levichevdmitry/spirt_v2/foto/20170216_203848.jpg

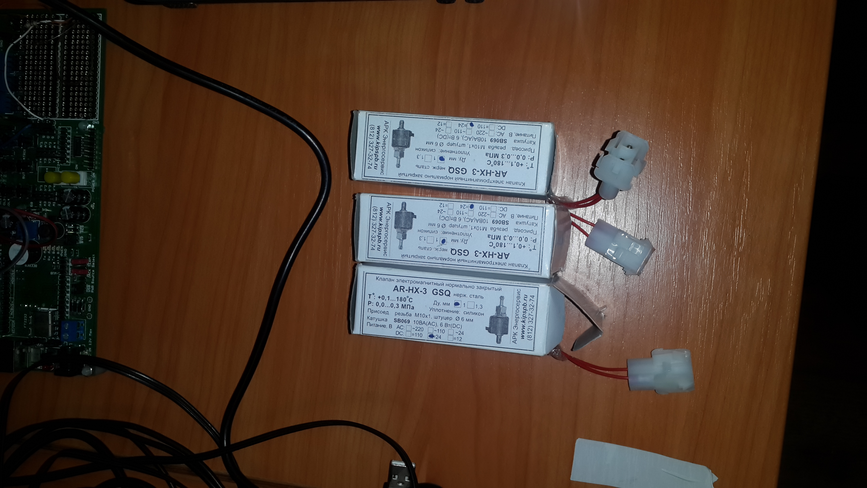
foto/20170216_203848.jpg
