levichevdmitry/spirt_v2/foto/20170225_220355.jpg

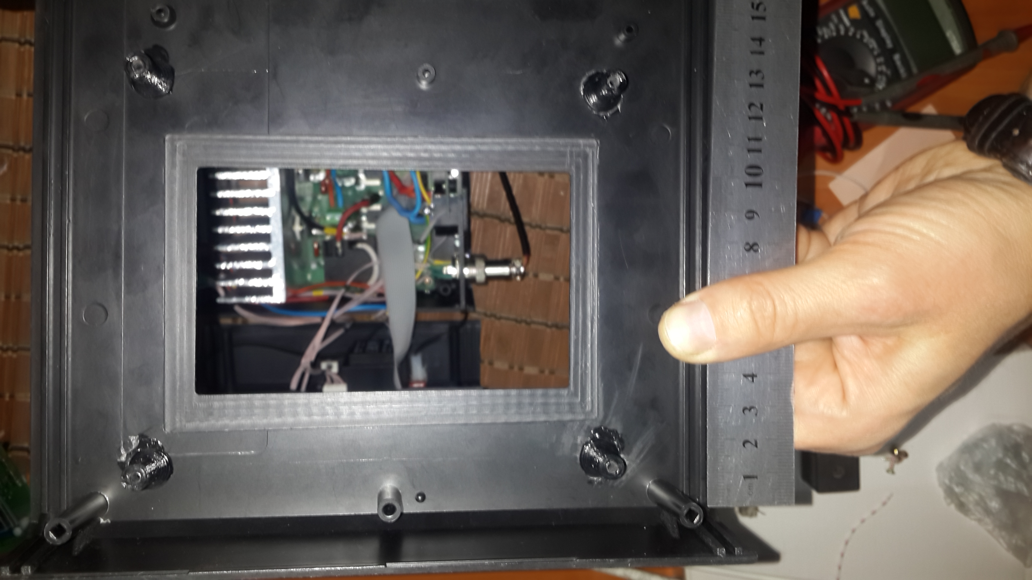
foto/20170225_220355.jpg
