levichevdmitry/spirt_v2/general_hw/Спецификации/доп элементы.docx

№ пп | Наименование | Референс | Количество | Корпус | Фото | Ссылка

Датчики

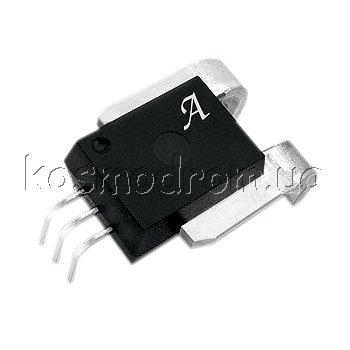
[picture p3: figure]

| ACS758LCB-050B-PFF-T Датчик тока Ток - чувствительный 50A. Точность -1.2% ~ 2%. Чувствительность 40mV/A. Ток выходной 10mA. Тип Чувствительного элемента Open Loop Current Transducers. Напряжение питания 3 V ~ 5.5 V. Частота 120kHz. | ACS758LCB-050B-PFF-T | 1 | 5-PINMODULEPFF | | http://kosmodrom.com.ua/prodlist.php?page=0&name=ACS758&okbutton=%CF%EE%E8%F1%EA+%EF%EE+%F1%EA%EB%E0%E4%F3

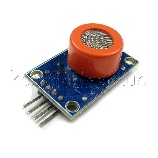
[picture p4: figure]

| Analog Alcohol Sensor-MQ3 Детекторы газа Аналоговый датчик газа: алкоголь, бензин | MQ3 | 1 | Датчик паров | | http://www.kosmodrom.com.ua/el.php?name=AASMQ3
| Штекер 3.5 (наушники) стерео металл, золото | | 3 | Подключение датчиков температуры | | http://aliot.com.ua/?item=32672&cat=4577

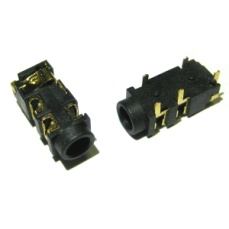
[picture p5: figure]
Гнездо 3.5 (наушники) на плату 5pin

| Гнездо 3.5 (наушники) на плату 5pin | | 6 | | | http://aliot.com.ua/?item=32220&cat=4577

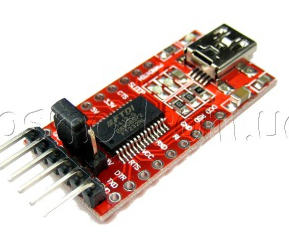
[picture p6: figure]

| USB/UART модуль на основе FT232RL с разъемом miniUSB | | 2 | | | http://kosmodrom.com.ua/el.php?name=FT232RL-MINI-ARDUINO

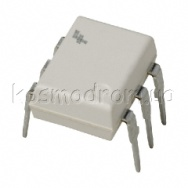
[picture p7: figure]

| MOC3043M Твердотельные реле Твёрдотельное реле: 400В, 0.1 А | MOC3043M | 4 | DIP6-300 | | http://kosmodrom.com.ua/el.php?name=MOC3043M
| Твердотельные реле для установки на панель MOC3023M | MOC3023M | 4 | DIP6-300 | | http://kosmodrom.com.ua/el.php?name=MOC3023M

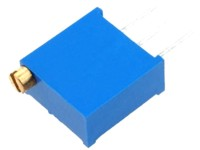
[picture p8: figure]

| 3296W-10K Резистор подстроечный 3296W Потенциометр многооборотный 3/8 10кОм серия 3296W | | 10 | 3296W | | http://kosmodrom.com.ua/el.php?name=3296W-10K

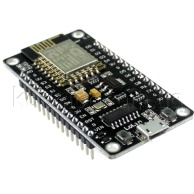
[picture p9: figure]

| Модуль WI-FI ESP8266-NodeMcu | | 2 | | | http://kosmodrom.com.ua/el.php?name=ESP8266-NodeMcu
| Беспроводной контроллер доступа MFRC-522-RFID-KIT | | 1 | | | http://kosmodrom.com.ua/el.php?name=MFRC-522-RFID-KIT
