levichevdmitry/spirt_v2/power_module/src/stm32/readme.txt

ПО для силового модуля контроллера "Спирт" вер. 2

Версия 0.1.1 от 16.03.17
Реализован базовый функционал:
- Обмен и управление по протоколу Wake
- ПИД регулятор для ТЭНов 2,3
- Измерение среднекваратичного значения токов для ТЭНов и функция скользящего среднего с окном в 2 секунду
- Расчет мощности ТЭНов.
- Работа с датчиком температуры DS18B20

Необходимые доработки:
- сделать алгоритм автоматической калибровки датчиков тока при отключенных нагрузках.
- сделать автоматическое измерение опорного напряжение и изменить расчет сигнала датчиков тока на основе полученного значения.
- исправить алгоритм расчета температуры процессора.
- разработать алгоритм автоматического подхвата датчика температуры.

Версия 0.2 от 27.03.17
Реализованы следующие функции:
- Возможность скомпилировать с 2-мя разными методами управления мощностью ТЭН 2 ШИМ или алгорим Бренхема
- Точность регулирования уменьшена до 1 %, а цикл регулирования уменьшен до 1 сек.
- Добавлена возможность компиляции с экспоненциальным фильром  для расчета мощности для ТЭНа 2
- При выключенном ТЭНе 2 значение с датчика тока приравнивается 0.
- Управляющий импульс отпирания симисторов в 5 мс формирмируется таймером 6.
- Протестирован алгоритм подхвата датчика. Алгоритм работоспособный в рамках тестов.

Аппаратные изменения Rev A.0
- Емкости в ФНЧ датчиков тока уменьшены до 47нФ.
- Добавлен дросель в цепи 5 В для птания датчиков тока.
- ИИП от блока управления зашумляет питание, что влечет не корректные измерения тока. "Иглы" помех достигают амплитуды 0,7В 
в цепях питания датчиков тока
- В цепях управления ТЭНами индикаторные светодиоды заменены на красные с меньшим падением напряжения, в следствии чего
сопротивления в 5,6 Ом были оставлены, а надежность коммутации выросла
- Оптосимистор для канала ТЭНа 2 был заменен с MOС3042 на MOC3022 (без втроенного детектора ноля), на случай перехода на СИФУ
- Произведена тестовая настройка ПИД регулятора для стабидизации мощности Кп - 0.61  Ки - 0.2

Необходимые доработки:
- сделать алгоритм автоматической калибровки датчиков тока при отключенных нагрузках.
- сделать автоматическое измерение опорного напряжения и изменить расчет сигнала датчиков тока на основе полученного значения.

Версия 0.21 от 18.04.17
Реализованы следующие функции:
- исправлен алгоритм расчета температуры процессора.

Версия 0.3 от 13.01.18
Реализованы следующие функции:
- исправлена ошибка с некоректным состоянием бита подключенного датчика температуры (теперь в нем 1 при подключенном датчике)
- добавлена обработка отсутсвия датчика температуры, если он отвалился или не подключен вообще, то включаем вентилятор совместно
с насосом.
- увеличен до 2 с. интервал между опросом датчика температуры охлаждающей жидкости.
- добавлен обработчик ошибки ORE для USART 1-wire

TO DO:
- корректный алгоритм расчета мощности (тока)
- нормальная реализация ПИД регулятора, хотя вожможно это не понадобиться, если ОС по току станет без всплексков.
