levichevdmitry/spirt_v2/info/Обмен с Wi-Fi модулем.docx

Отправка данных из контроллера в модуль Wi-Fi осуществляется через UART в формате данных JSON. Структура данных выглядит следующим образом:

{

mode:1,

smode:5,

time:”00:10:00”,

t_elapsed:20,

q_fact:180,

v_get:1230,

t_kub:73.5,

p_kub:8.5,

t_koln:45.6,

t_kolv:40.7,

t_oj:20,

f_oj:1.8,

pwr:4.31,

alcopdk:false,

stop_cnt:0,

eta:#AF23

}

Описание полей:

mode – код режима работы аппарата.

smode – код итерации в текущем режиме.

time – время работы в данном режиме.

t_elapsed – время в текущей итерации в мин.

q_fact – фактически отобранный объем в мл.

v_get – скорость отбора в мл/ч.

t_kub – температура в кубе.

p_kub – давление в кубе.

t_koln – температура низа колонны.

t_kolv – температура верха колонны.

t_oj – температура охлаждающей воды.

f_oj – расход воды через дефлегматор.

pwr – подводимая мощность.

alcopdk – статус датчика спирта.

stop_cnt – количество остановок при отборе во время ректификации.

eta – слово состояния силового блока (расшифровку битов смотреть в документе по протоколу Wake)
