levichevdmitry/spirt_v2/general_hw/Спецификации/Спецификация_компоненты_ремонт.docx

Спецификация элементов для ремонта силового блока

№ | Наименование | Референс | Кол-во | Примечание | Фото | Ссылка


| BTA204S-600E.118 Симистор Тип симистра: Logic - Sensitive Gate: Конфигурация: Single: Ток - удержания (макс.): 12mA: Напряжение - закрытого состояния: 600В | BTA204S-600E.118 | 6 | DPAK | | http://kosmodrom.com.ua/el.php?name=BTA204S-600E.118


| (CL-21) 0,01 mkf - 630v (±10%) Металлоплёнка Конденсаторы металлопленочные CL21 (MEF) Конденсатор металлопленочный полиэстеровый: 0,01 мкф. 630 В. 10 %. | | 5 | | | http://kosmodrom.com.ua/el.php?name=CL-21-0.01-630-10


| BH-16 Разъемы IDC/BH Вилка в плату 16 конт. шаг 2.54мм | BH-16 | 5 | | | http://kosmodrom.com.ua/el.php?name=BH-16


| 0216001.MXP Предохранитель плавкий Предохранитель: плавкая вставка: замедленного действия: 1А, 250 В. | 0216001.MXP | 4 | 5 х 20 мм | | http://kosmodrom.com.ua/el.php?name=0216001.MXP
| 0216002.MXP Предохранитель плавкий Предохранитель: плавкая вставка: замедленного действия: 2А, 250 В. | 0216002.MXP | 4 | 5 х 20 мм | | http://kosmodrom.com.ua/el.php?name=0216002.MXP

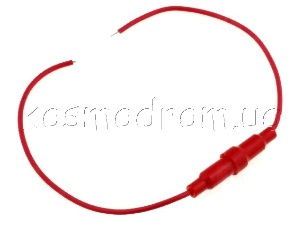
[picture p91: figure]

| ZH9-20ZP Держатель предохранителей | ZH9-20ZP | 4 | | | http://kosmodrom.com.ua/el.php?name=ZH9-20ZP

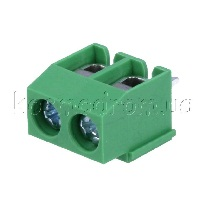
[picture p92: figure]

| Клеммник DEGSON DG126-5.0-02P-14-00AH | DG126-5.0-02P-14-00AH | 6 | | | http://kosmodrom.com.ua/el.php?name=DG126-5.0-02P-14-00AH

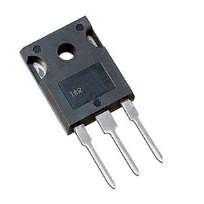
[picture p93: figure]

| Транзистор IGBT производства IR IRG4PC50UDPBF | IRG4PC50UDPBF | 2 | | | http://kosmodrom.com.ua/el.php?name=IRG4PC50UDPBF

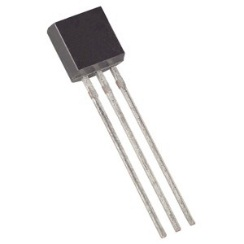
[picture p94: figure]

| 2SA1015 Транзистор биполярный | 2SA1015 | 4 | | | http://kosmodrom.com.ua/prodlist.php?page=0&name=a1015&okbutton=%CF%EE%E8%F1%EA+%EF%EE+%F1%EA%EB%E0%E4%F3
