levichevdmitry/spirt_v2/3d_models/korpus/G771/g769_g770_g771.pdf

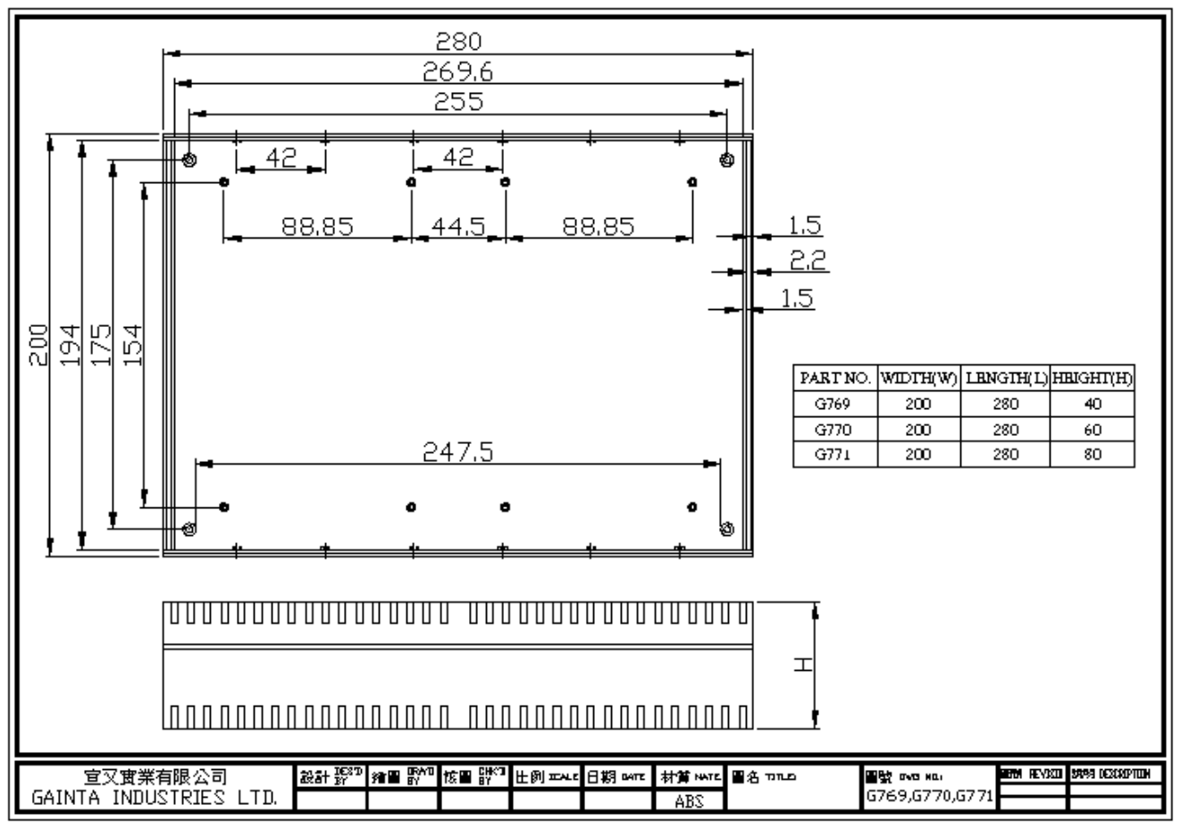
[picture p95: page 1]
