levichevdmitry/spirt_v2/foto/20170102_151930.jpg

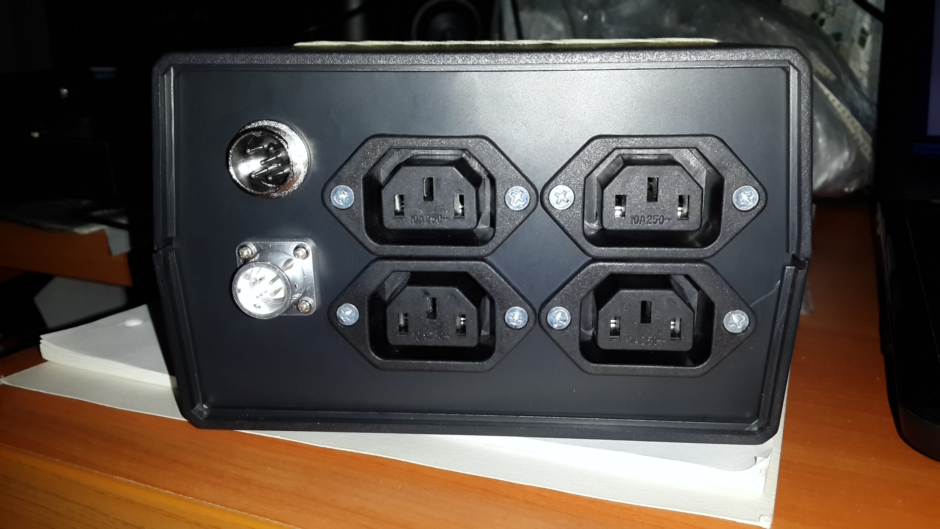
foto/20170102_151930.jpg
