levichevdmitry/spirt_v2/foto/20170102_151950.jpg

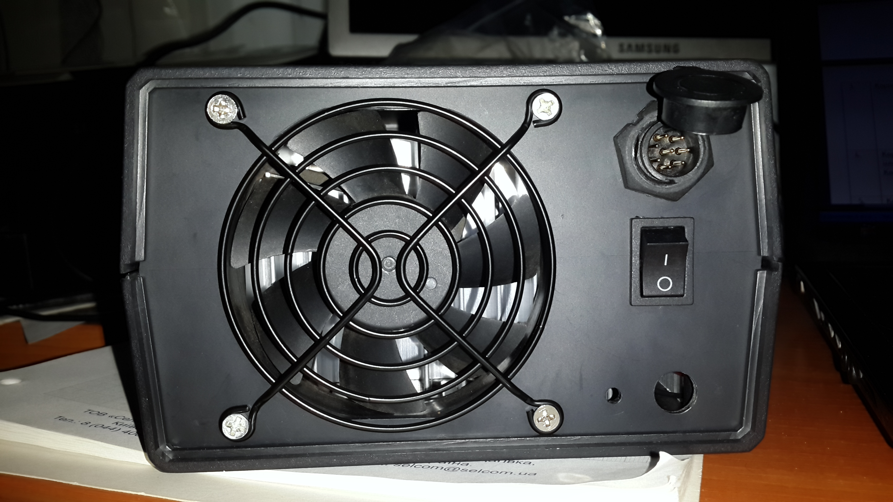
foto/20170102_151950.jpg
