levichevdmitry/spirt_v2/foto/20170104_195338.jpg

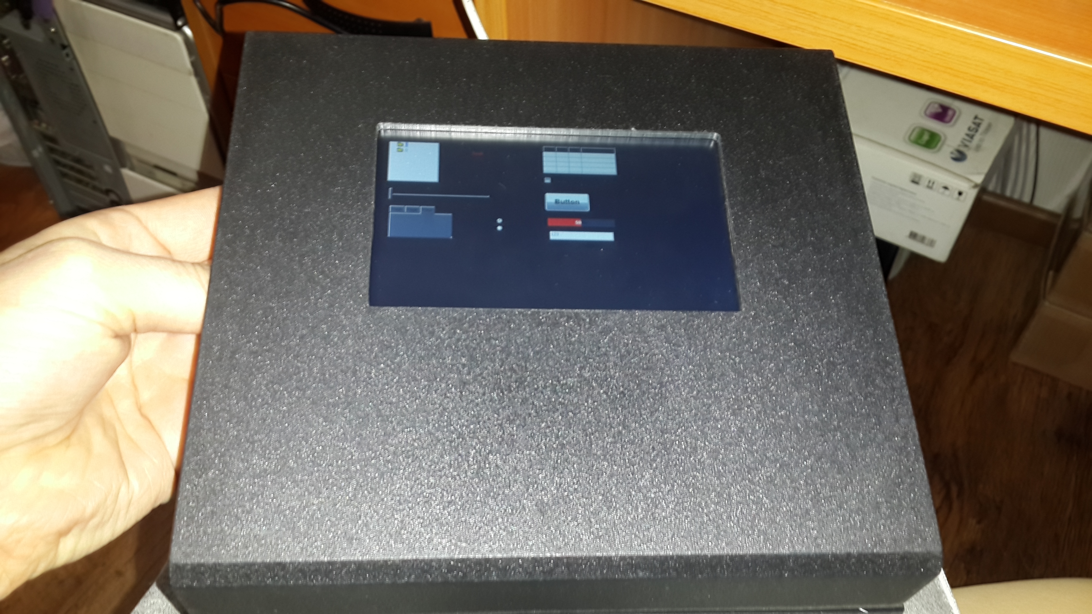
foto/20170104_195338.jpg
