levichevdmitry/spirt_v2/foto/20170129_213145.jpg

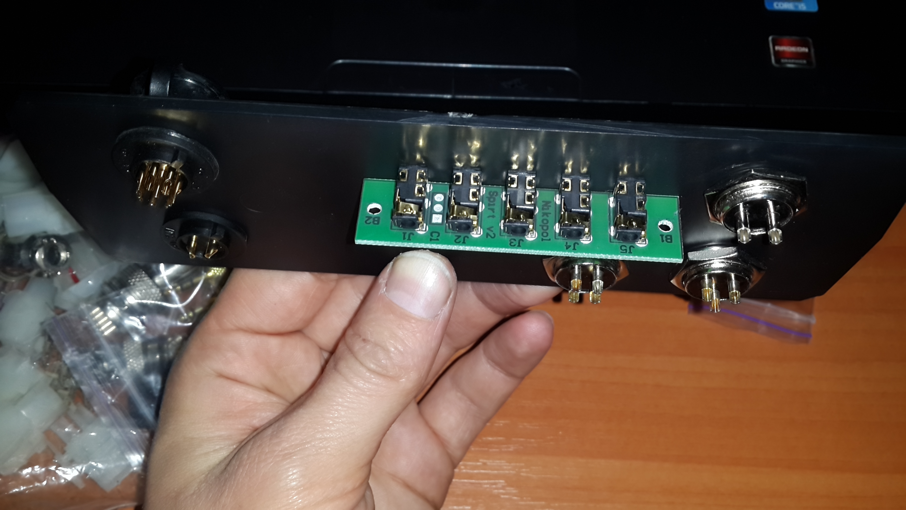
foto/20170129_213145.jpg
