levichevdmitry/spirt_v2/foto/20170201_000536.jpg

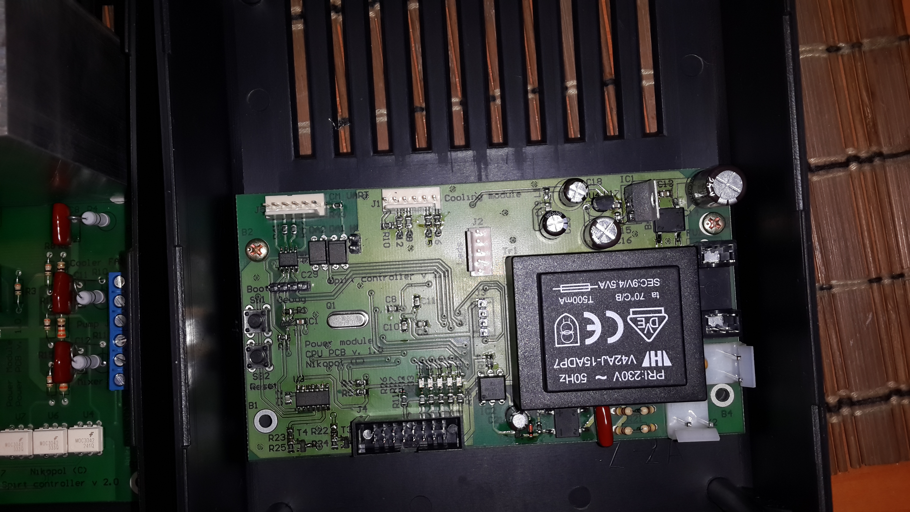
foto/20170201_000536.jpg
