levichevdmitry/spirt_v2/foto/20170201_000550.jpg

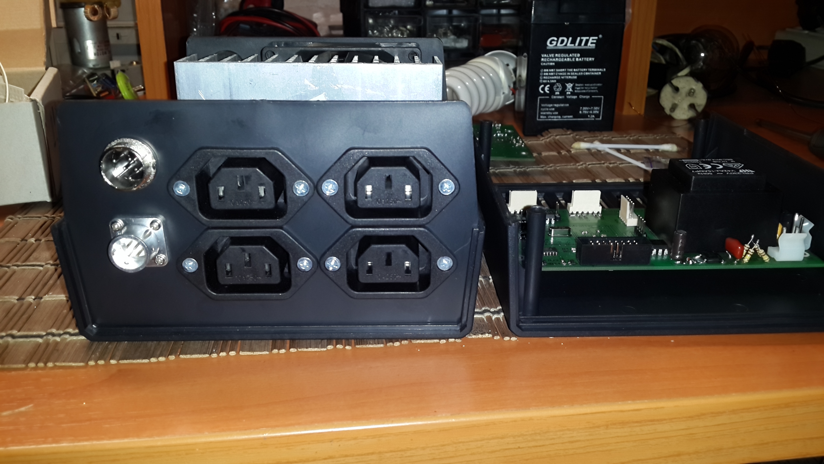
foto/20170201_000550.jpg
