levichevdmitry/spirt_v2/foto/20170204_110750.jpg

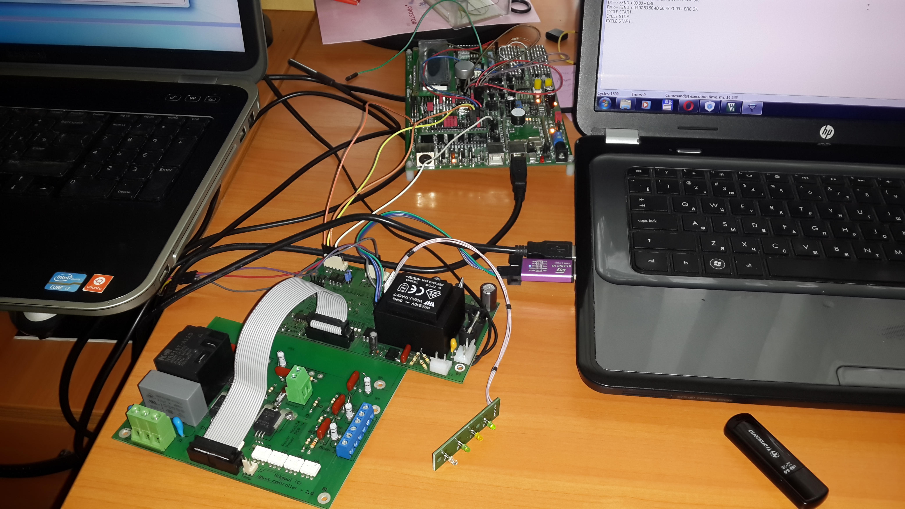
foto/20170204_110750.jpg
