levichevdmitry/spirt_v2/foto/20170205_154931 - копия.jpg

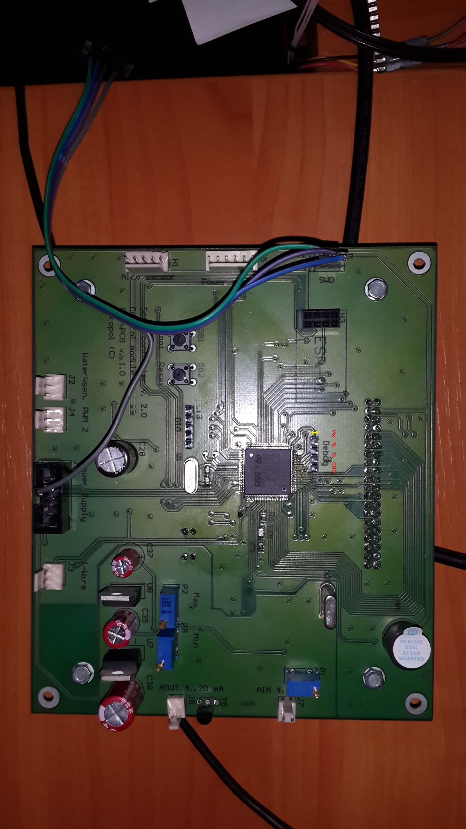
foto/20170205_154931 - копия.jpg
