levichevdmitry/spirt_v2/foto/20170205_154945.jpg

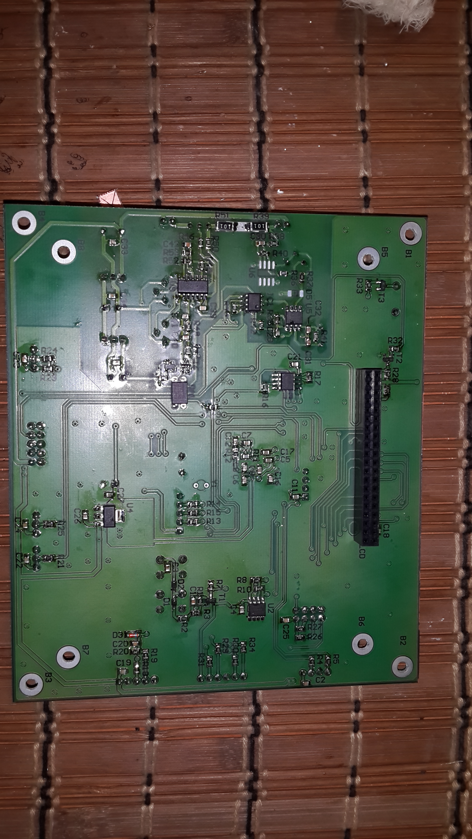
foto/20170205_154945.jpg
