levichevdmitry/spirt_v2/foto/20170205_160607.jpg

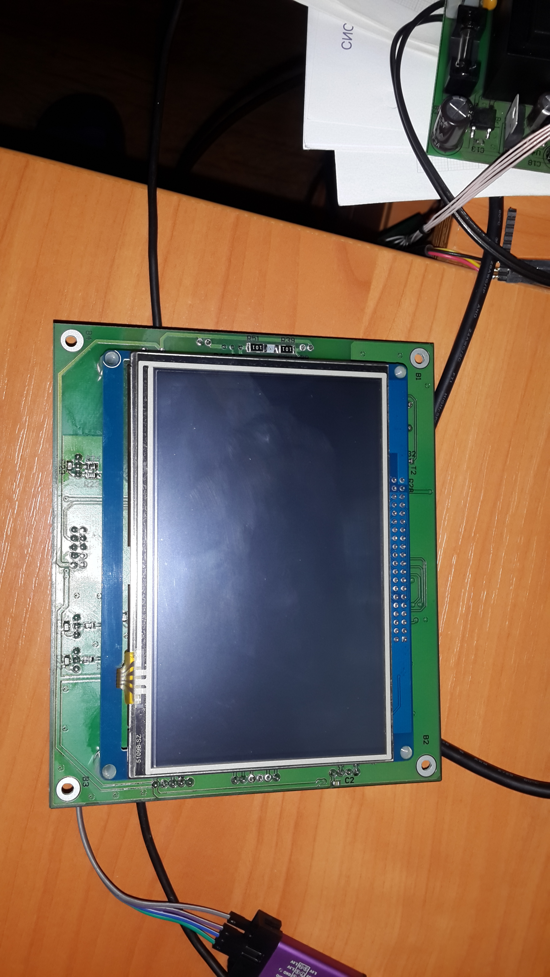
foto/20170205_160607.jpg
