levichevdmitry/spirt_v2/foto/20170208_192222.jpg

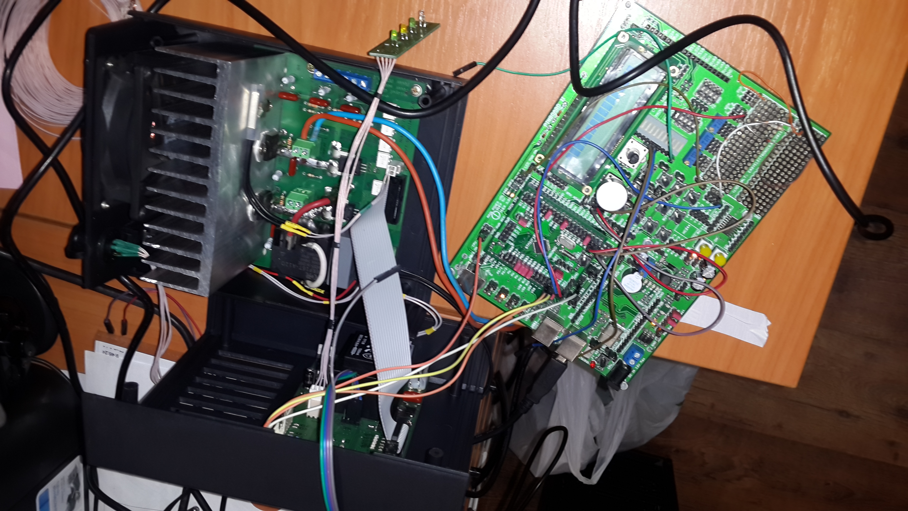
foto/20170208_192222.jpg
