levichevdmitry/spirt_v2/foto/20170212_151312.jpg

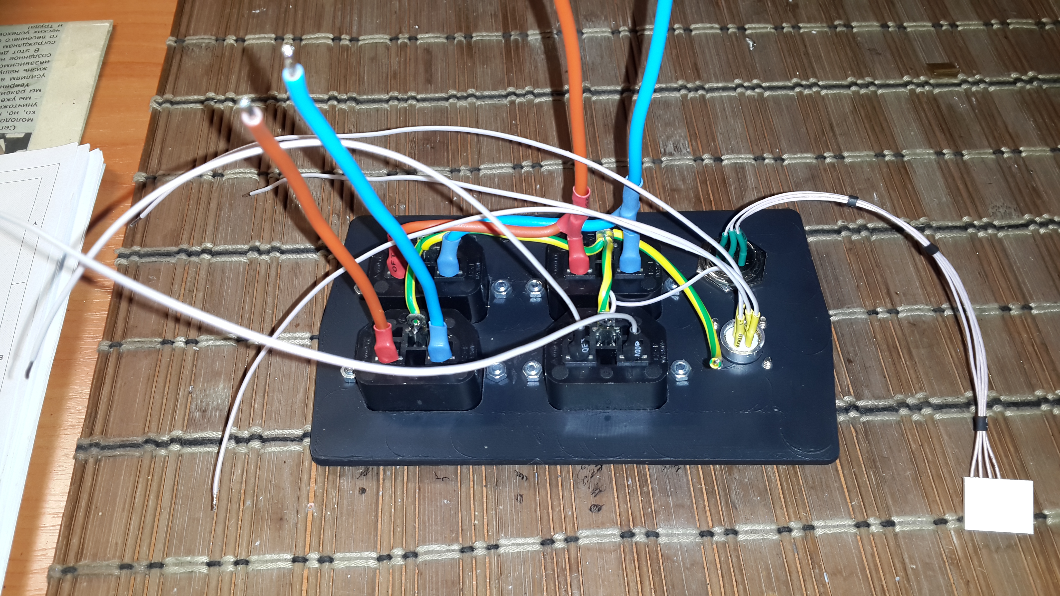
foto/20170212_151312.jpg
