levichevdmitry/spirt_v2/foto/20170213_213228.jpg

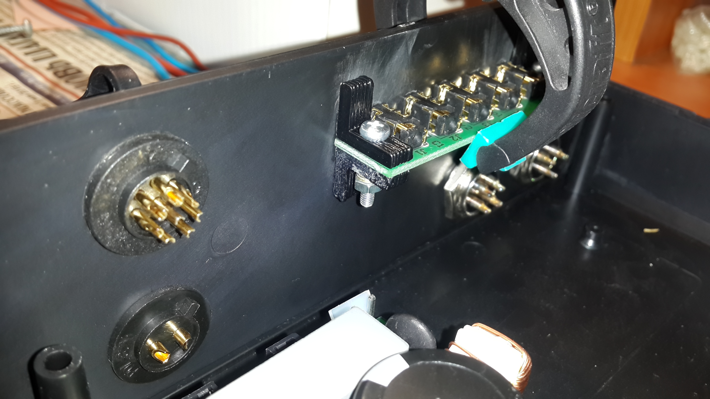
foto/20170213_213228.jpg
