levichevdmitry/spirt_v2/foto/20170214_220130.jpg

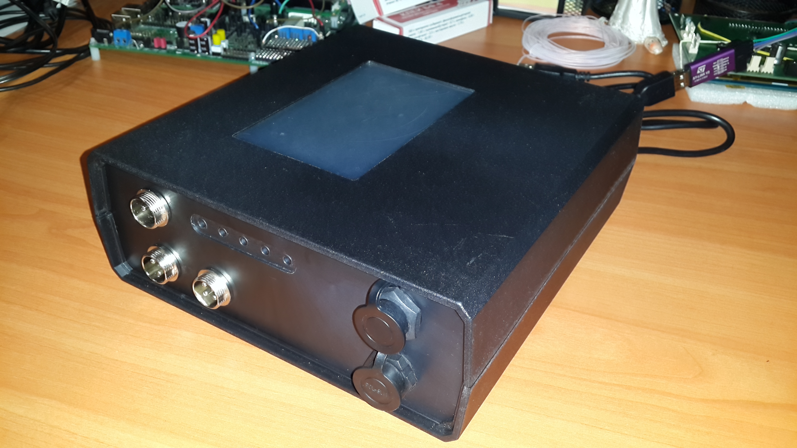
foto/20170214_220130.jpg
