levichevdmitry/spirt_v2/foto/20170214_220557.jpg

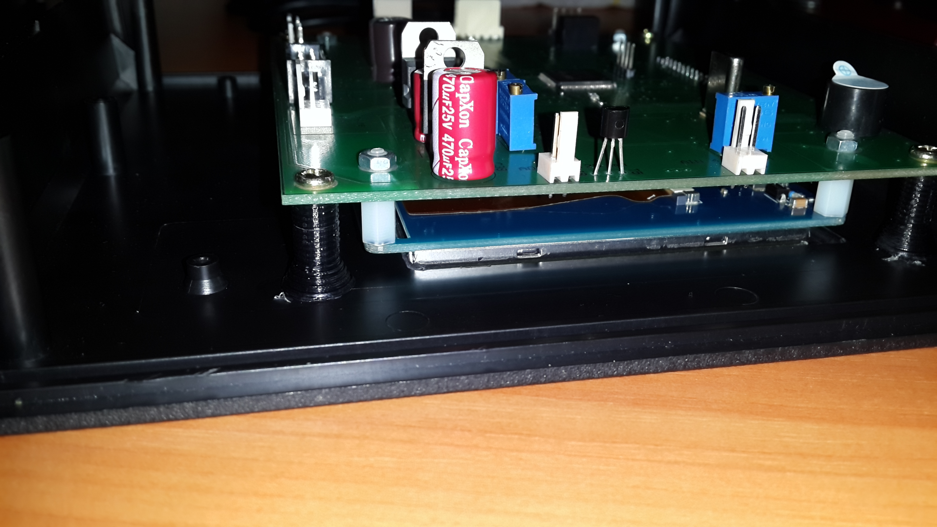
foto/20170214_220557.jpg
