levichevdmitry/spirt_v2/foto/20170214_220602.jpg

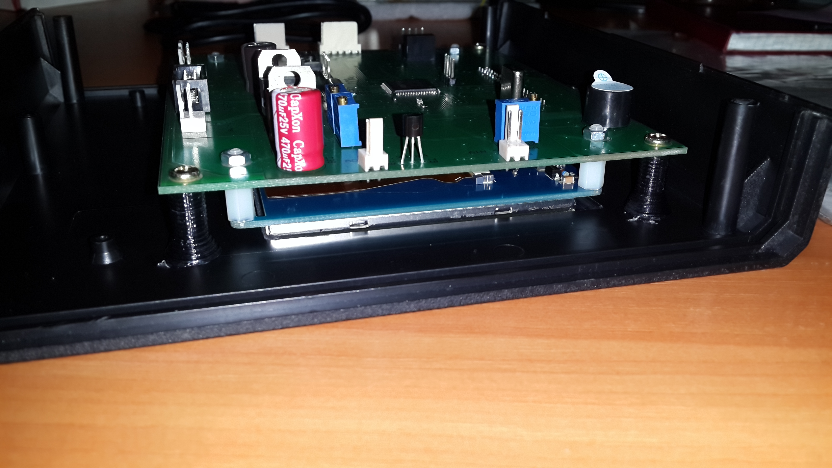
foto/20170214_220602.jpg
