levichevdmitry/spirt_v2/foto/20170216_203724.jpg

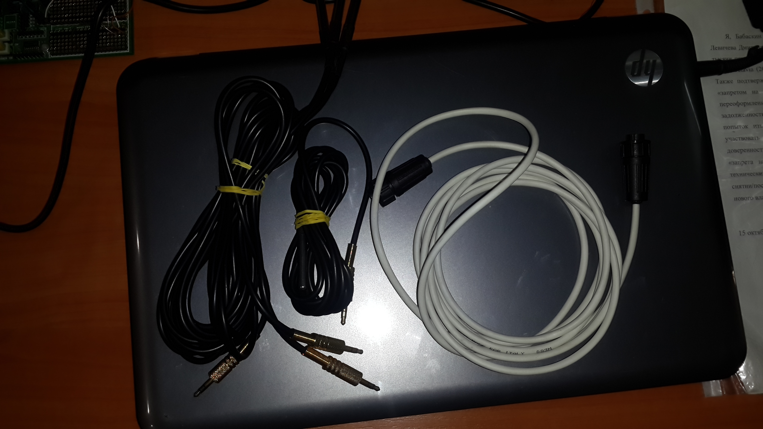
foto/20170216_203724.jpg
