levichevdmitry/spirt_v2/foto/20170216_203816.jpg

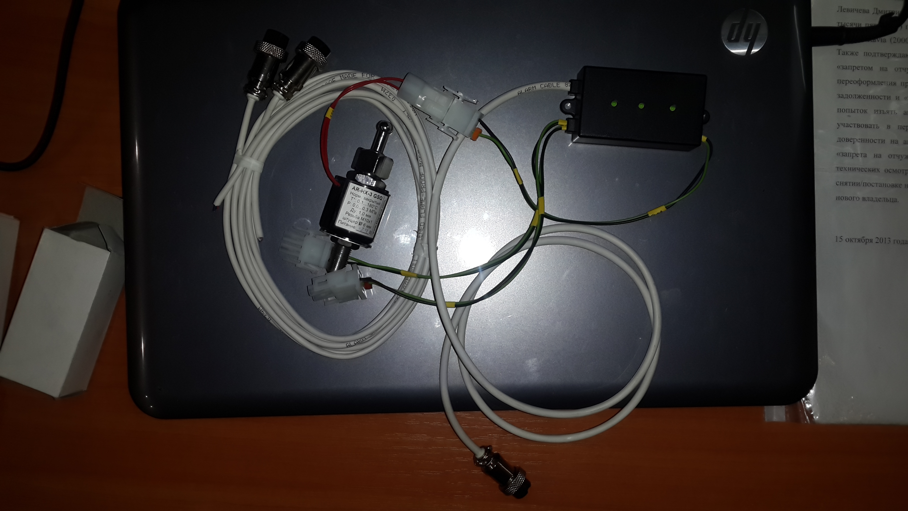
foto/20170216_203816.jpg
