levichevdmitry/spirt_v2/foto/20170216_203923.jpg

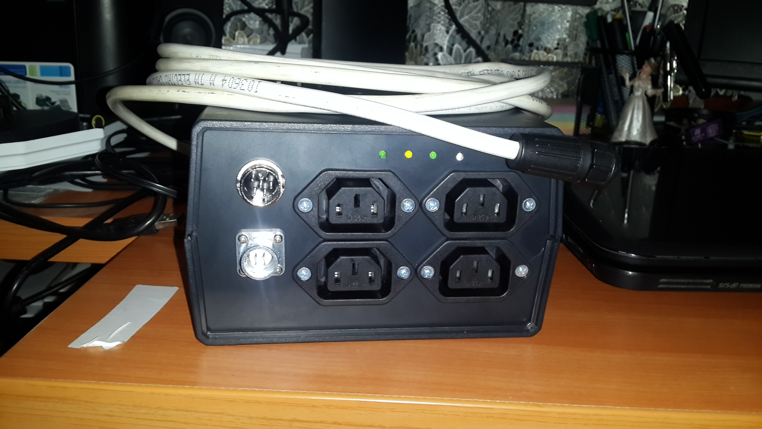
foto/20170216_203923.jpg
