levichevdmitry/spirt_v2/foto/20170217_140453.jpg

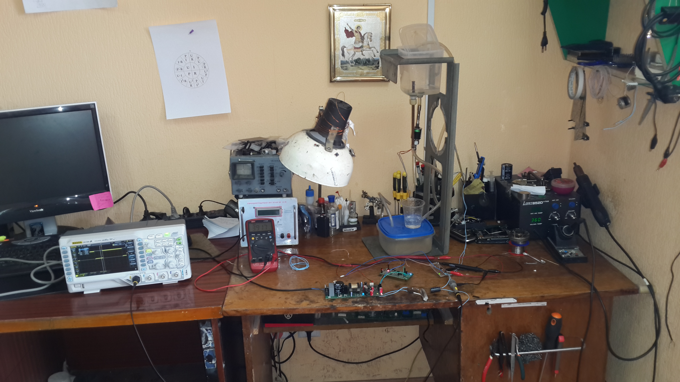
foto/20170217_140453.jpg
