levichevdmitry/spirt_v2/foto/20170217_222517.jpg

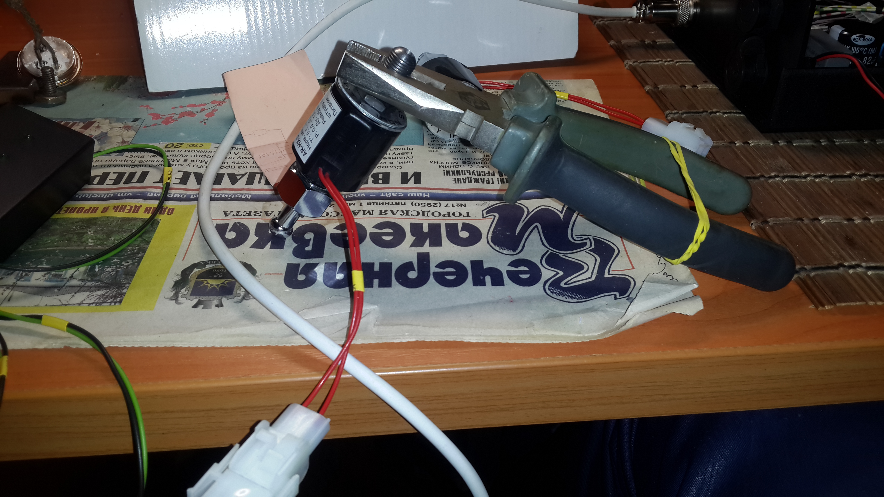
foto/20170217_222517.jpg
