levichevdmitry/spirt_v2/foto/20170218_145839.jpg

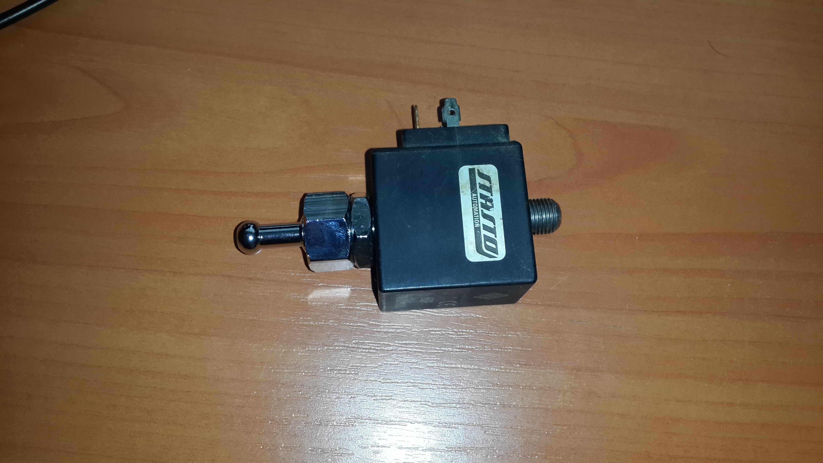
foto/20170218_145839.jpg
