levichevdmitry/spirt_v2/foto/20170218_145846.jpg

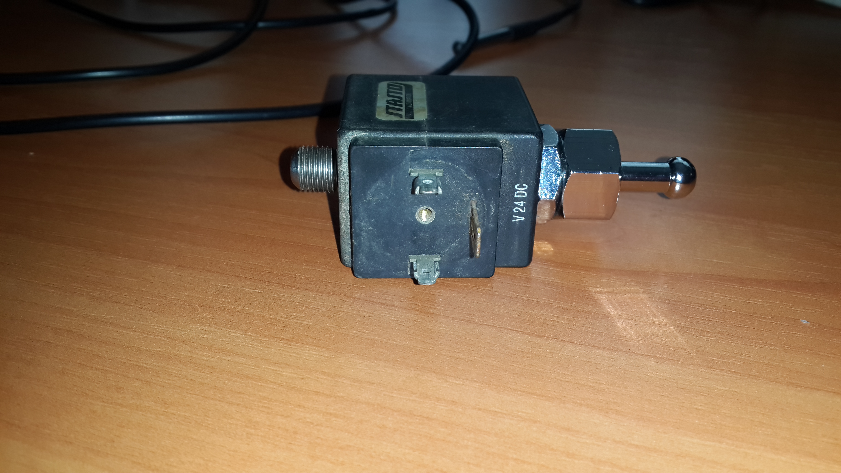
foto/20170218_145846.jpg
