levichevdmitry/spirt_v2/foto/20170219_222843.jpg

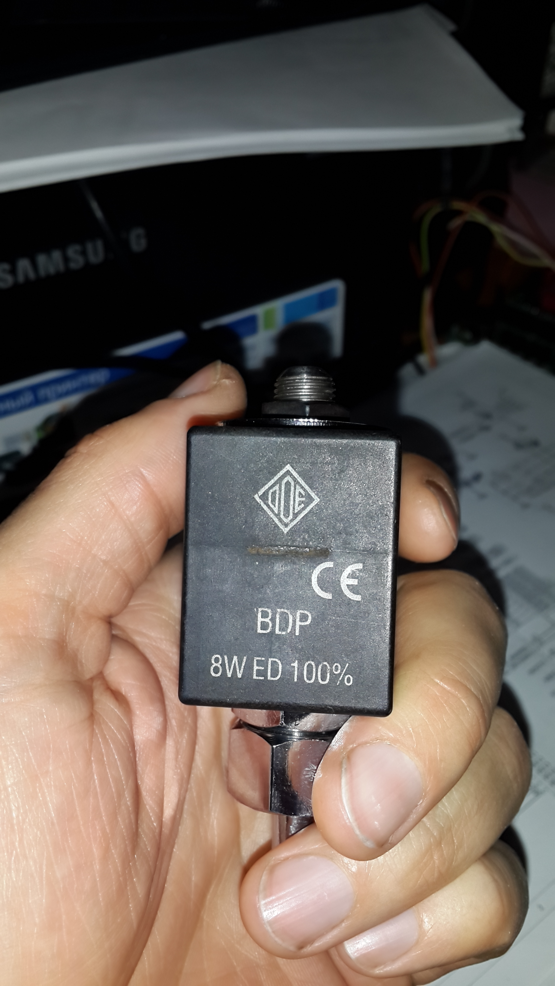
foto/20170219_222843.jpg
