levichevdmitry/spirt_v2/foto/20170225_220423.jpg

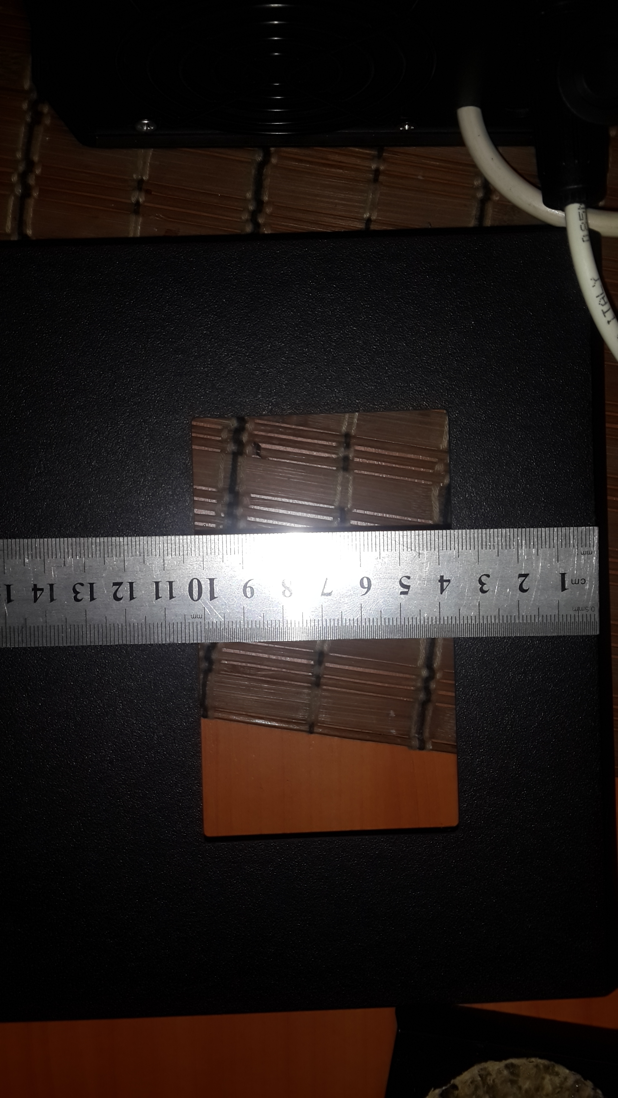
foto/20170225_220423.jpg
