levichevdmitry/spirt_v2/foto/20170225_220429.jpg

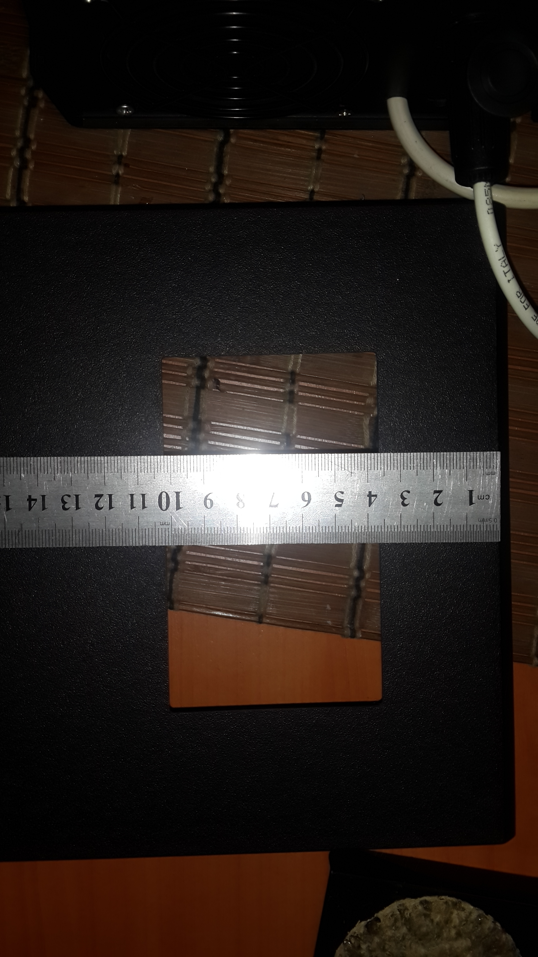
foto/20170225_220429.jpg
