levichevdmitry/spirt_v2/foto/20170225_220451.jpg

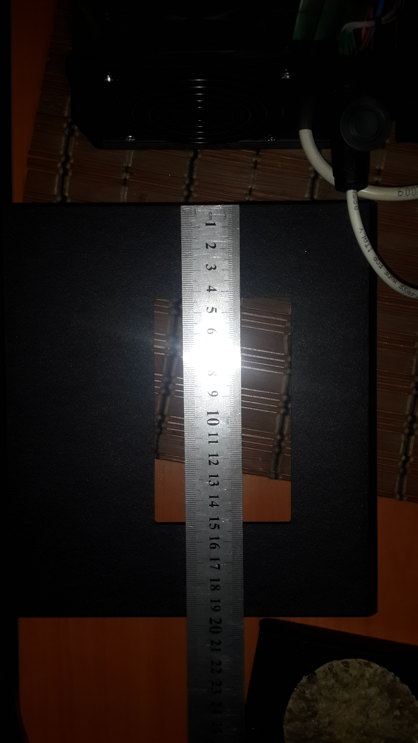
foto/20170225_220451.jpg
