levichevdmitry/spirt_v2/foto/20170225_220456.jpg

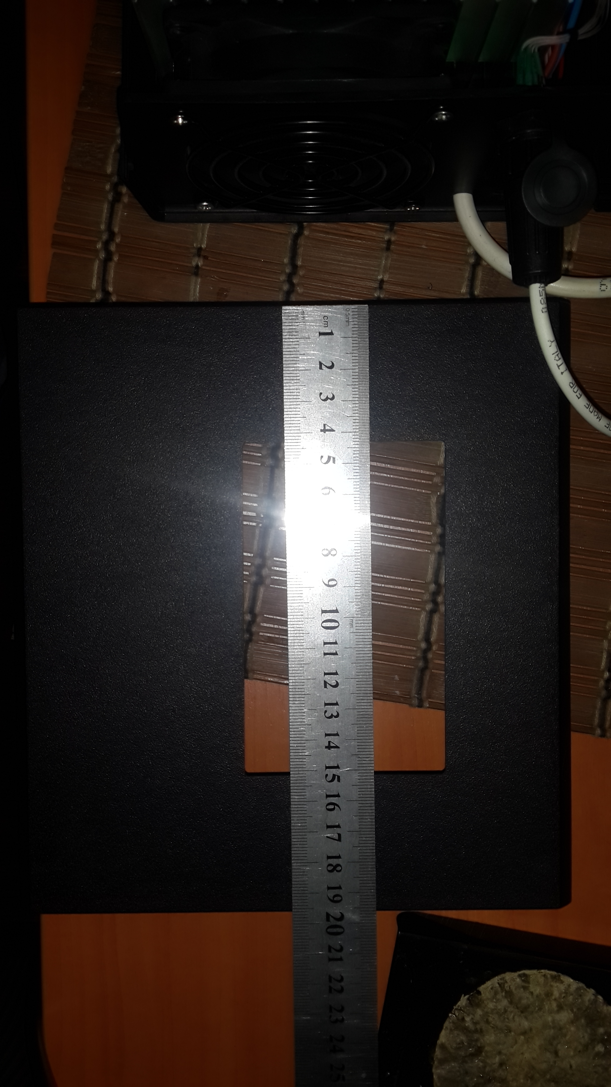
foto/20170225_220456.jpg
