levichevdmitry/spirt_v2/foto/20170303_210058.jpg

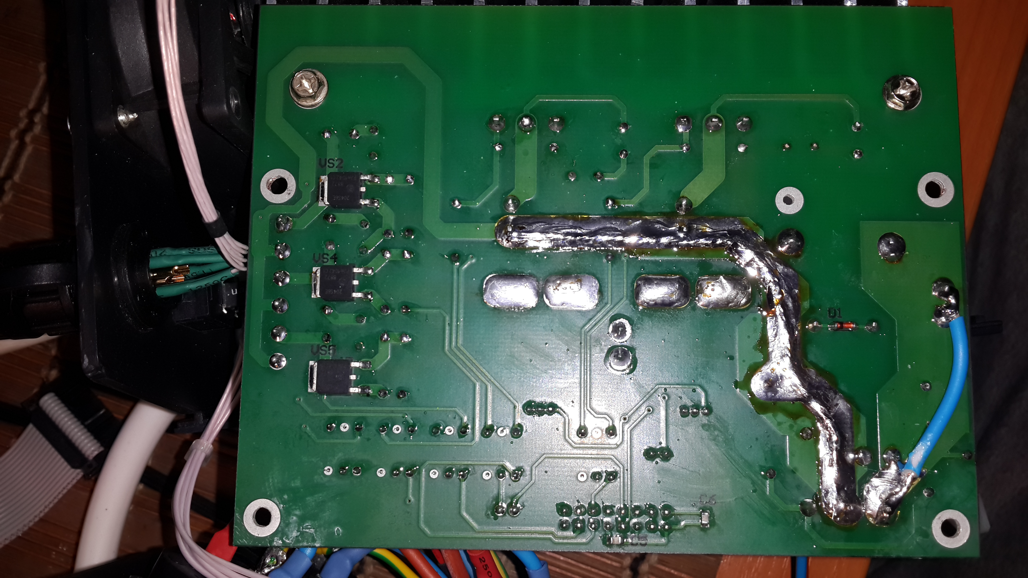
foto/20170303_210058.jpg
