levichevdmitry/spirt_v2/foto/20170304_161741.jpg

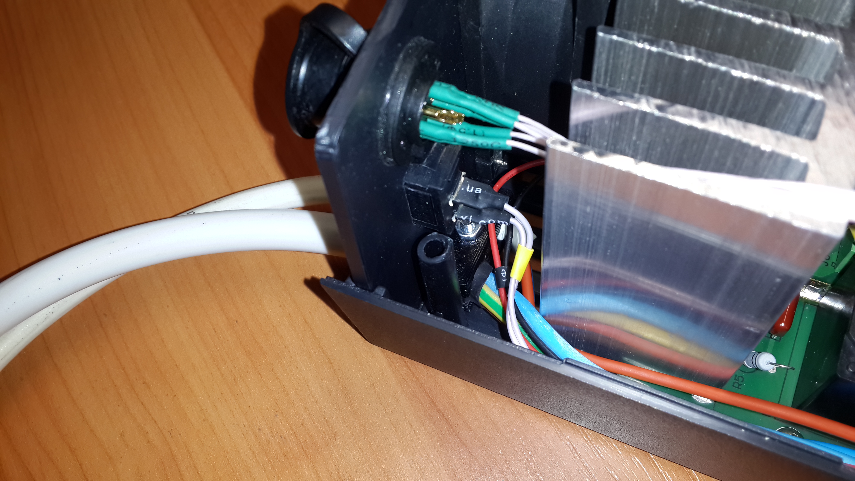
foto/20170304_161741.jpg
