levichevdmitry/spirt_v2/foto/20170304_202234.jpg

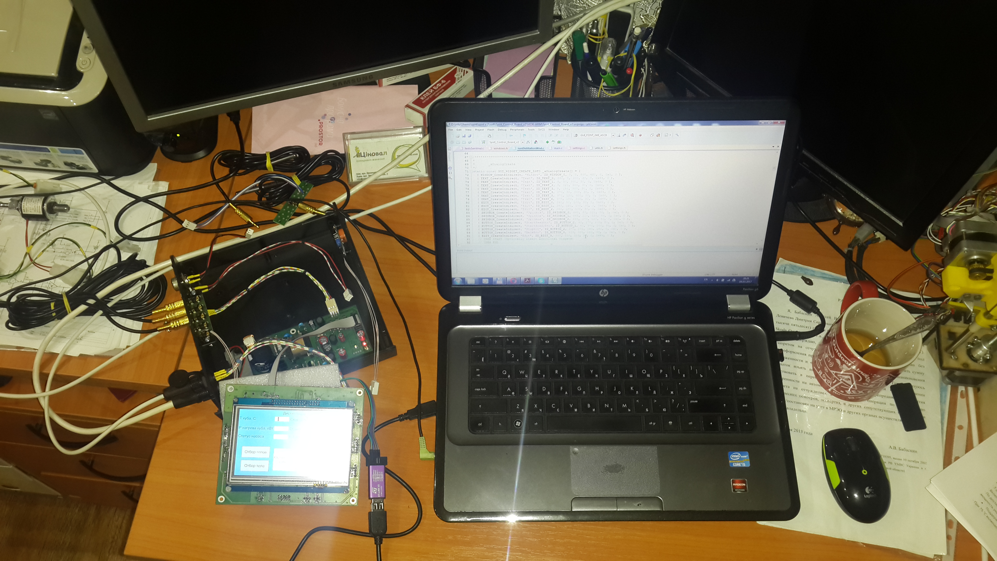
foto/20170304_202234.jpg
