levichevdmitry/spirt_v2/foto/20170309_182747.jpg

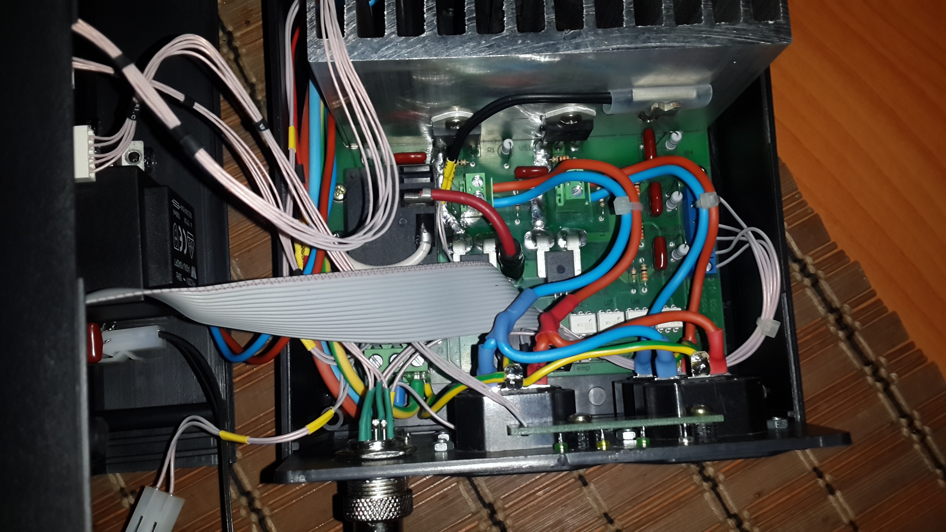
foto/20170309_182747.jpg
