levichevdmitry/spirt_v2/foto/20170309_182814.jpg

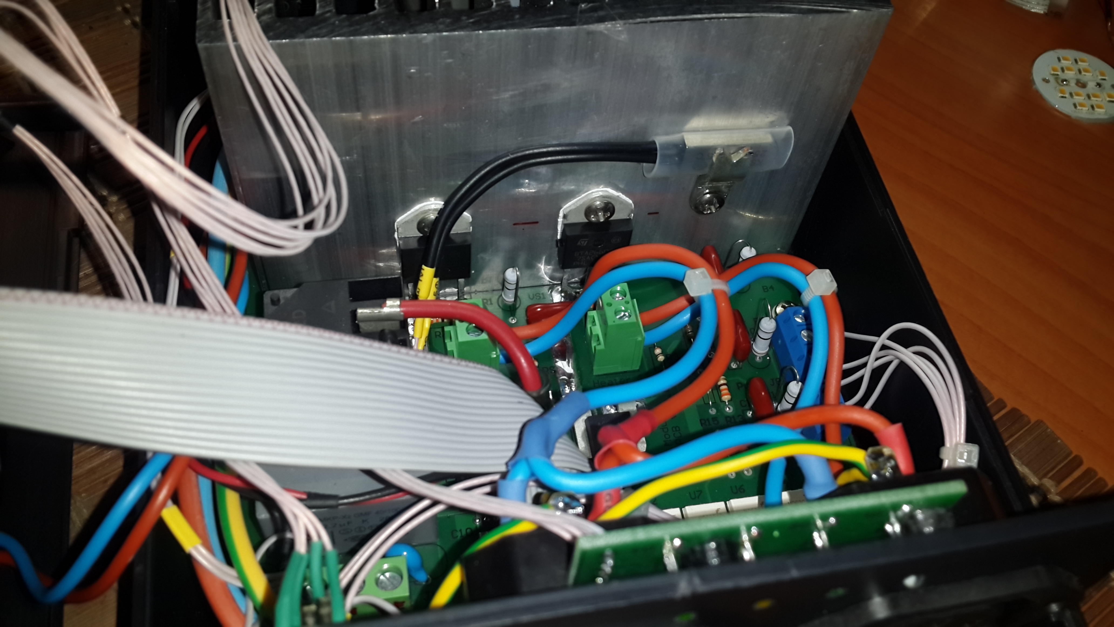
foto/20170309_182814.jpg
