levichevdmitry/spirt_v2/3d_models/lcd tft 50.SLDPRT

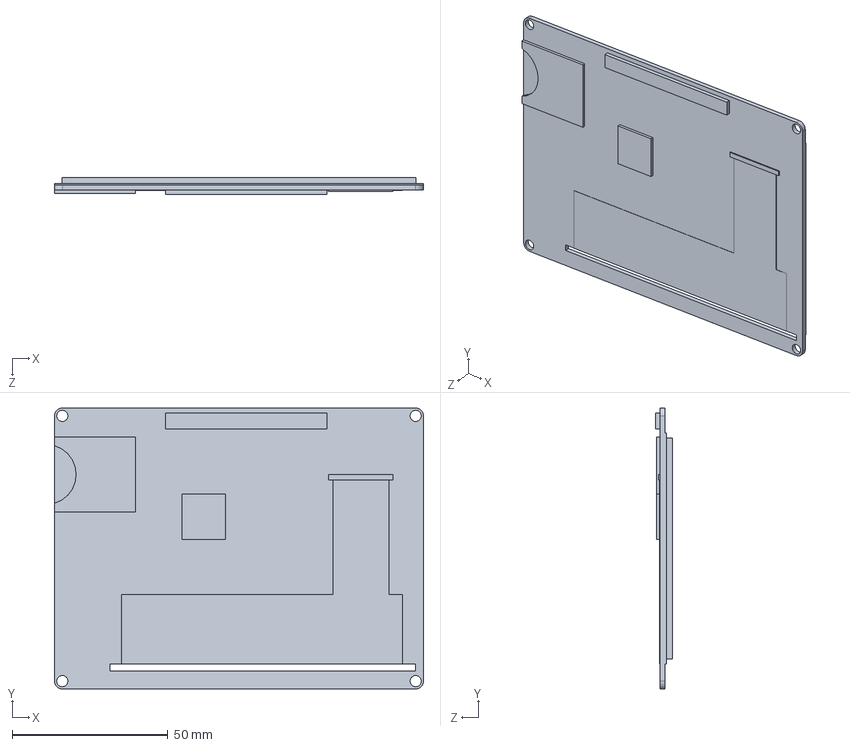
[picture p147: CAD file, 2018-11-18]
3d_models/lcd tft 50.SLDPRT
118.5 x 90.2 x 5.50 mm
