levichevdmitry/spirt_v2/3d_models/Крепление кабеля.stl

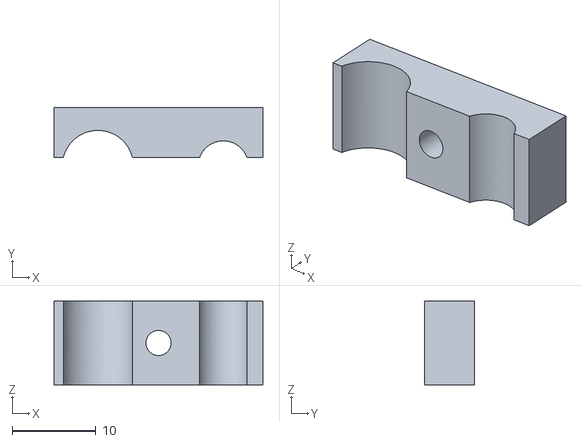
[picture p148: CAD file, 2018-11-18]
3d_models/Крепление кабеля.stl
25.0 x 6.00 x 10.0
