levichevdmitry/spirt_v2/3d_models/Стойка_16мм.stl

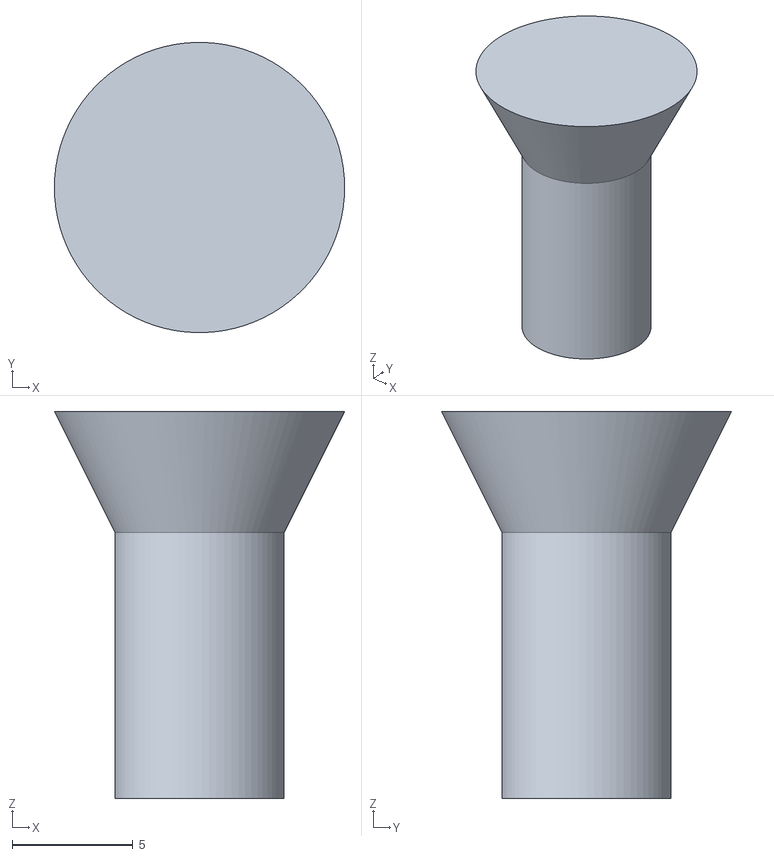
[picture p149: CAD file, 2018-11-18]
3d_models/Стойка_16мм.stl
12.0 x 12.0 x 16.0
