levichevdmitry/spirt_v2/3d_models/Стойка_6мм.stp

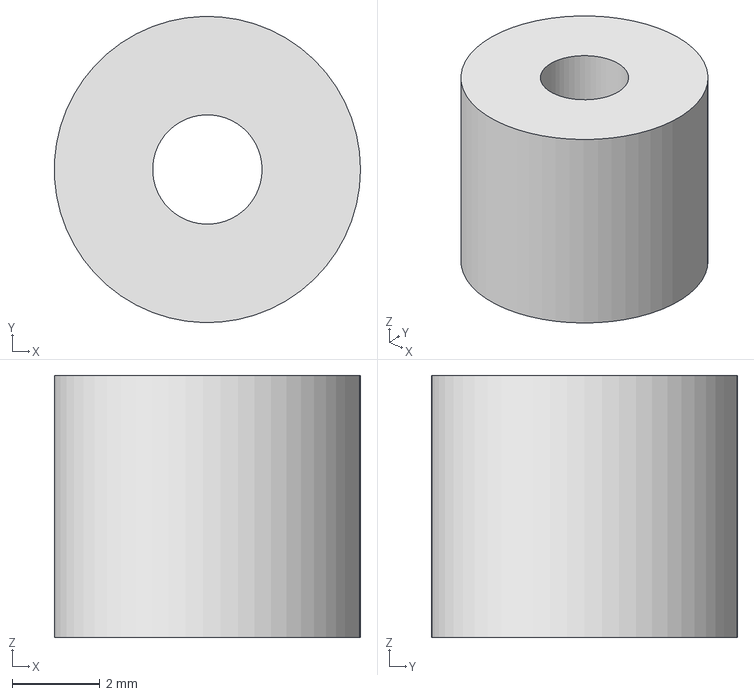
[picture p150: CAD file, 2018-11-18]
3d_models/Стойка_6мм.stp
6.99 x 7.00 x 6.00 mm
