levichevdmitry/spirt_v2/3d_models/Угловой_крепеж.stl

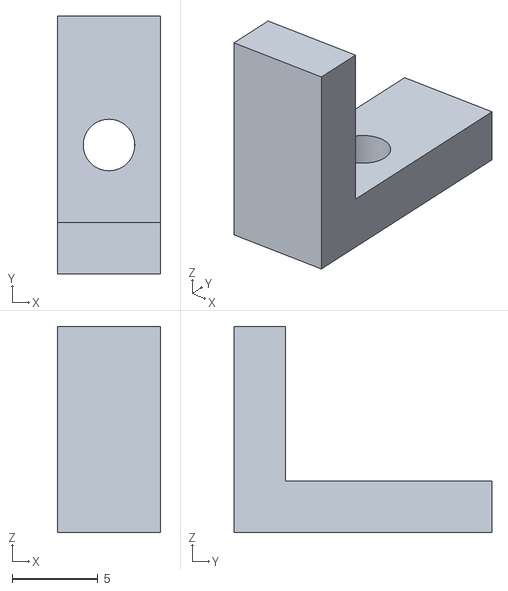
[picture p151: CAD file, 2018-11-18]
3d_models/Угловой_крепеж.stl
6.00 x 15.0 x 12.0
