levichevdmitry/spirt_v2/(list of files, cad)

Other CAD files:
3d_models/OldVersions/Стойка_16мм.0001.ipt
3d_models/Крепление кабеля.ipt
3d_models/Стойка_1.ipt
3d_models/Стойка_16мм.ipt
3d_models/Стойка_6мм.ipt
3d_models/Стойка_6мм.stl
3d_models/Угловой_крепеж.ipt
