levichevdmitry/spirt_v2/control_module/hw/ControlModule/Project Outputs for PowerSupply_Board/Controller_PS_board.PDF

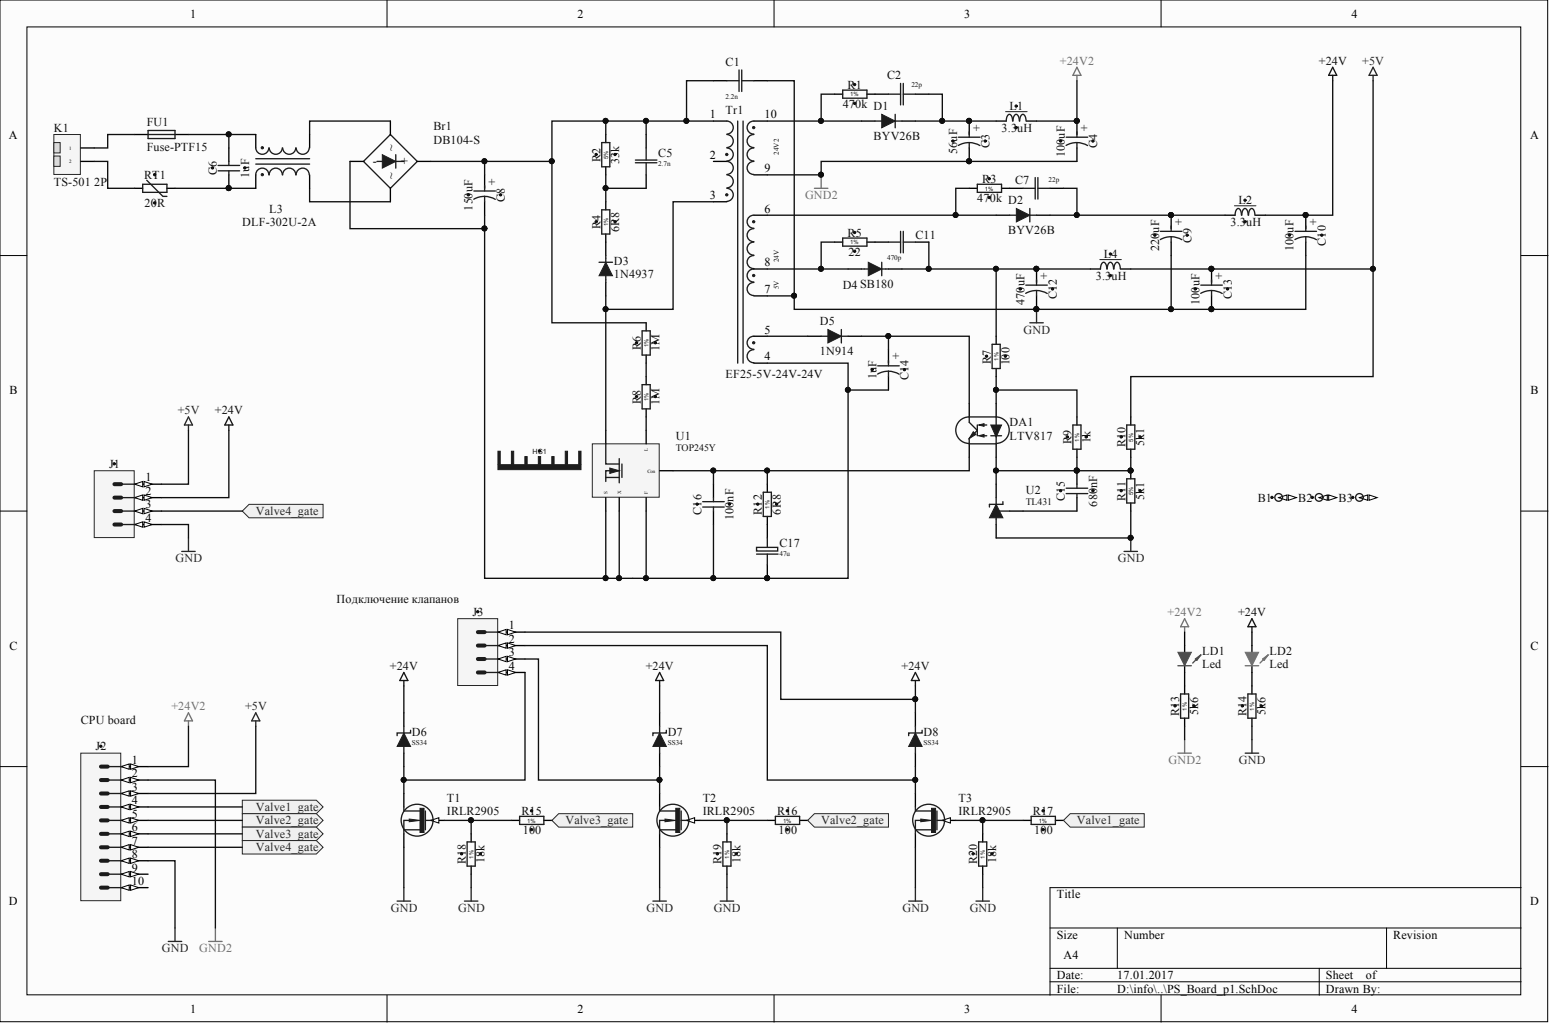
[picture p152: page 1]

1% | BYV26B

4 | +24V

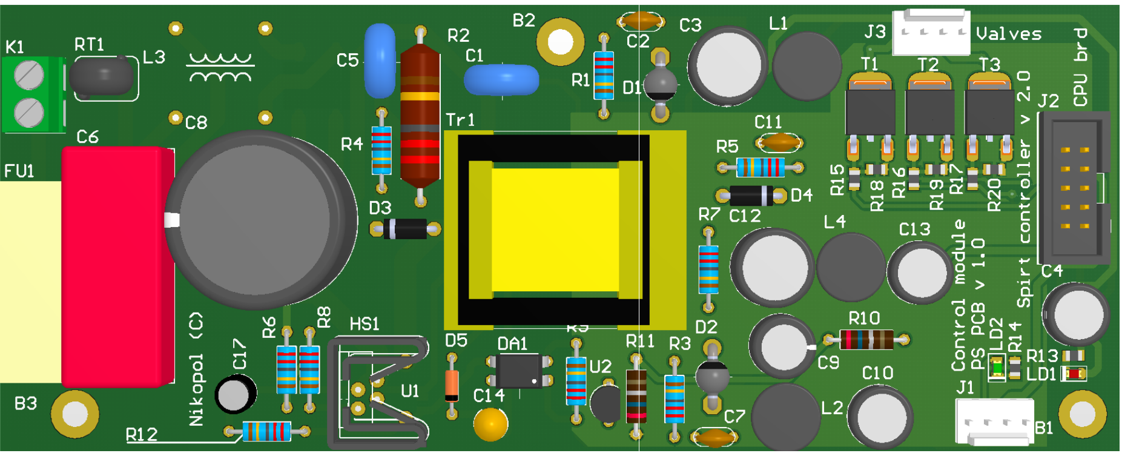
[picture p153: page 2]

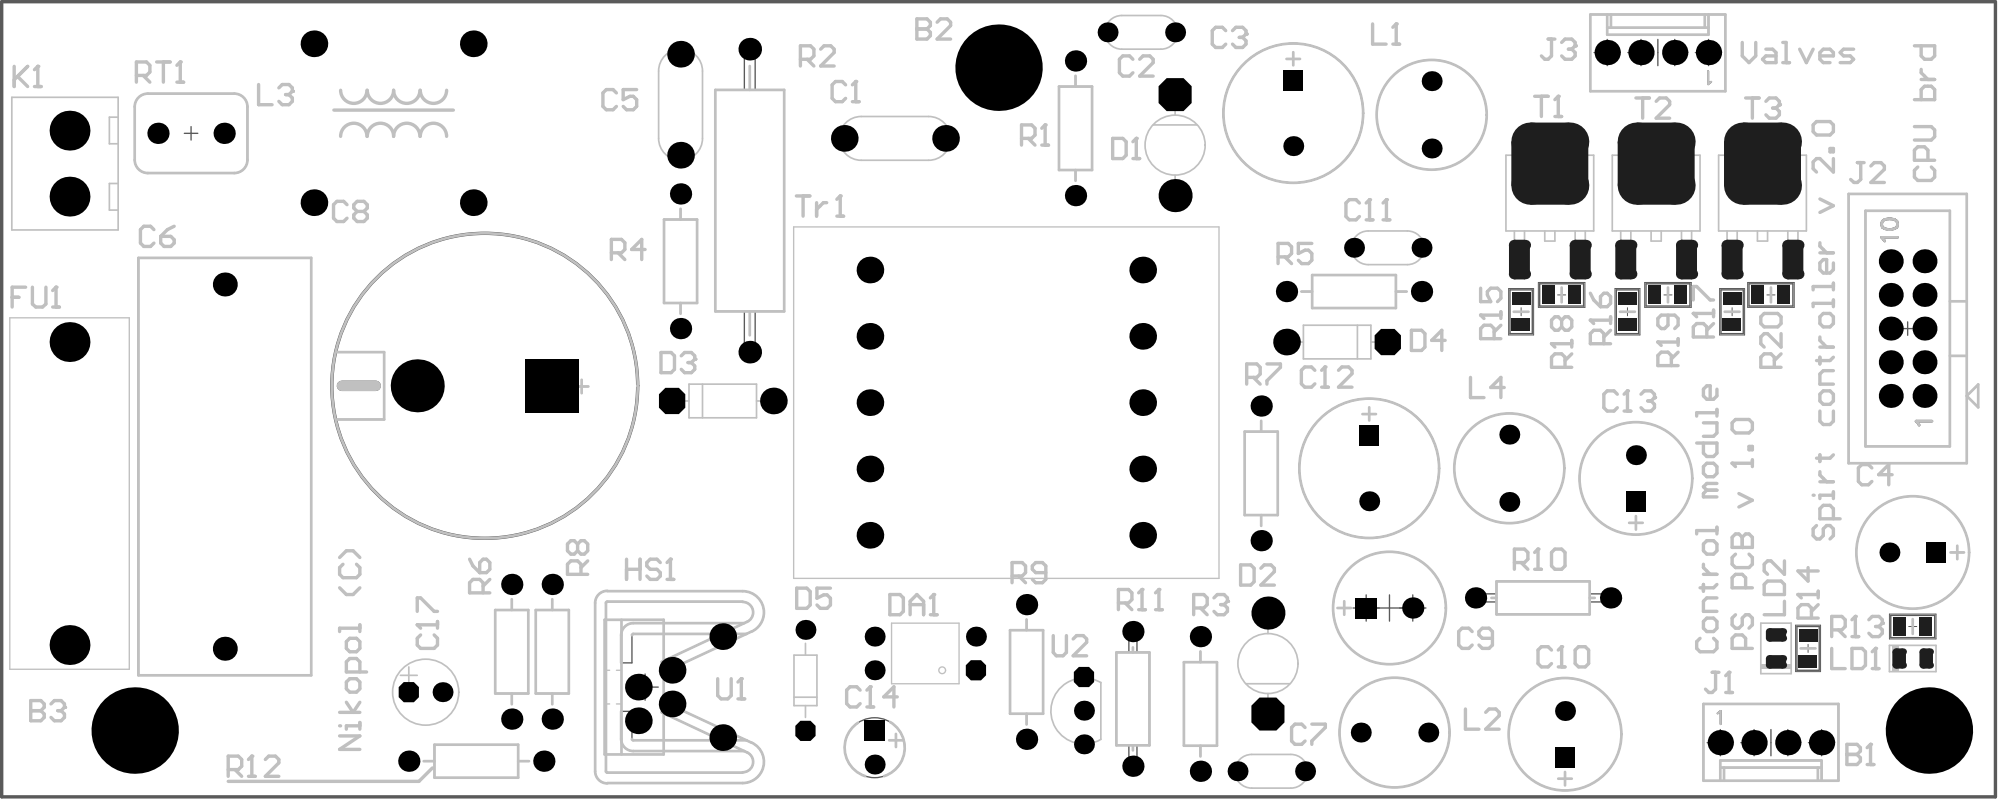
[picture p154: page 3]

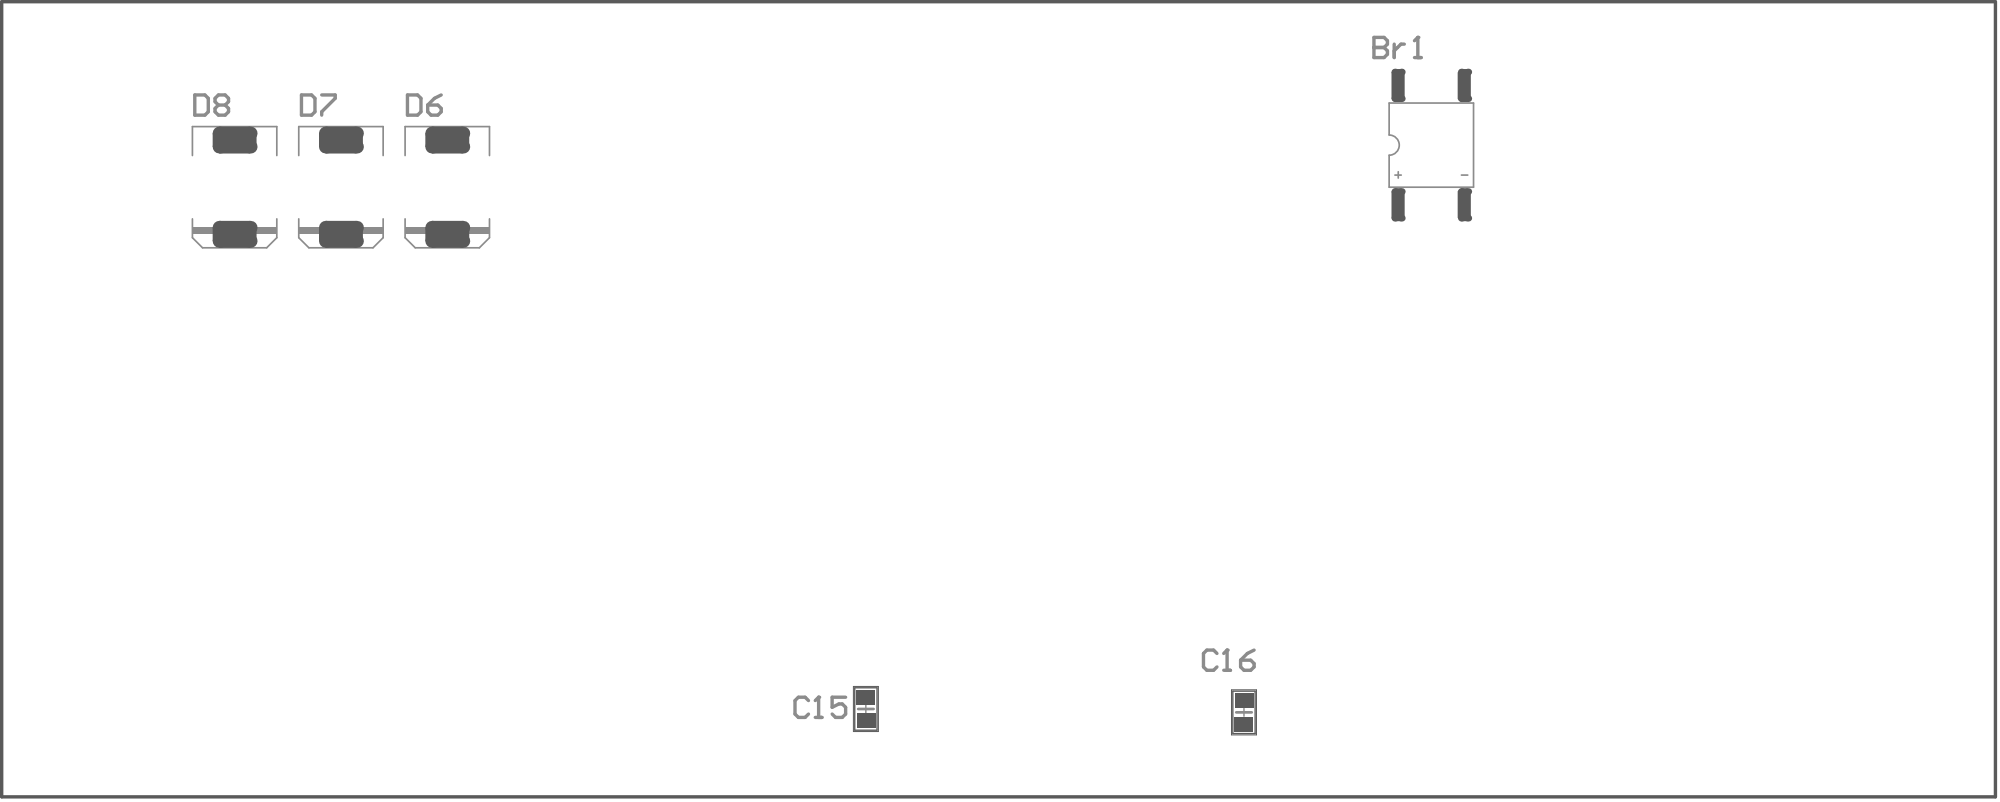
[picture p155: page 4]
