levichevdmitry/spirt_v2/power_module/hw/PowerModule/Project Outputs for ControlBoard/Power_CPU_board.PDF

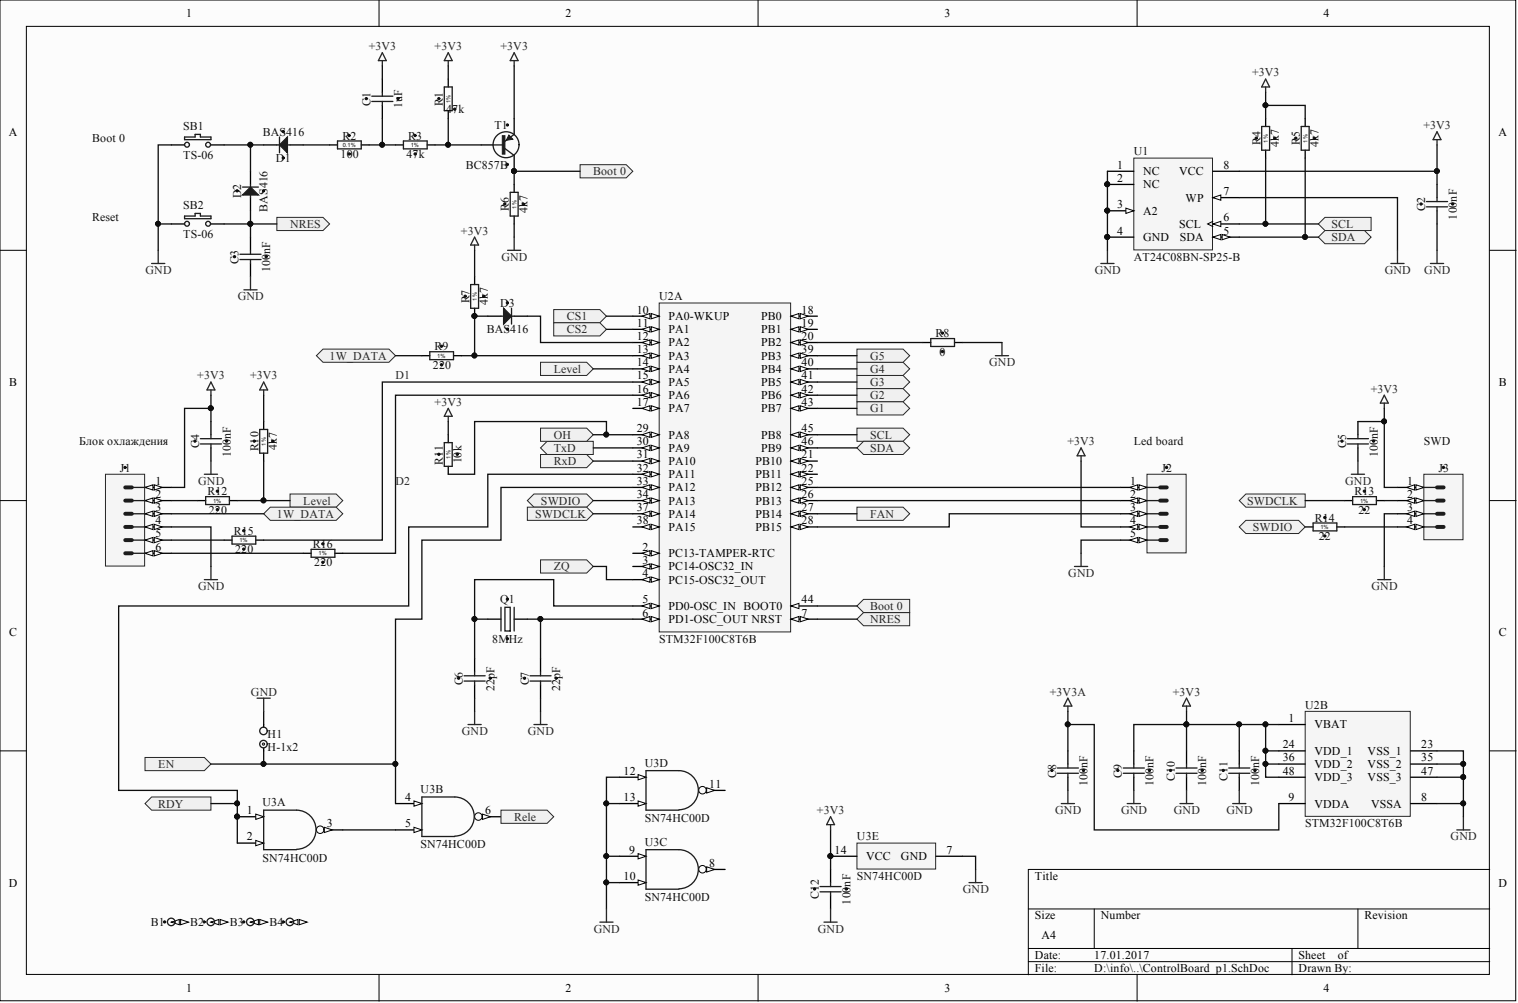
[picture p156: page 1]

PA9 30
PA10 31
PA11 32
PA12 33

SWDCLK | PA13 34

PC14-OSC32_IN 3

Q1 | PD0-OSC_IN 5

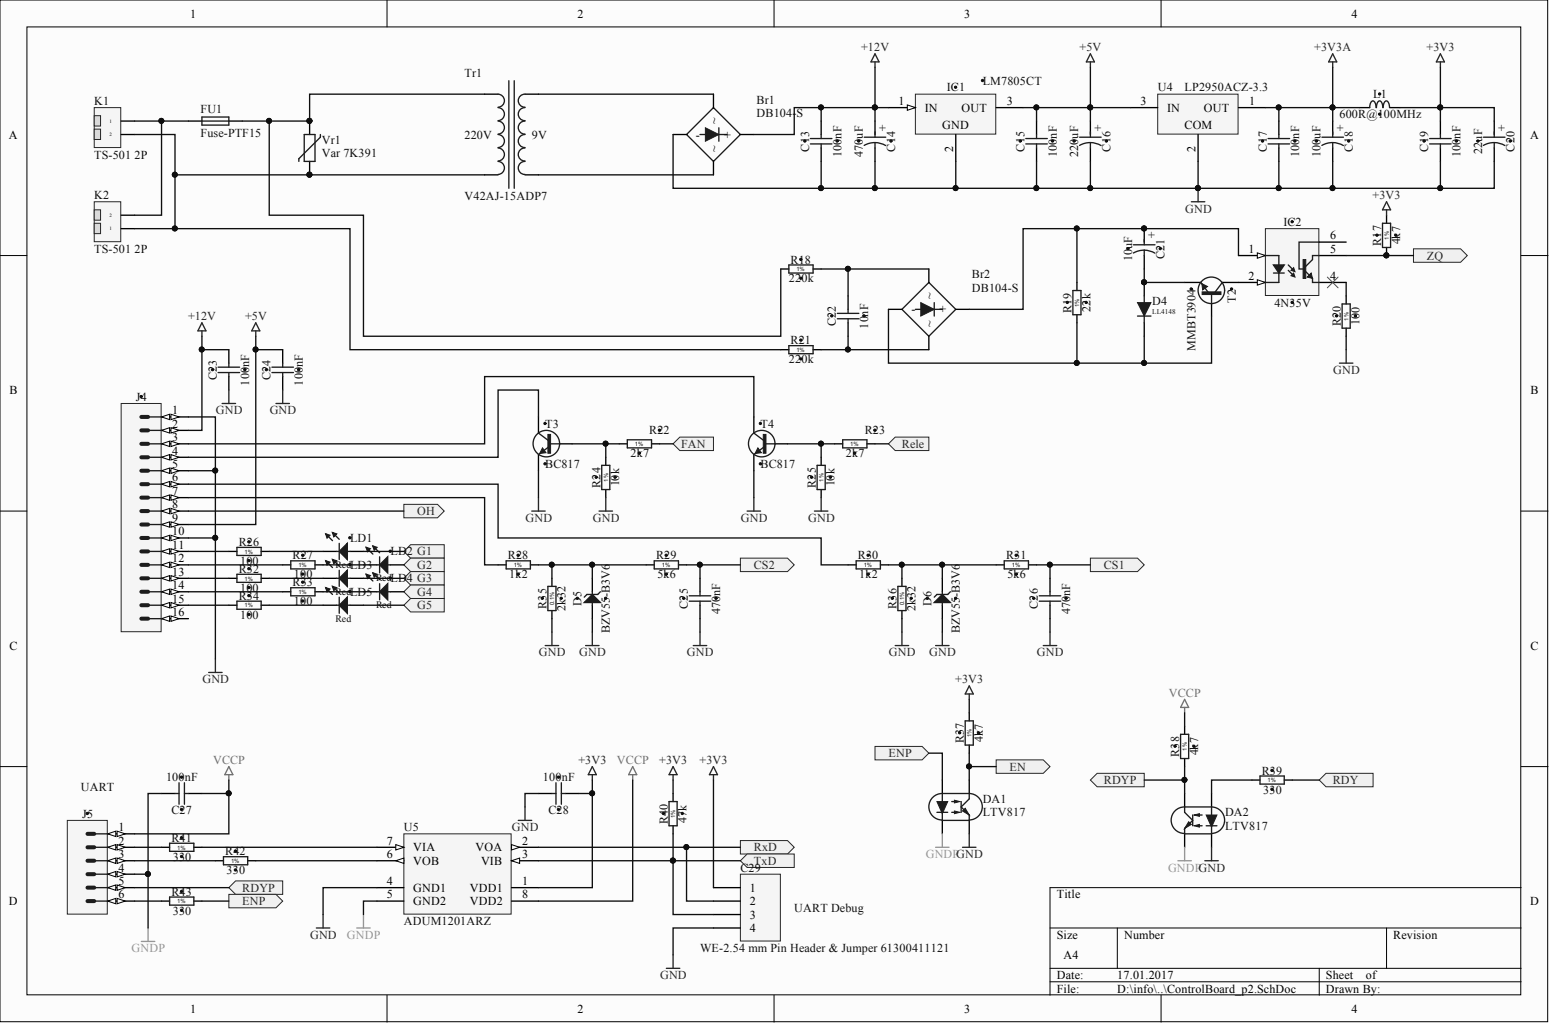
[picture p157: page 2]

4 | 1% | 1%
9 | LD1
10

14 | R33
15
16

WE-2.54 mm Pin Header & Jumper 61300411121

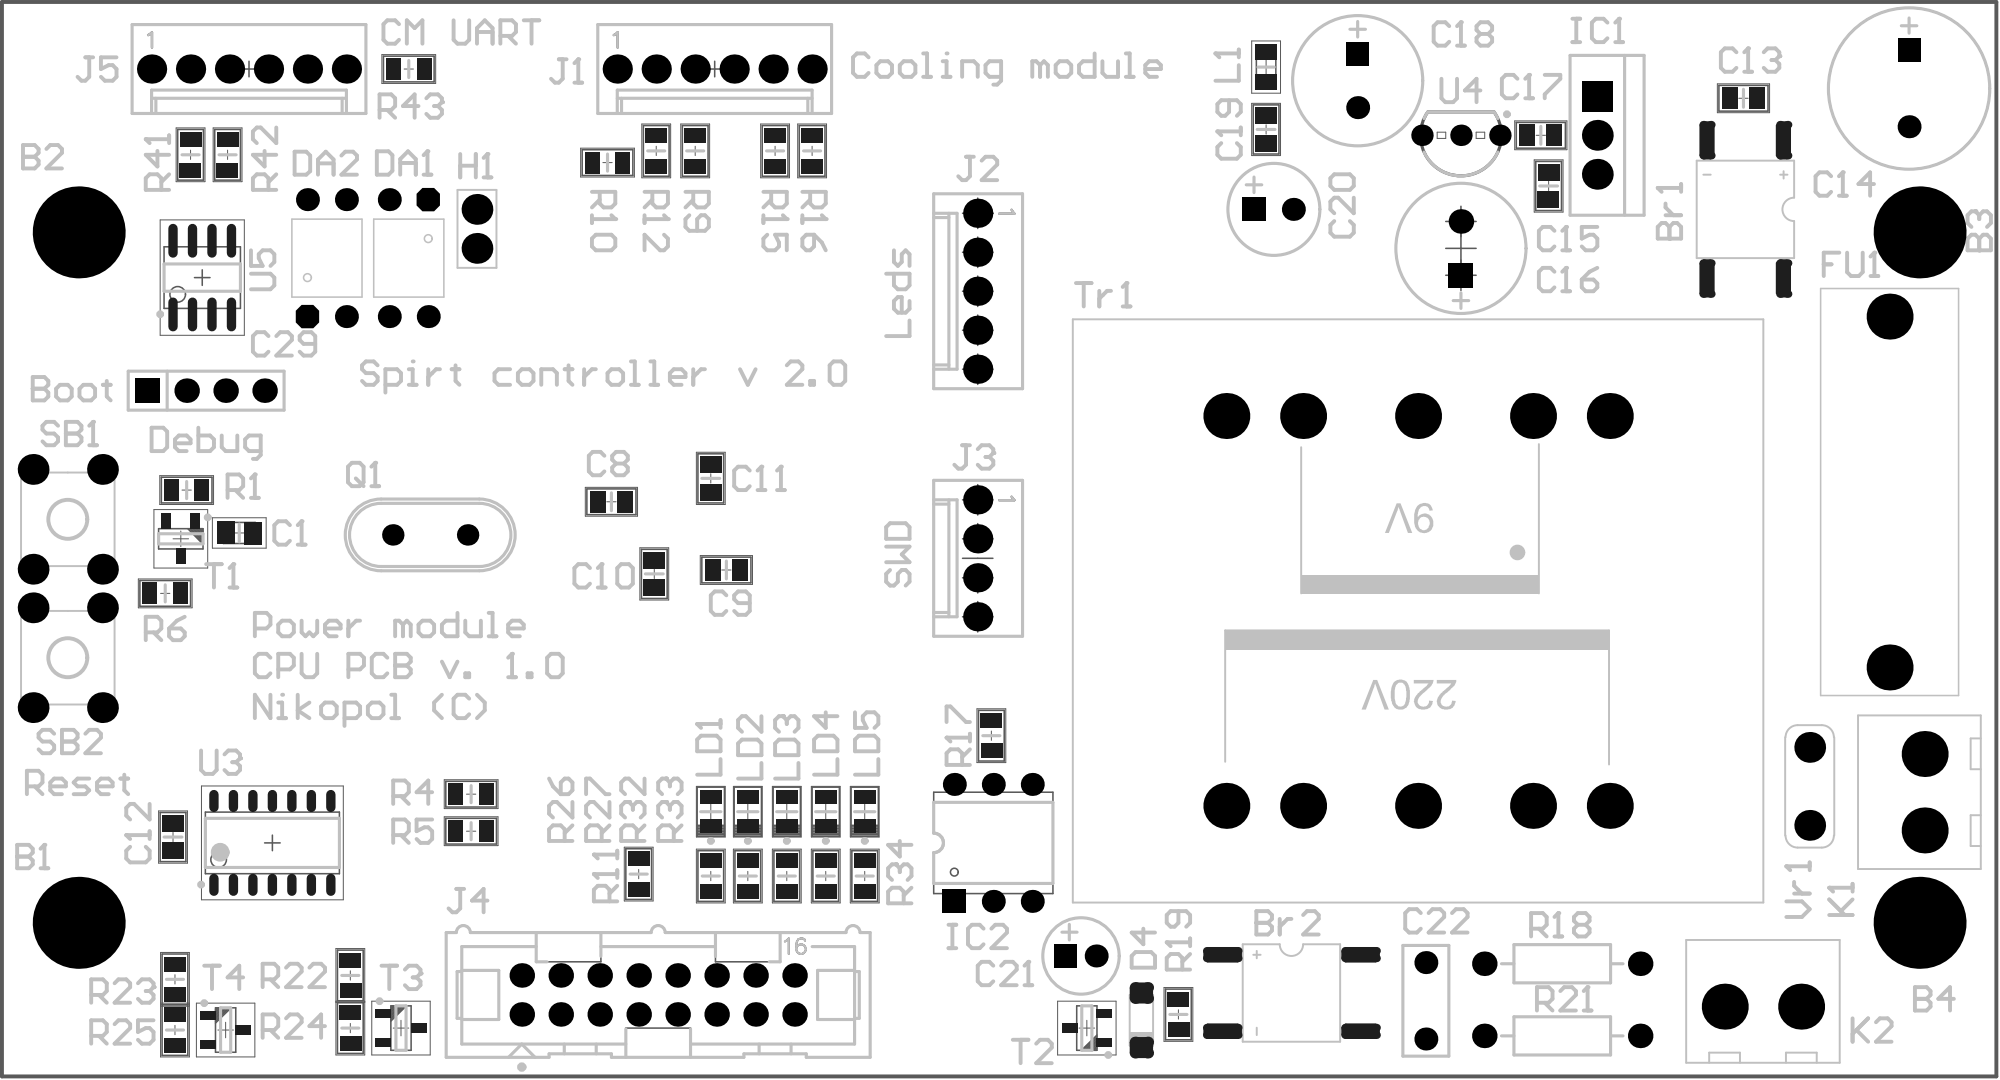
[picture p158: page 3]

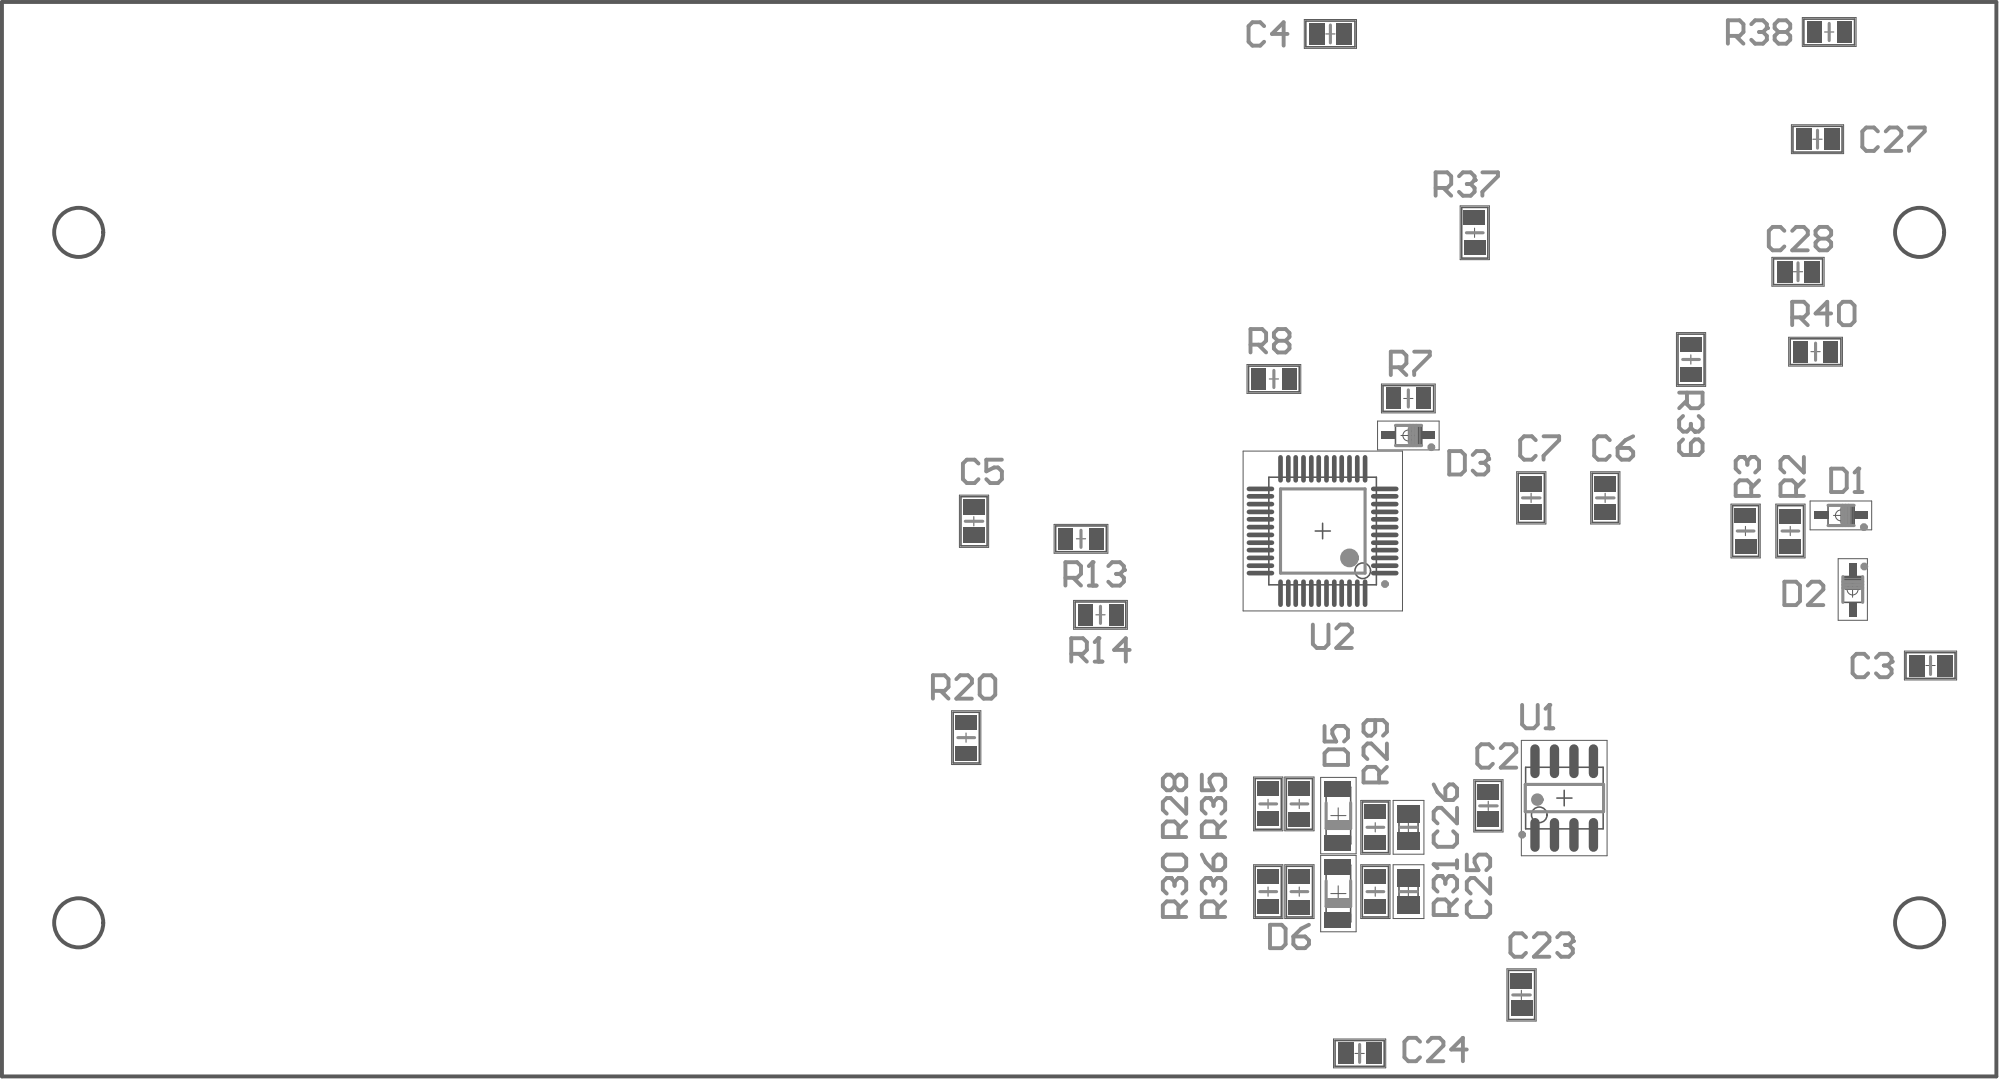
[picture p159: page 4]

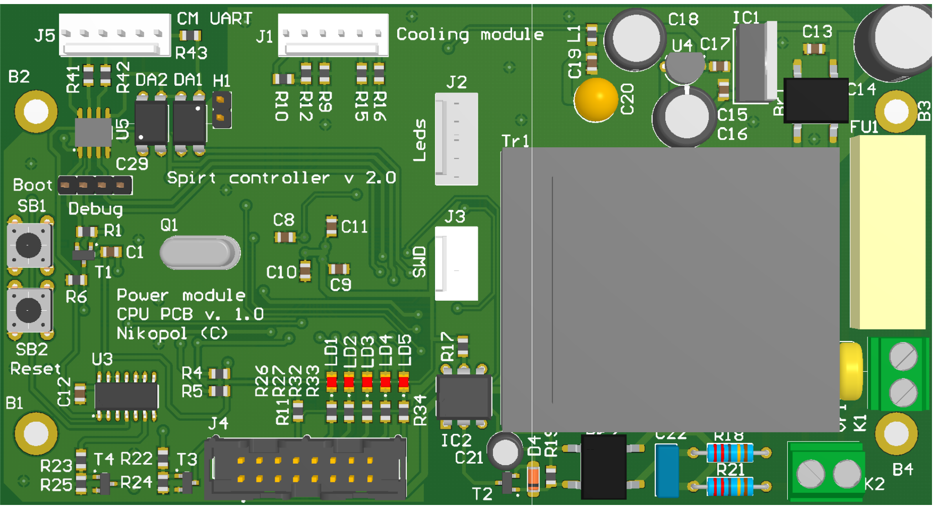
[picture p160: page 5]
