levichevdmitry/spirt_v2/power_module/hw/PowerModule/Project Outputs for LedBoard/PM_led_board.PDF

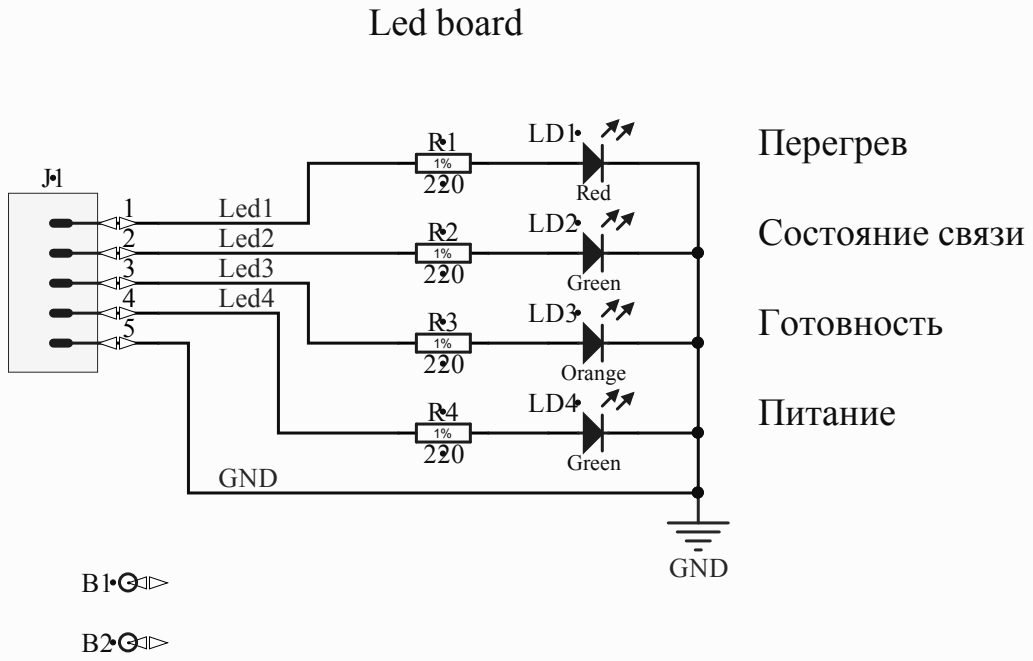
[picture p161: page 1]

GND | 1% | Green

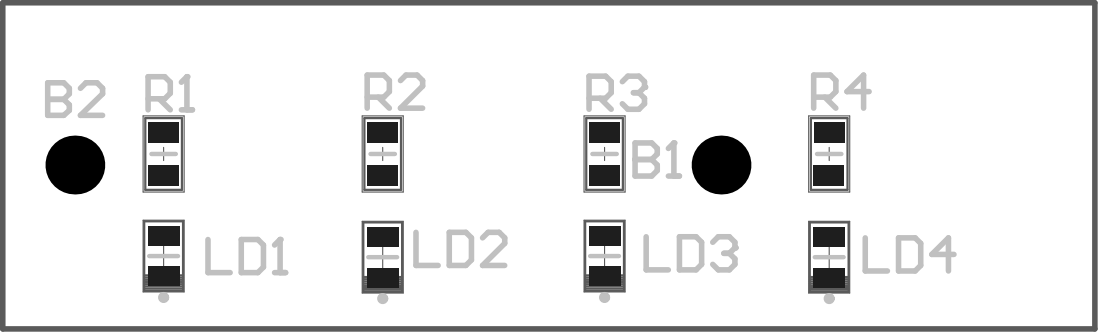
[picture p162: page 2]

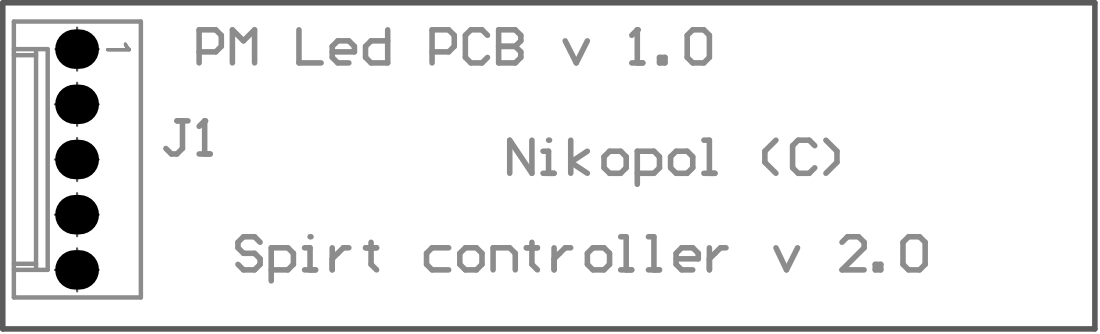
[picture p163: page 3]

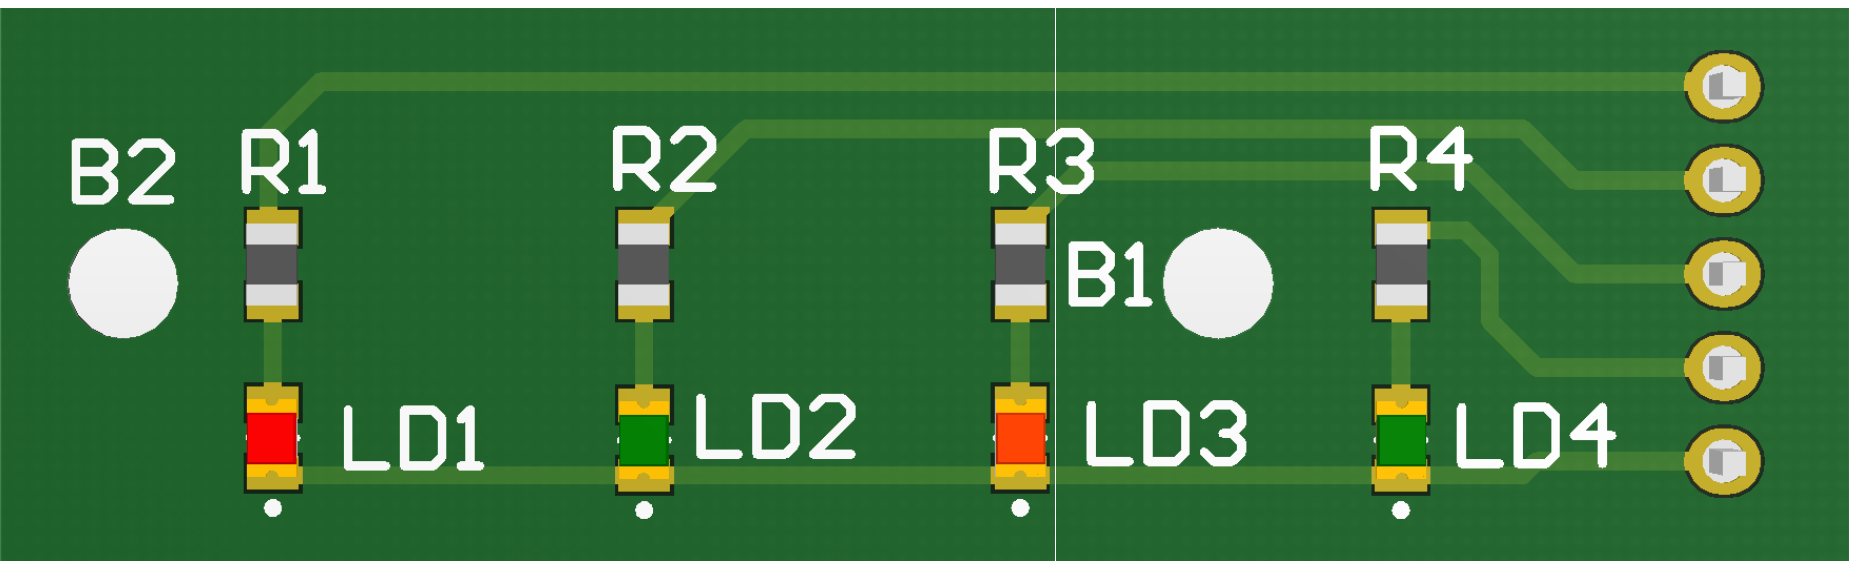
[picture p164: page 4]
