levichevdmitry/spirt_v2/general_hw/Connection_diagram.pdf

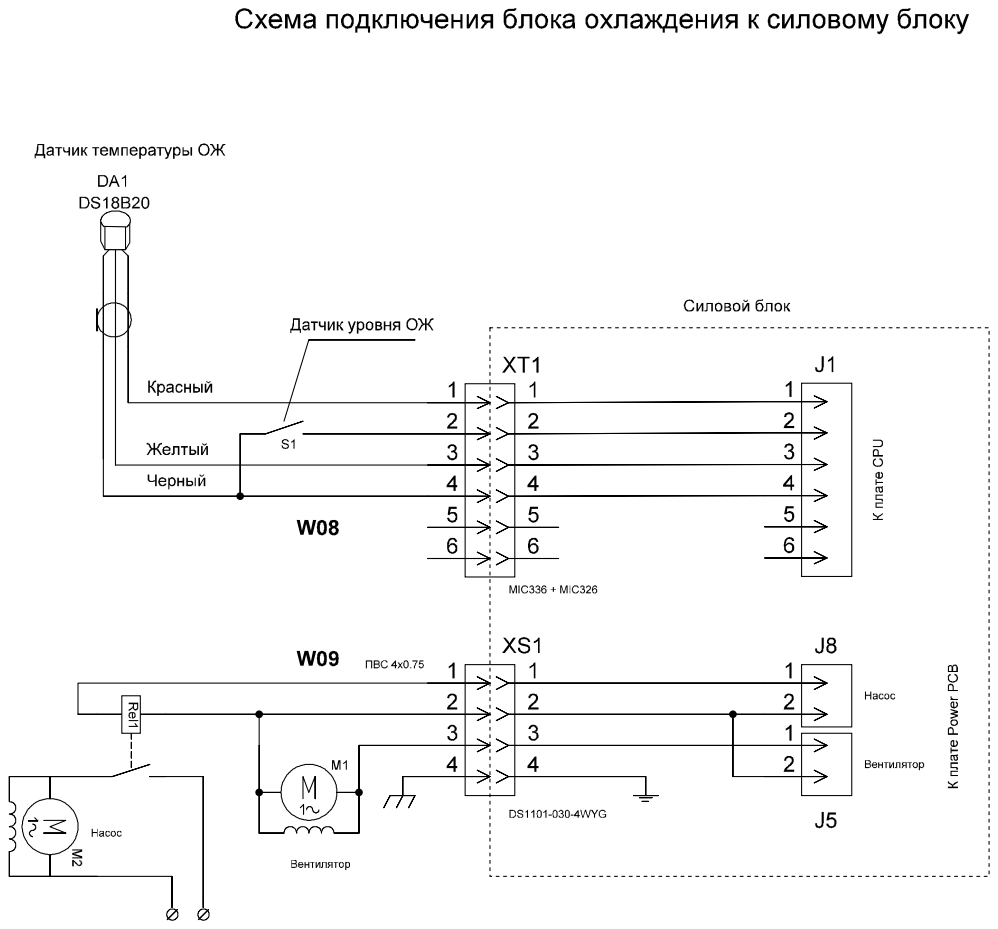
[picture p165: page 1]

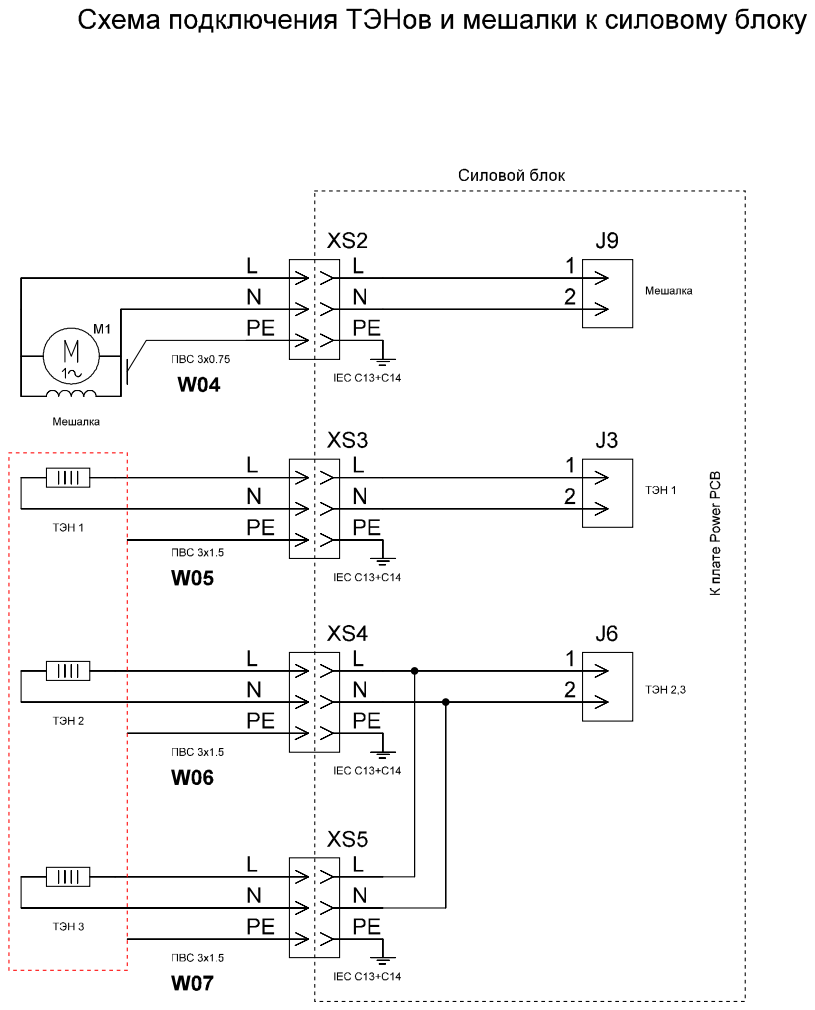
[picture p166: page 2]

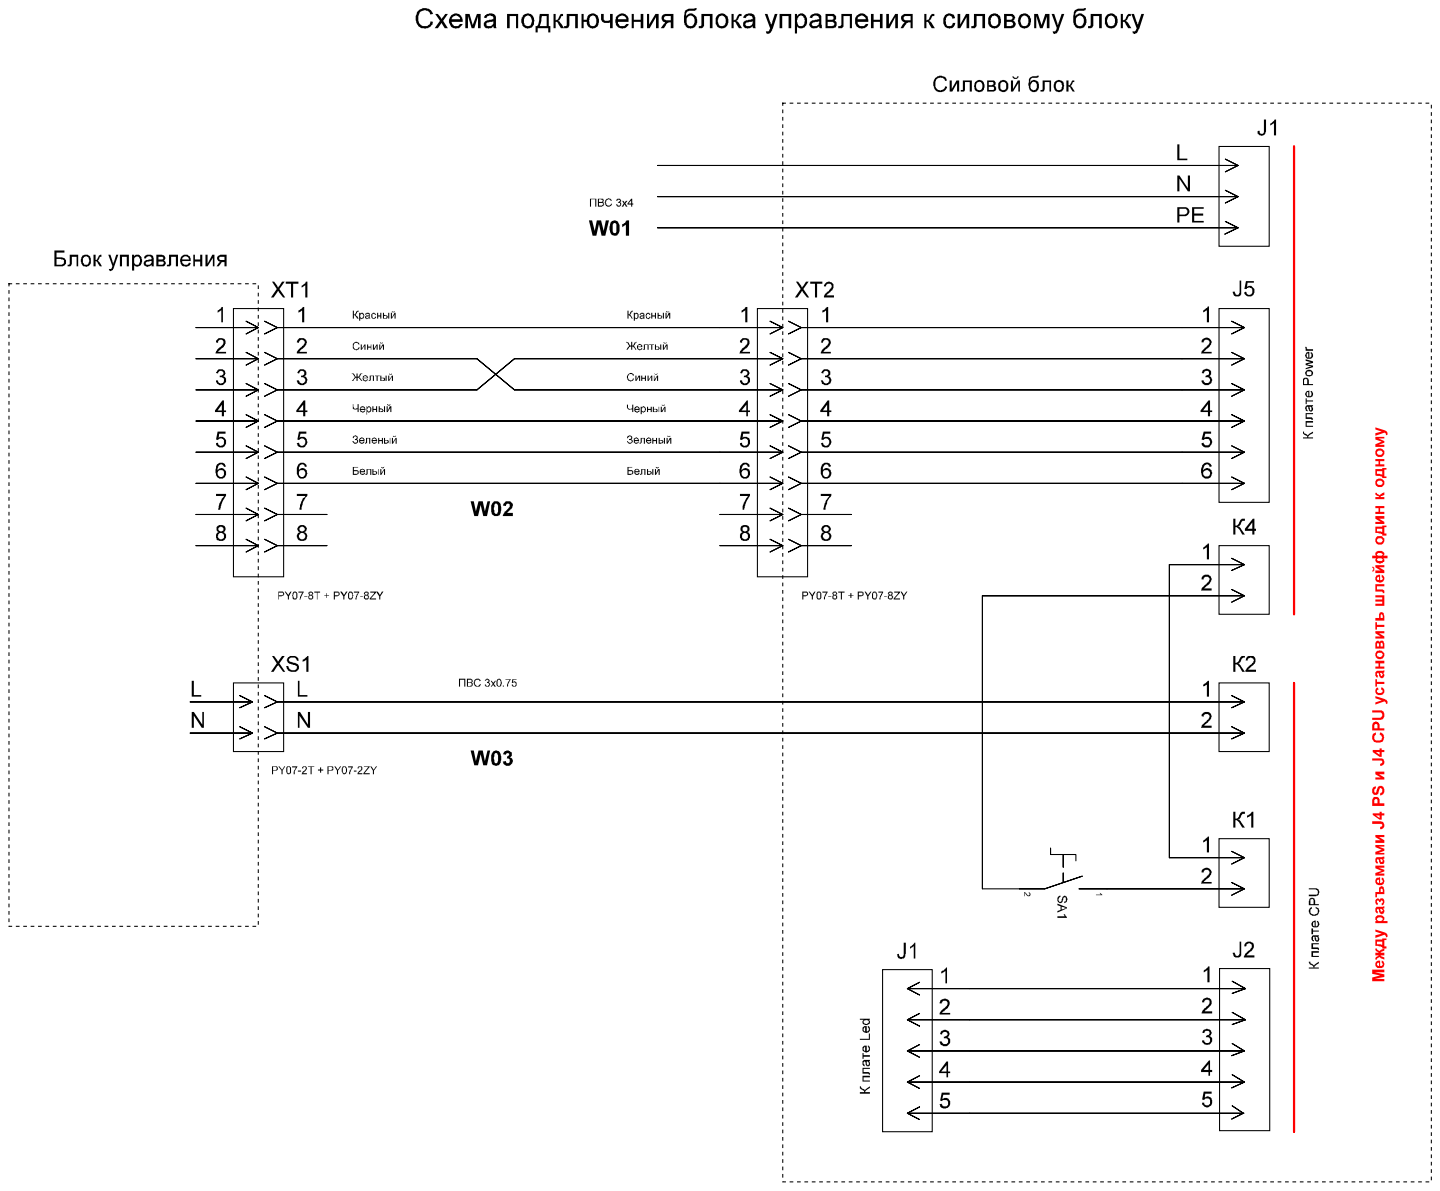
[picture p167: page 3]

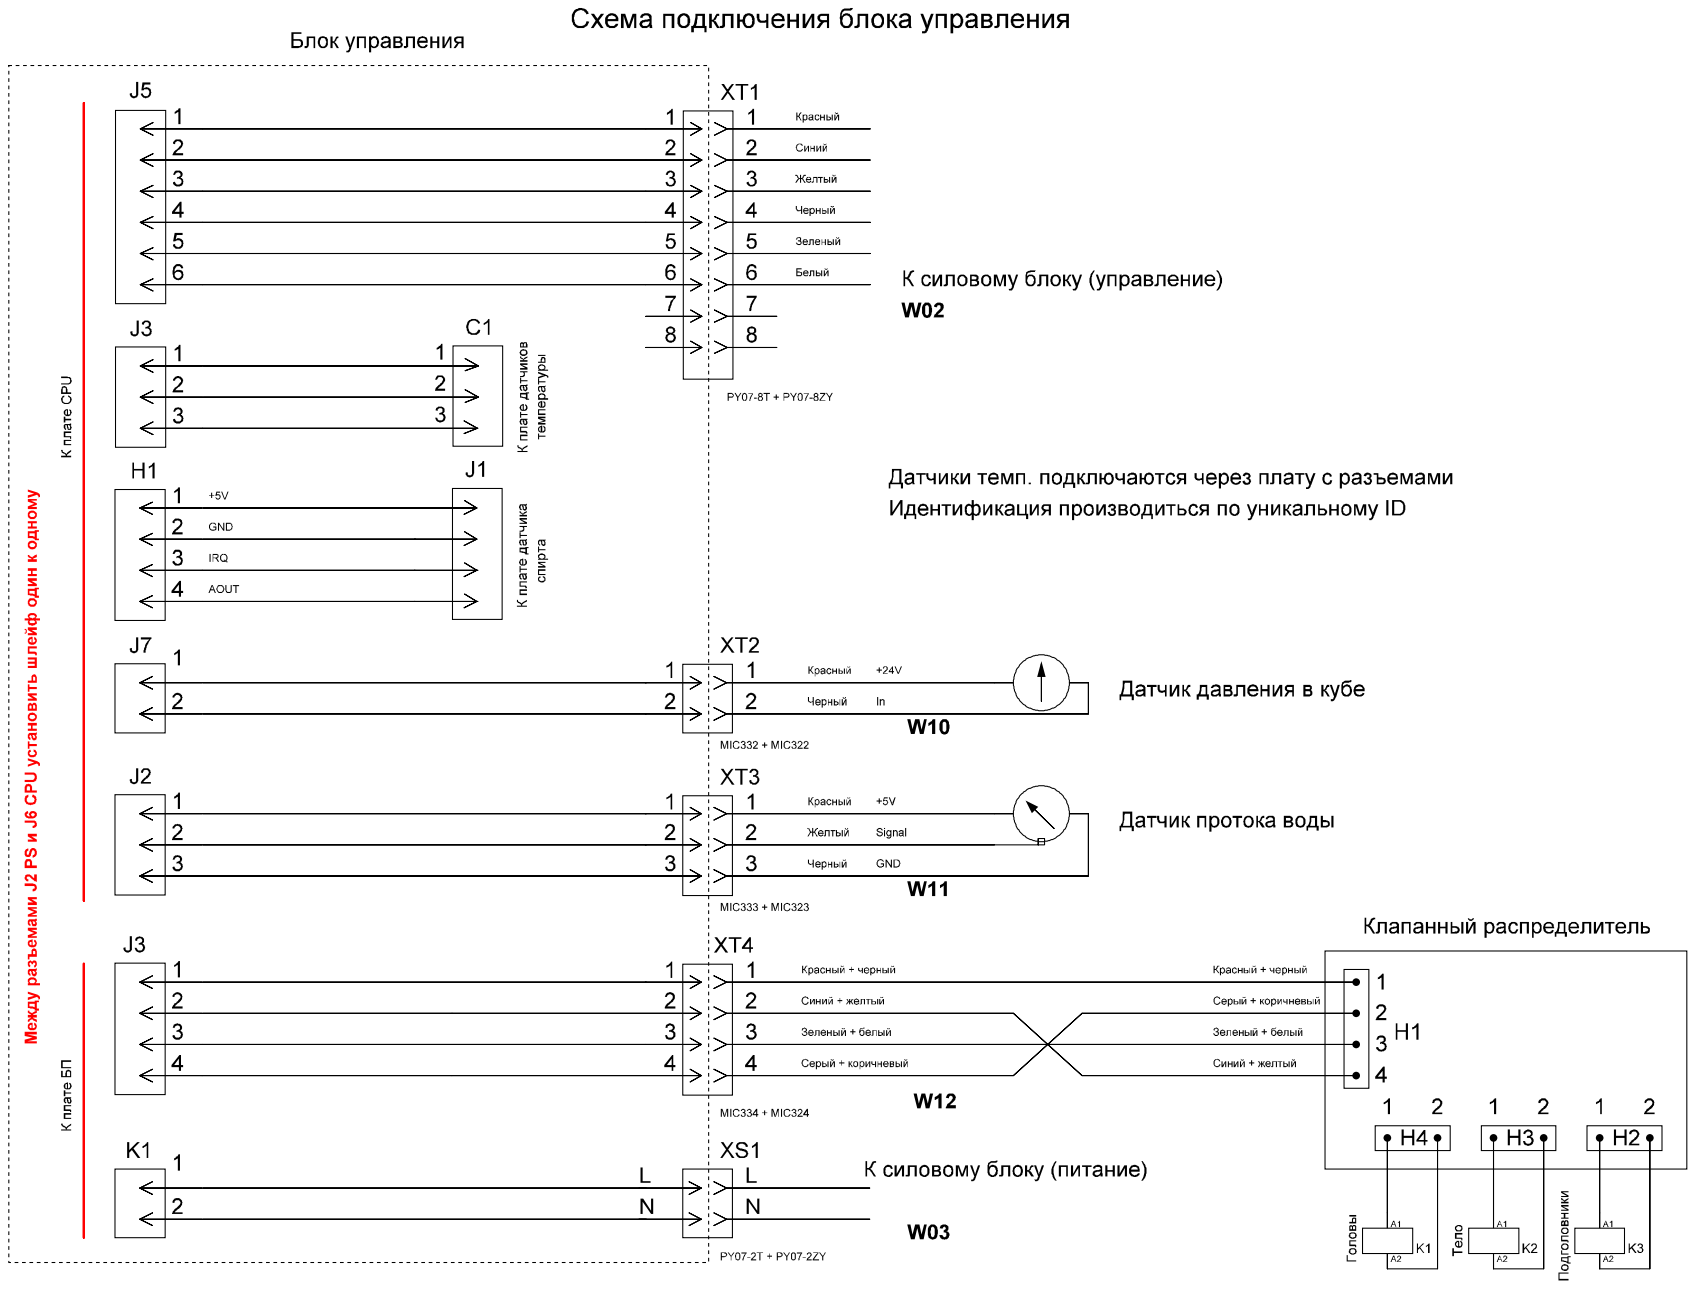
[picture p168: page 4]

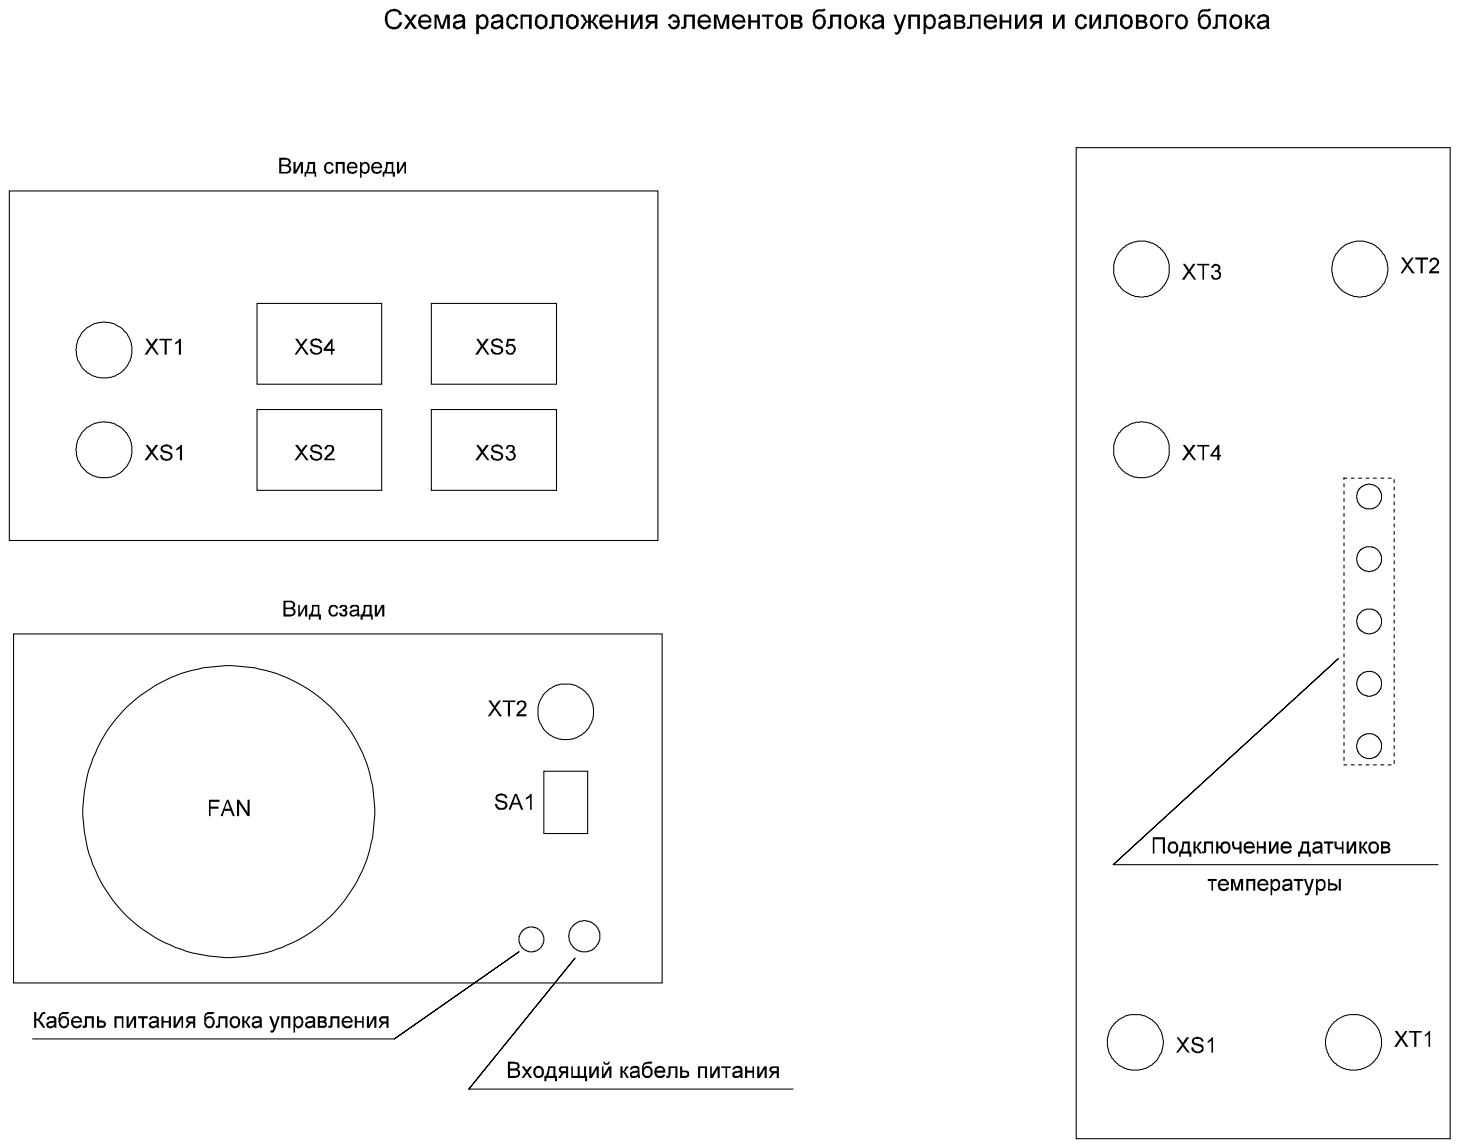
[picture p169: page 5]
