levichevdmitry/spirt_v2/general_hw/Connection_diagram_rev_B.pdf

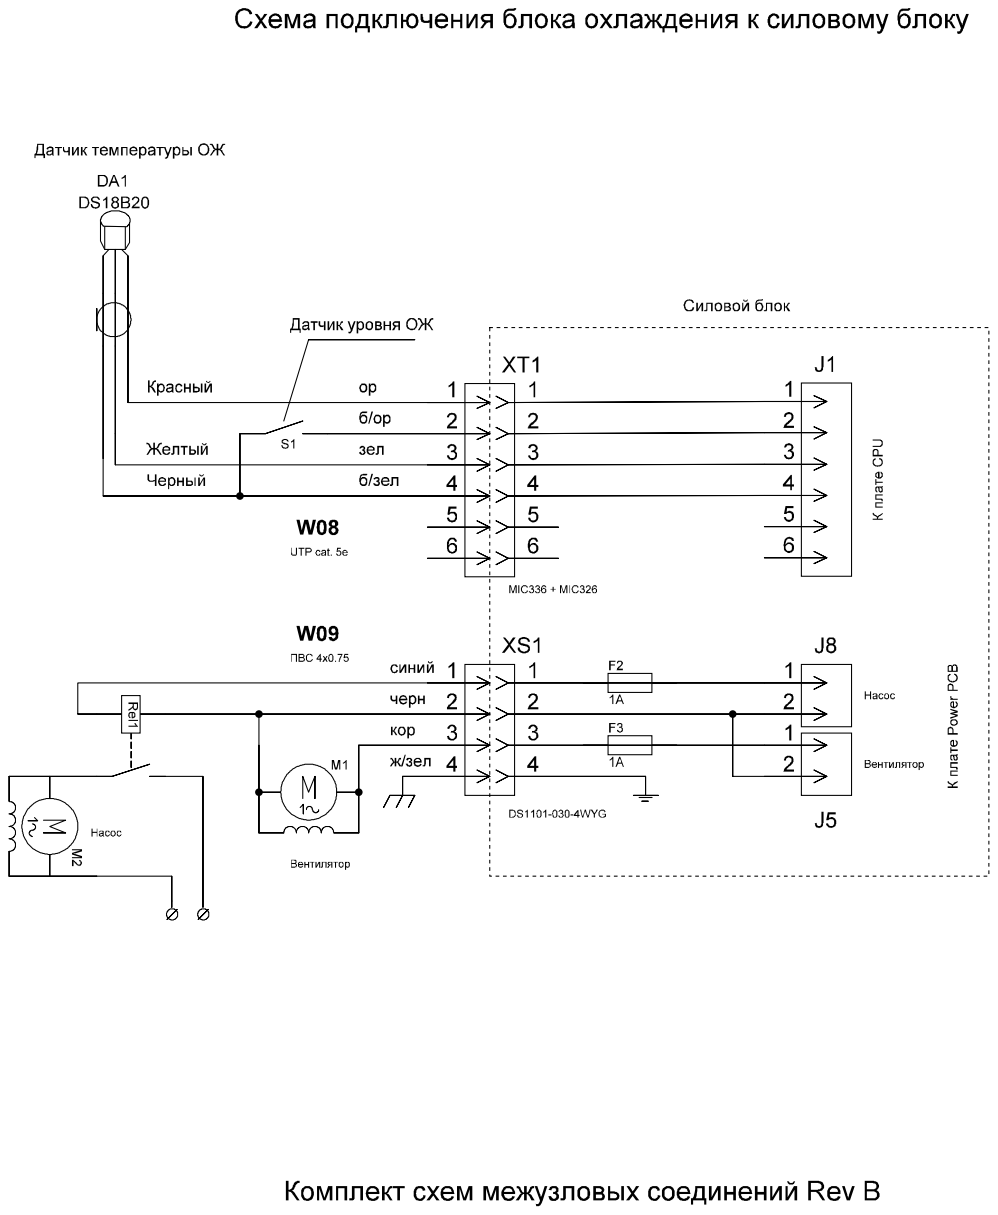
[picture p170: page 1]

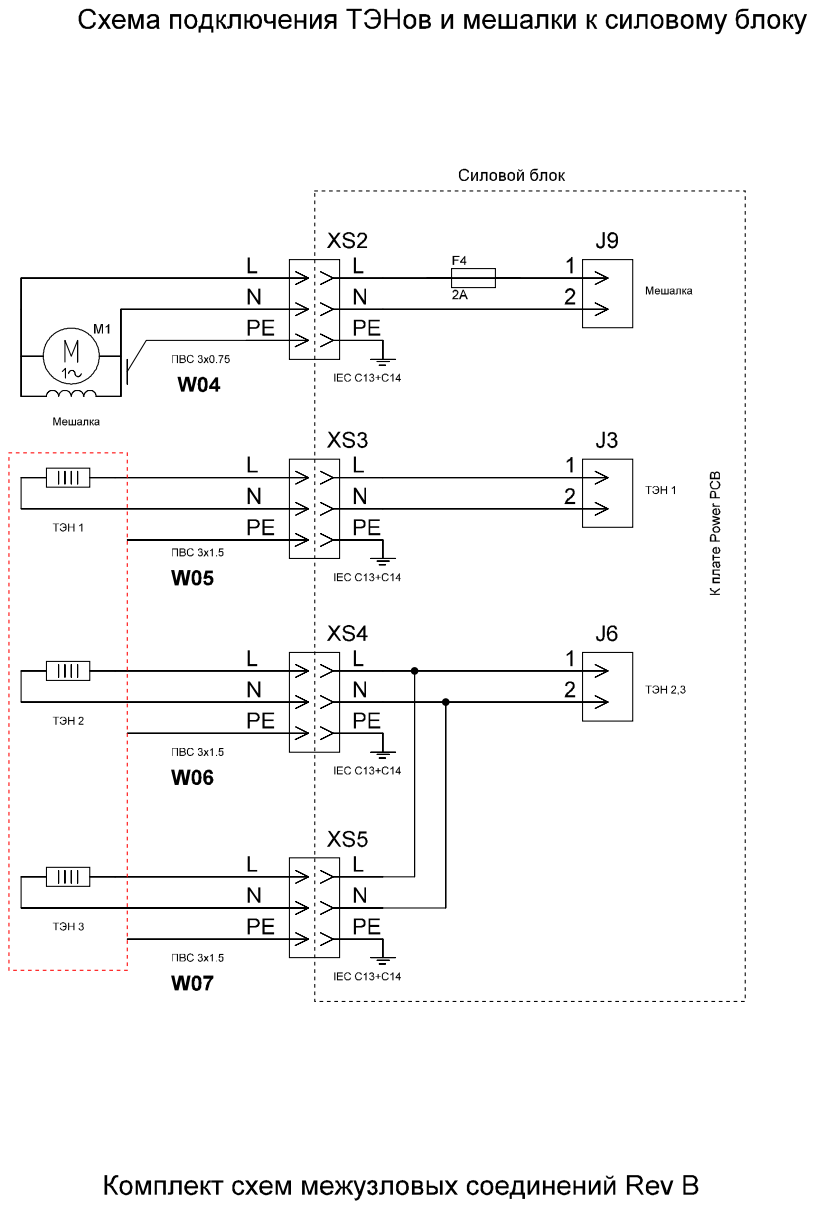
[picture p171: page 2]

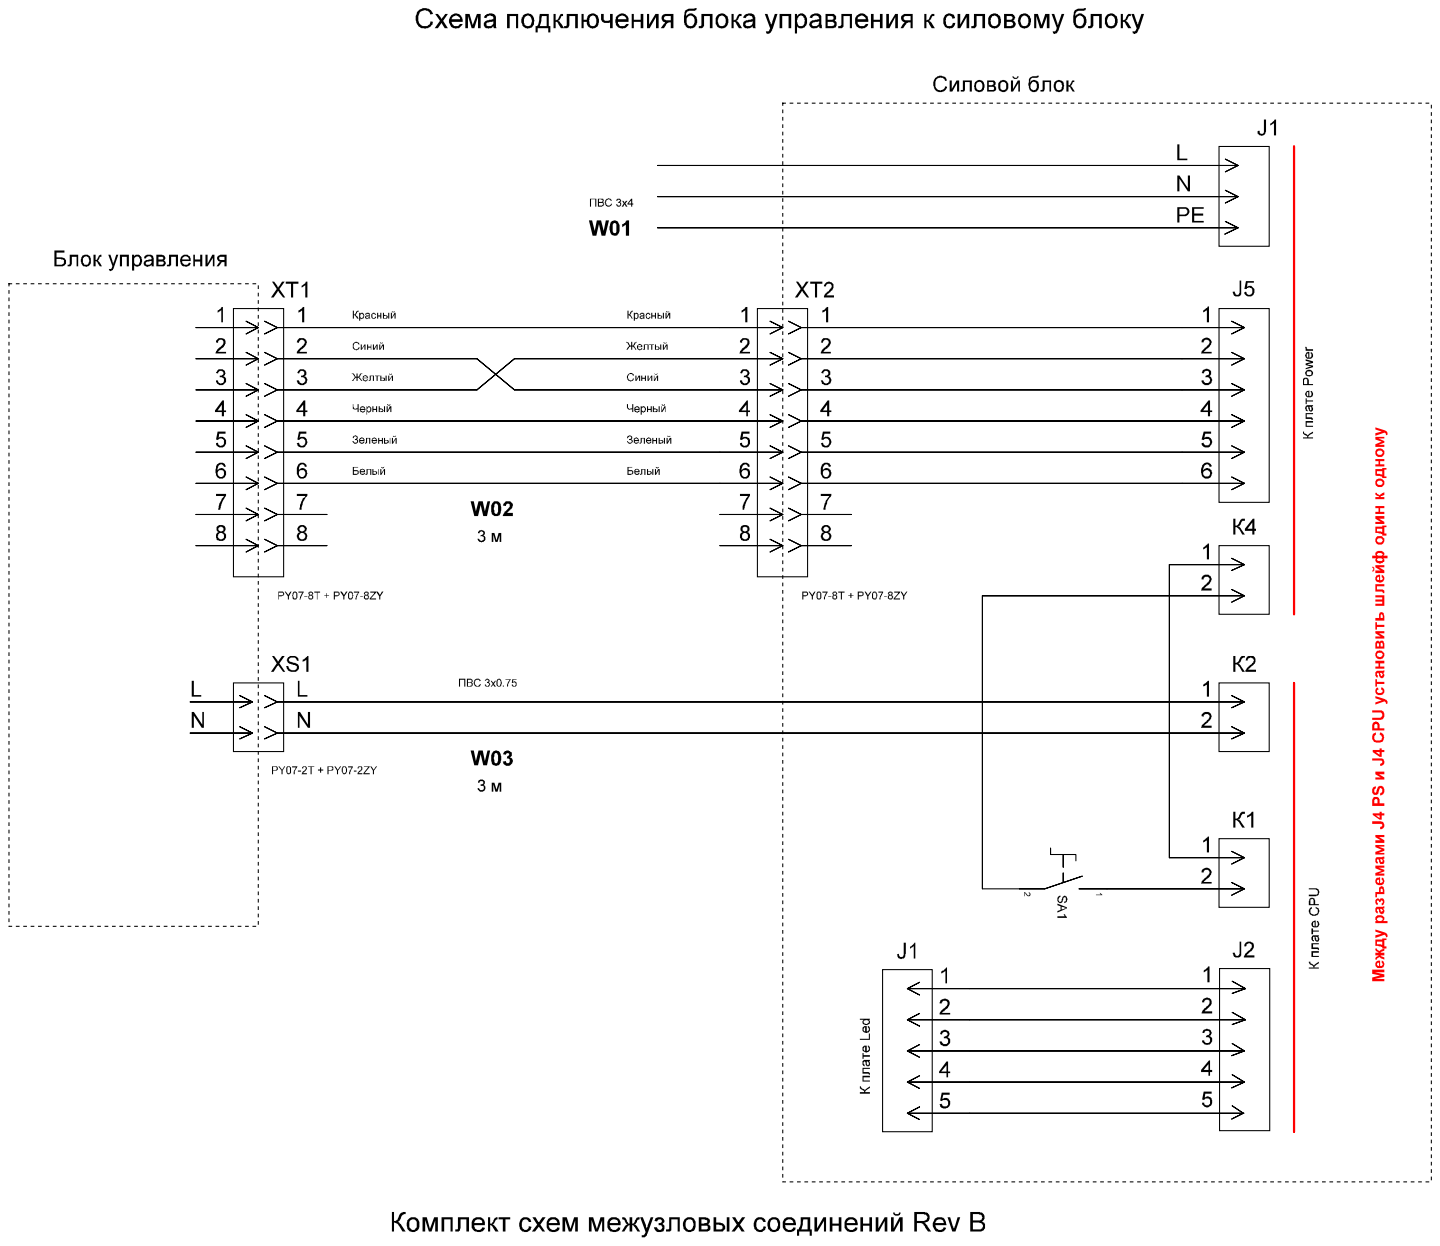
[picture p172: page 3]

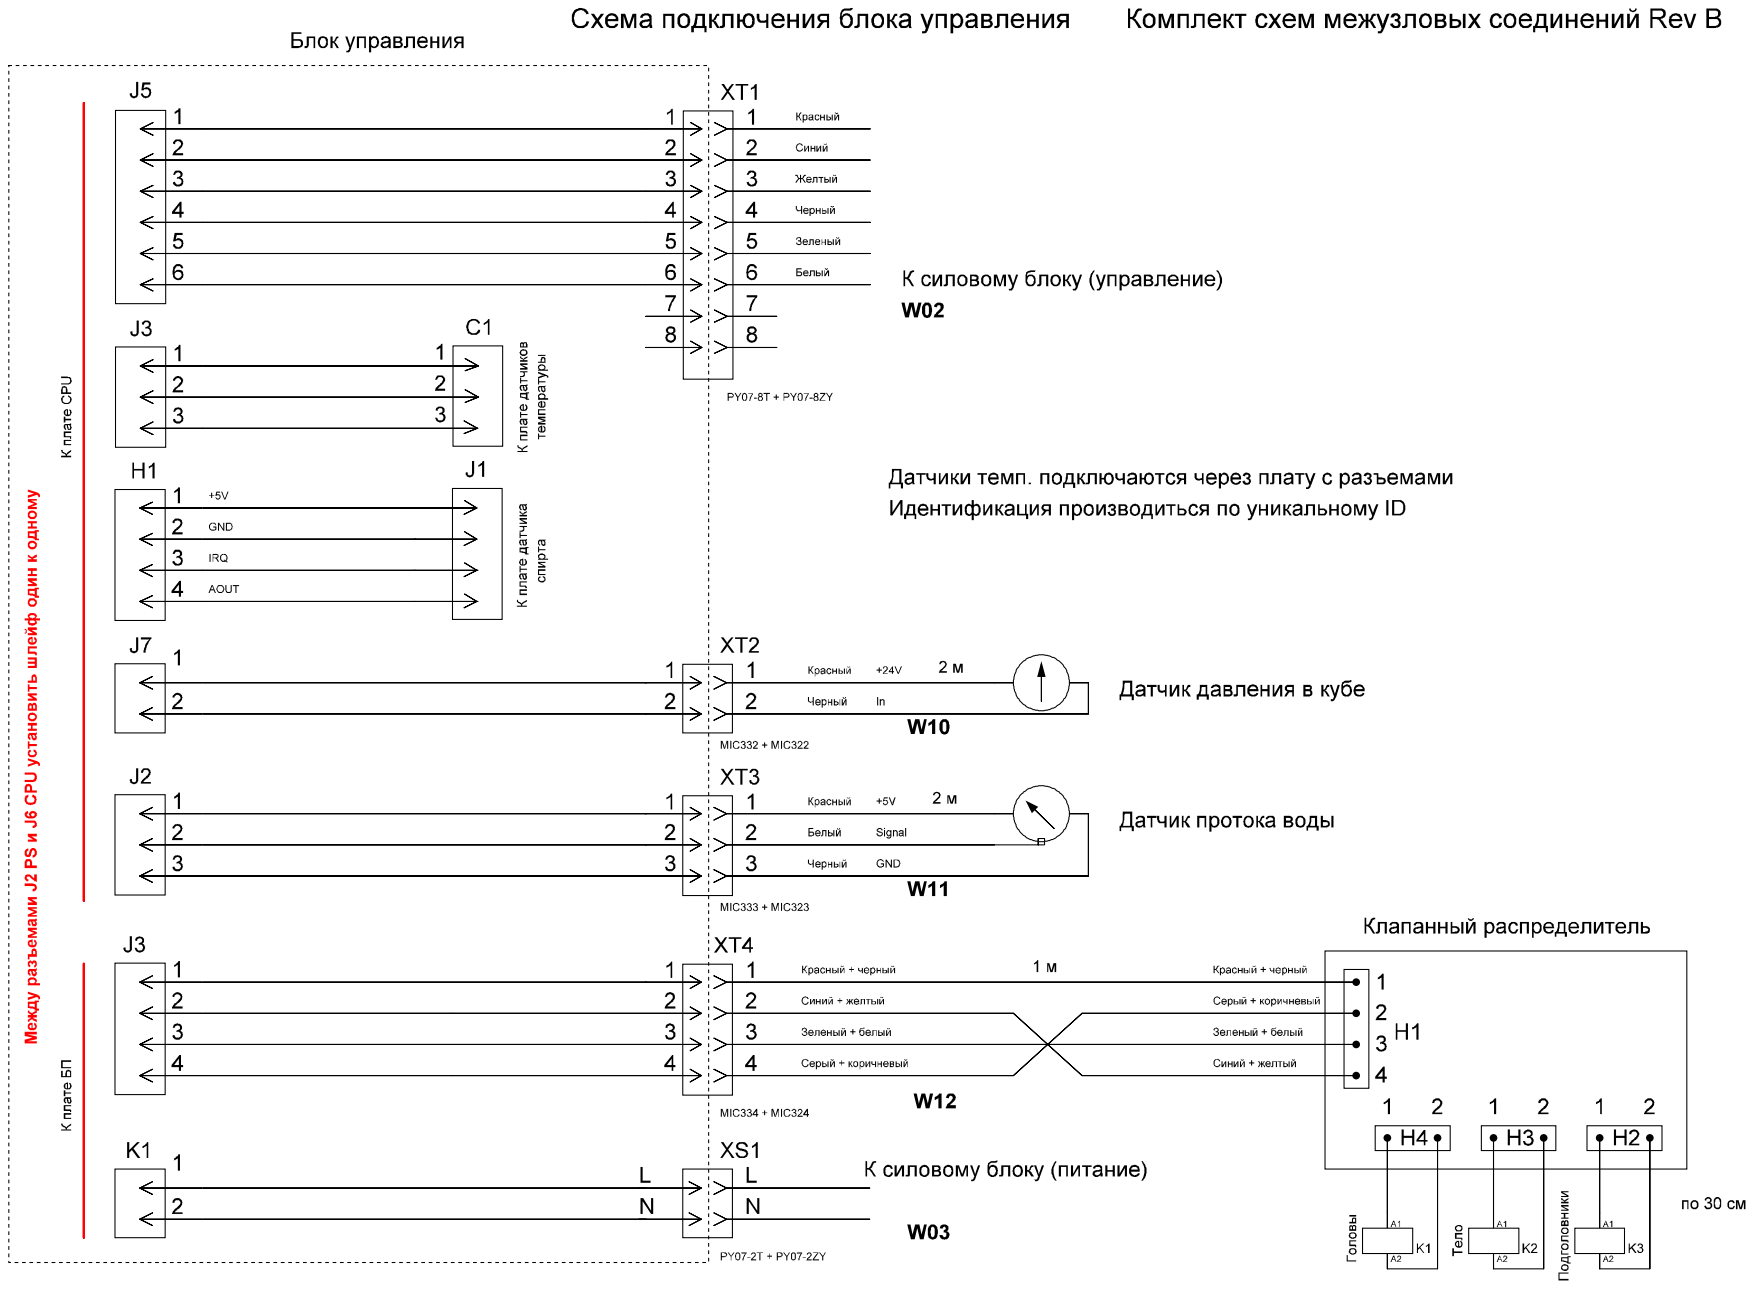
[picture p173: page 4]

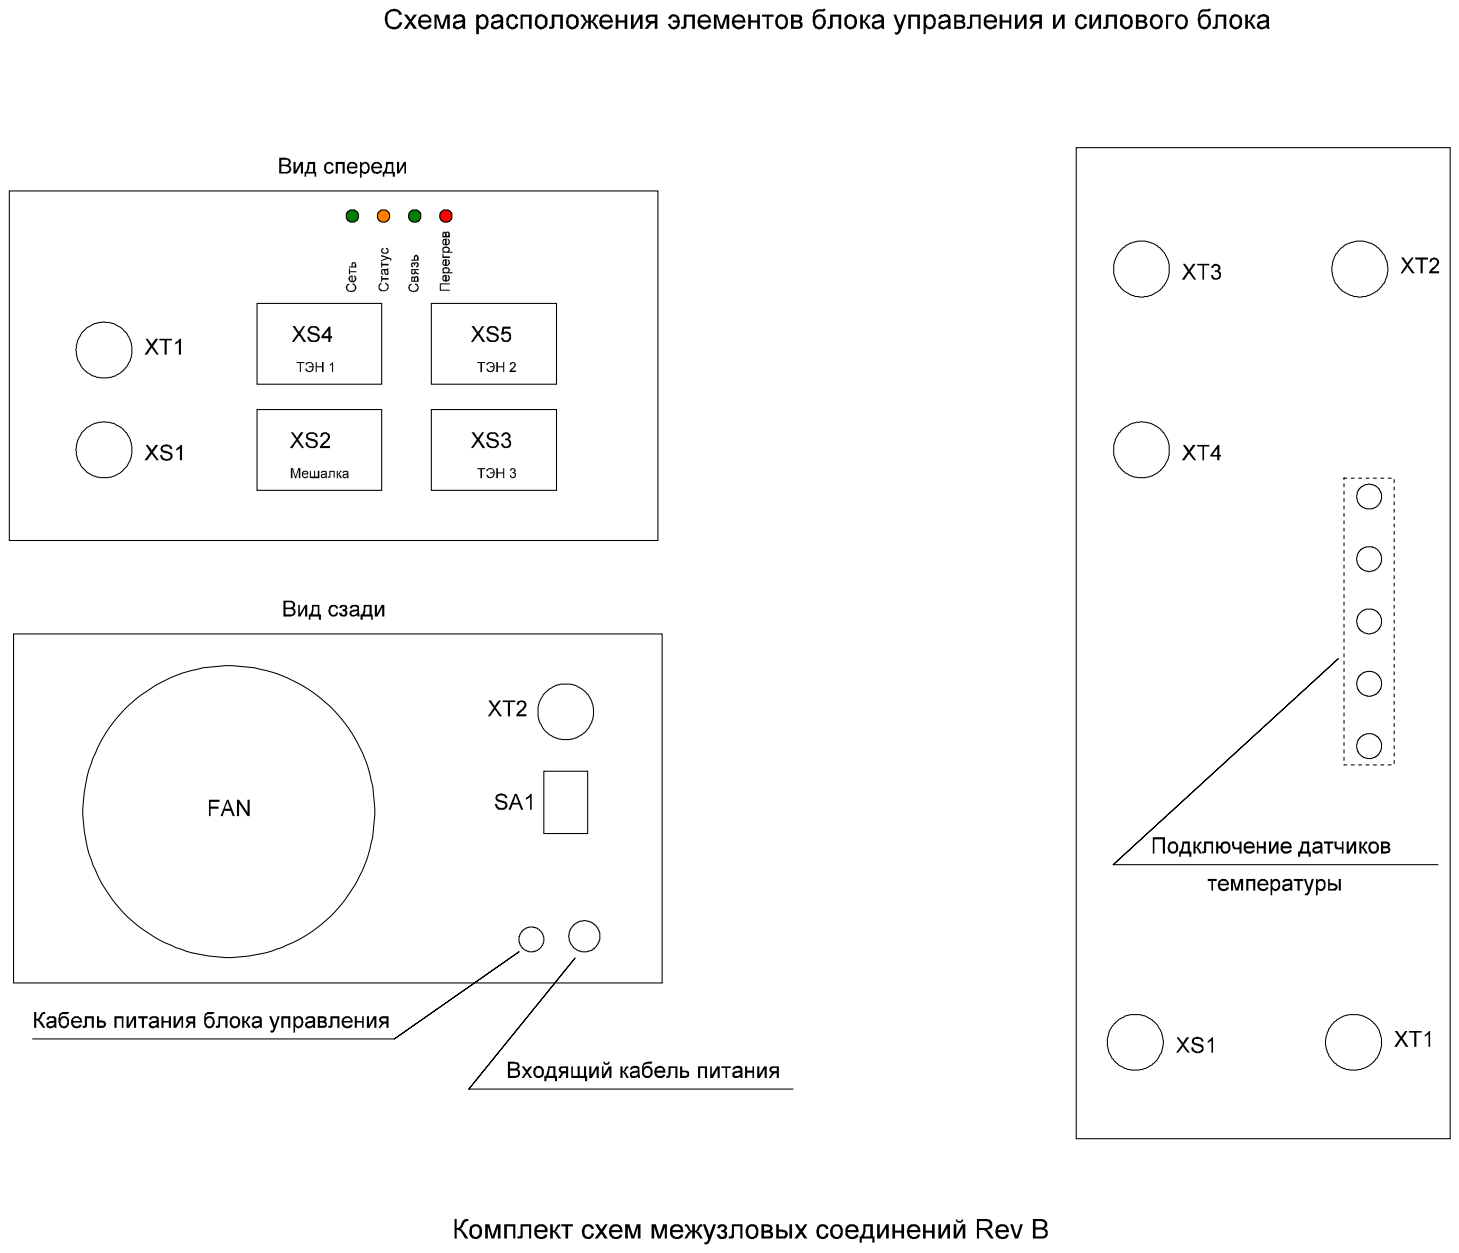
[picture p174: page 5]
