levichevdmitry/spirt_v2/control_module/hw/ControlModule/Project Outputs for CPU_Board/Controler_CPU_board.PDF

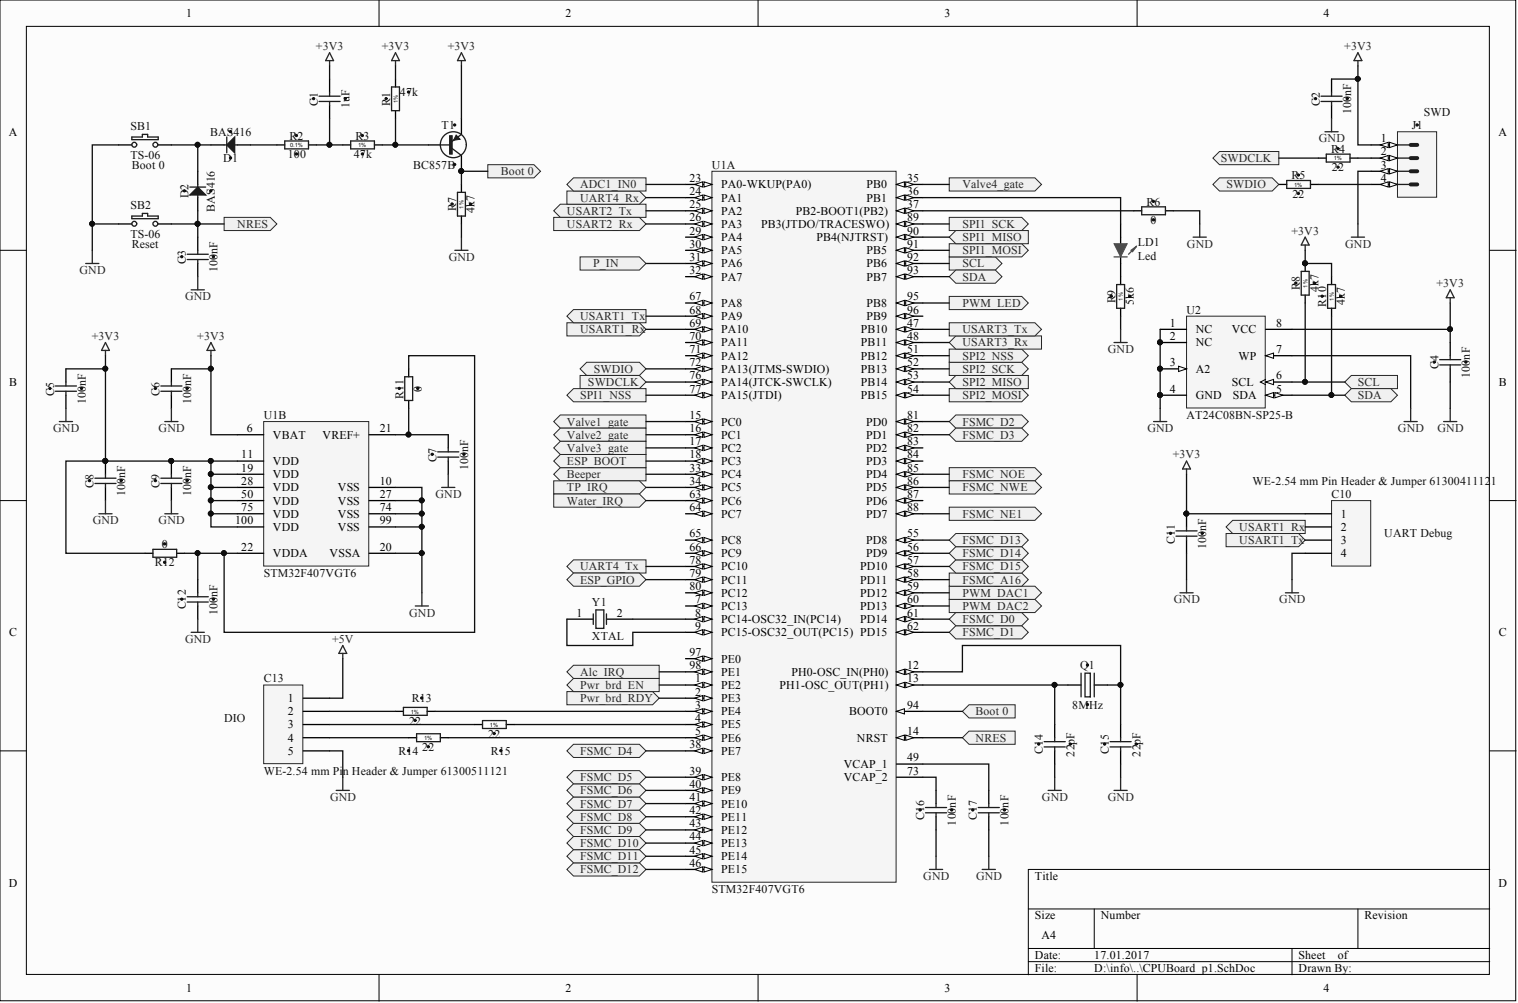
[picture p175: page 1]

3 7
8 9

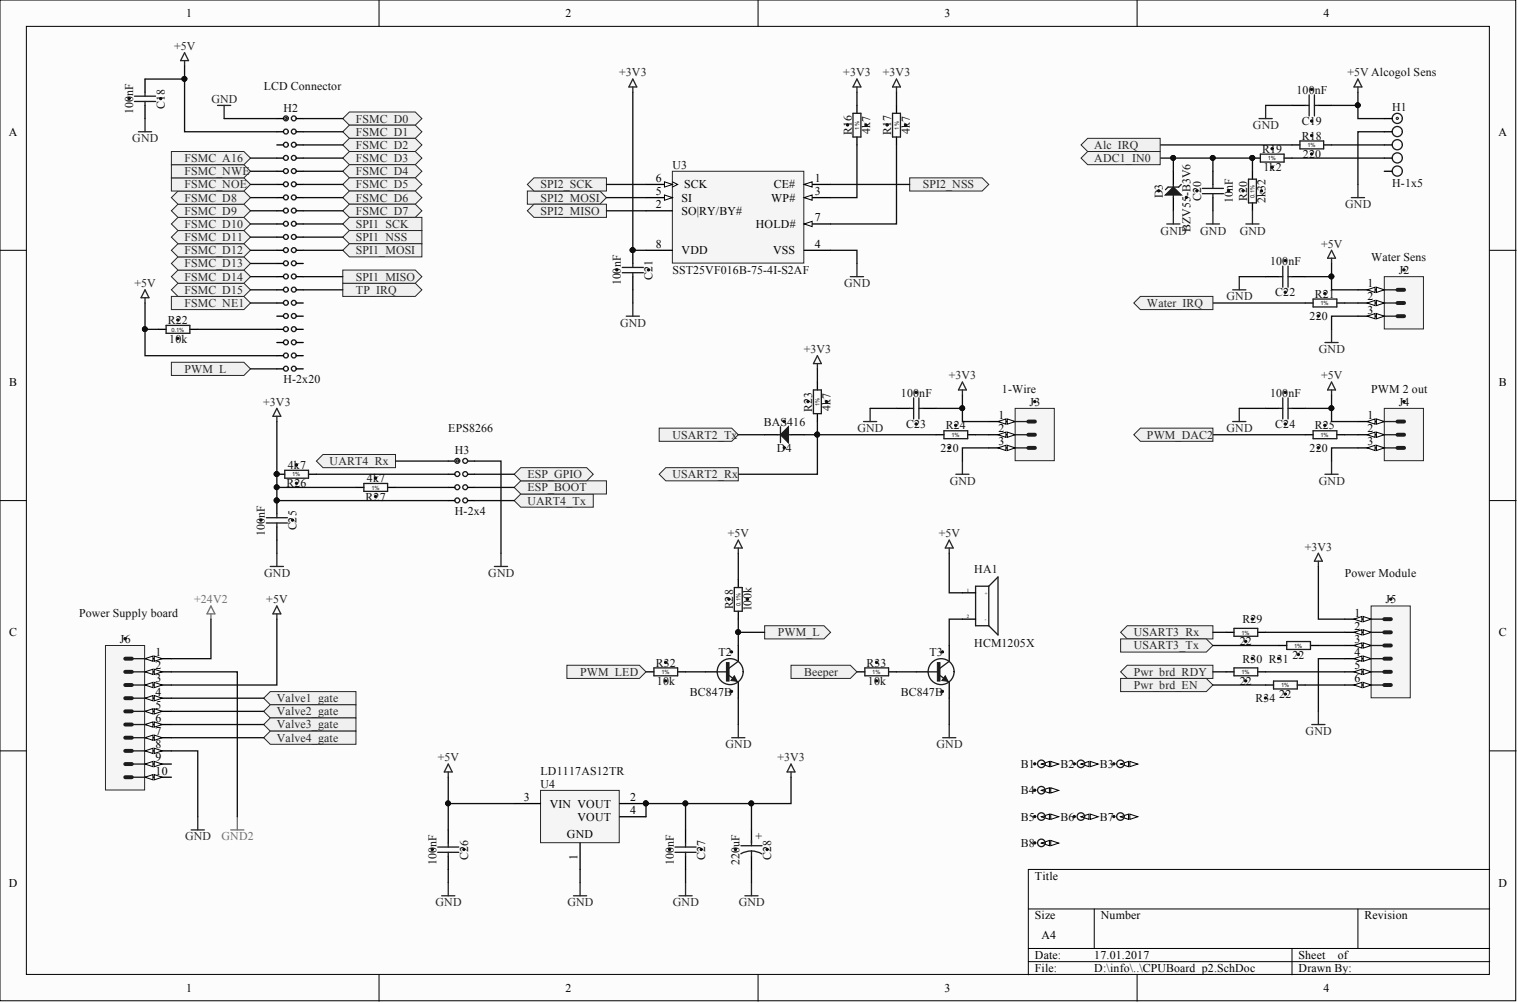
[picture p176: page 2]

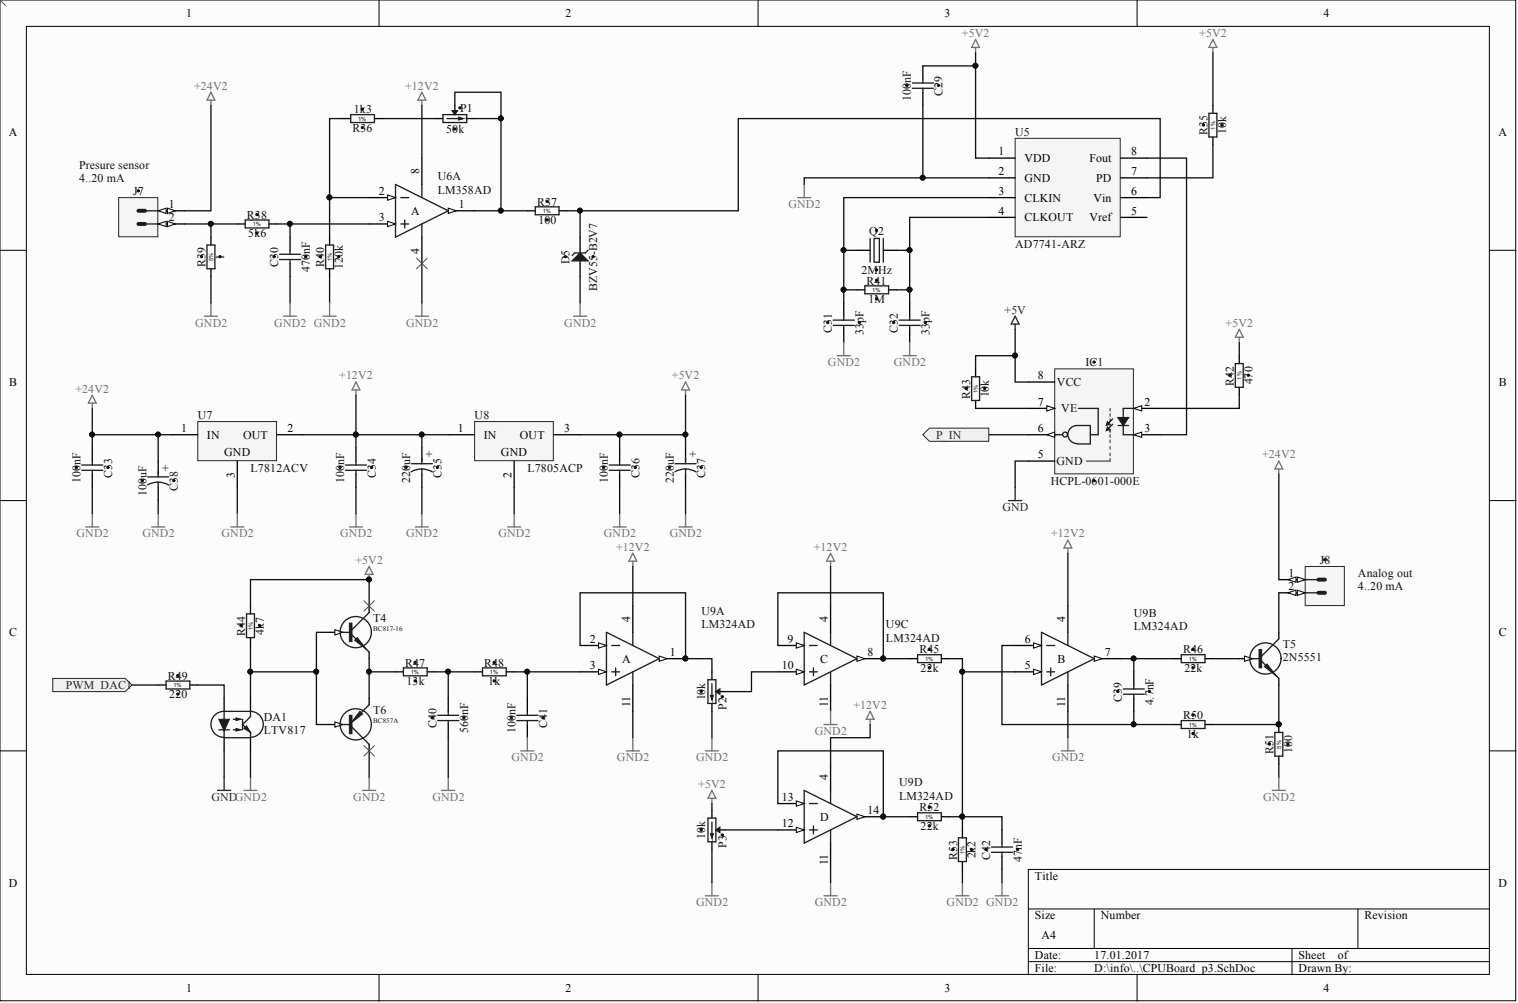
[picture p177: page 3]

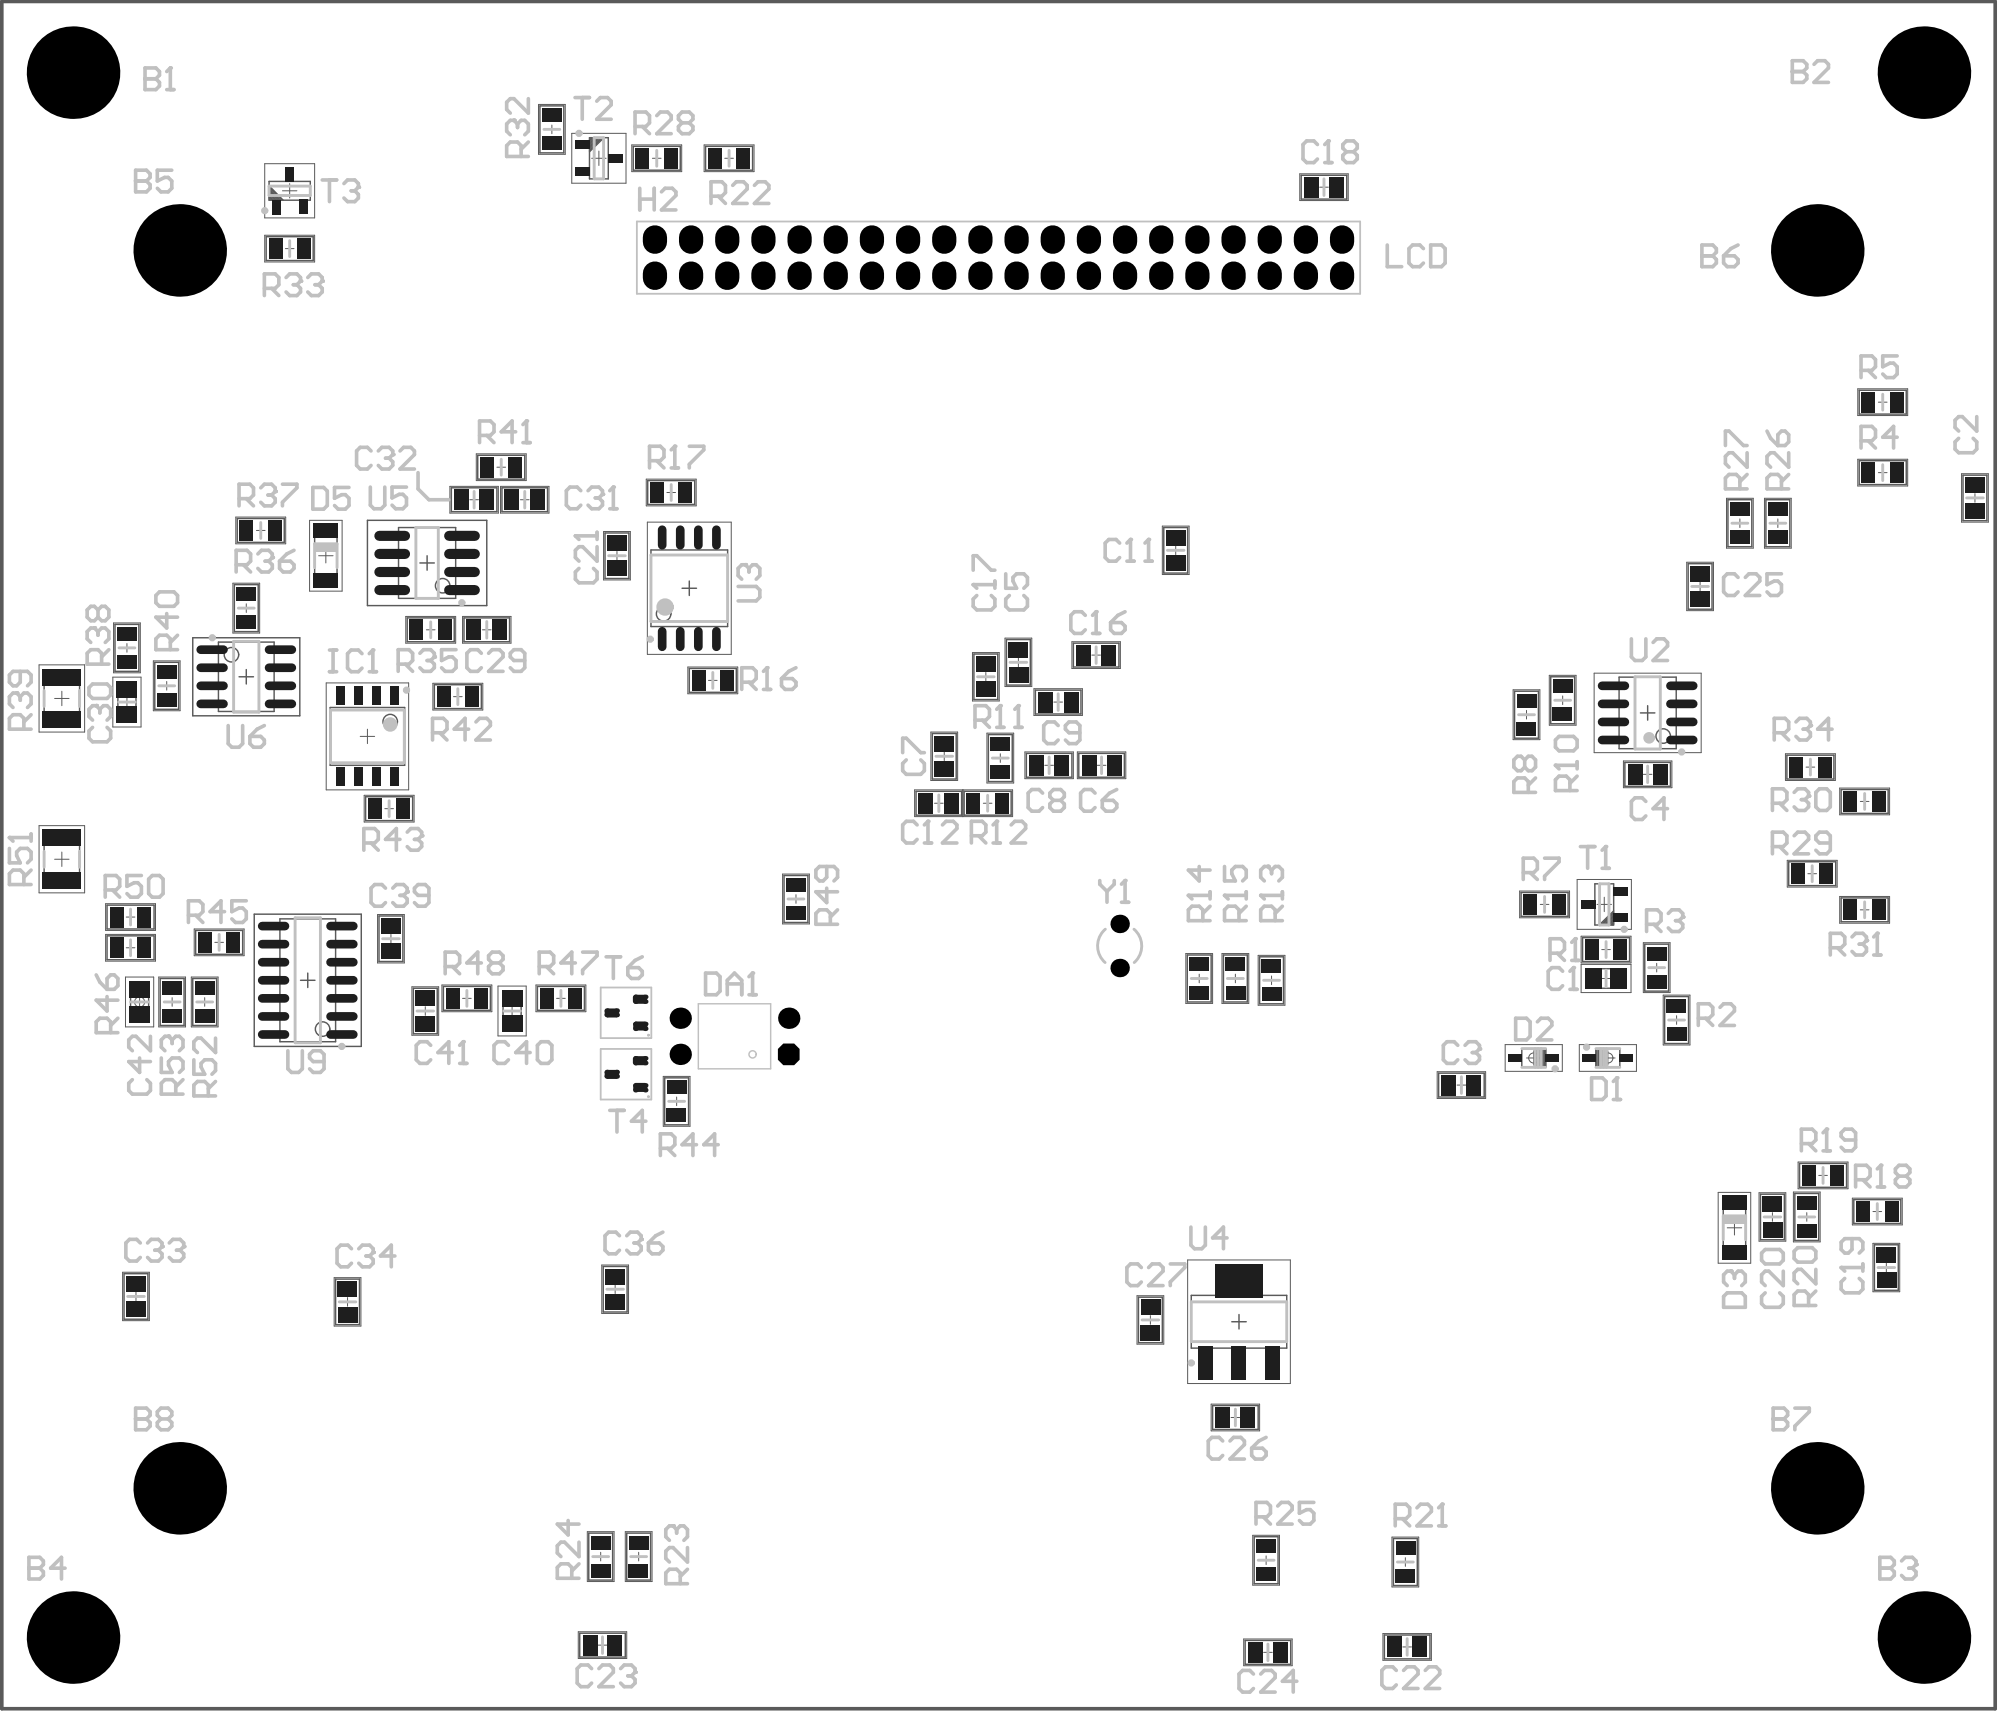
[picture p178: page 4]

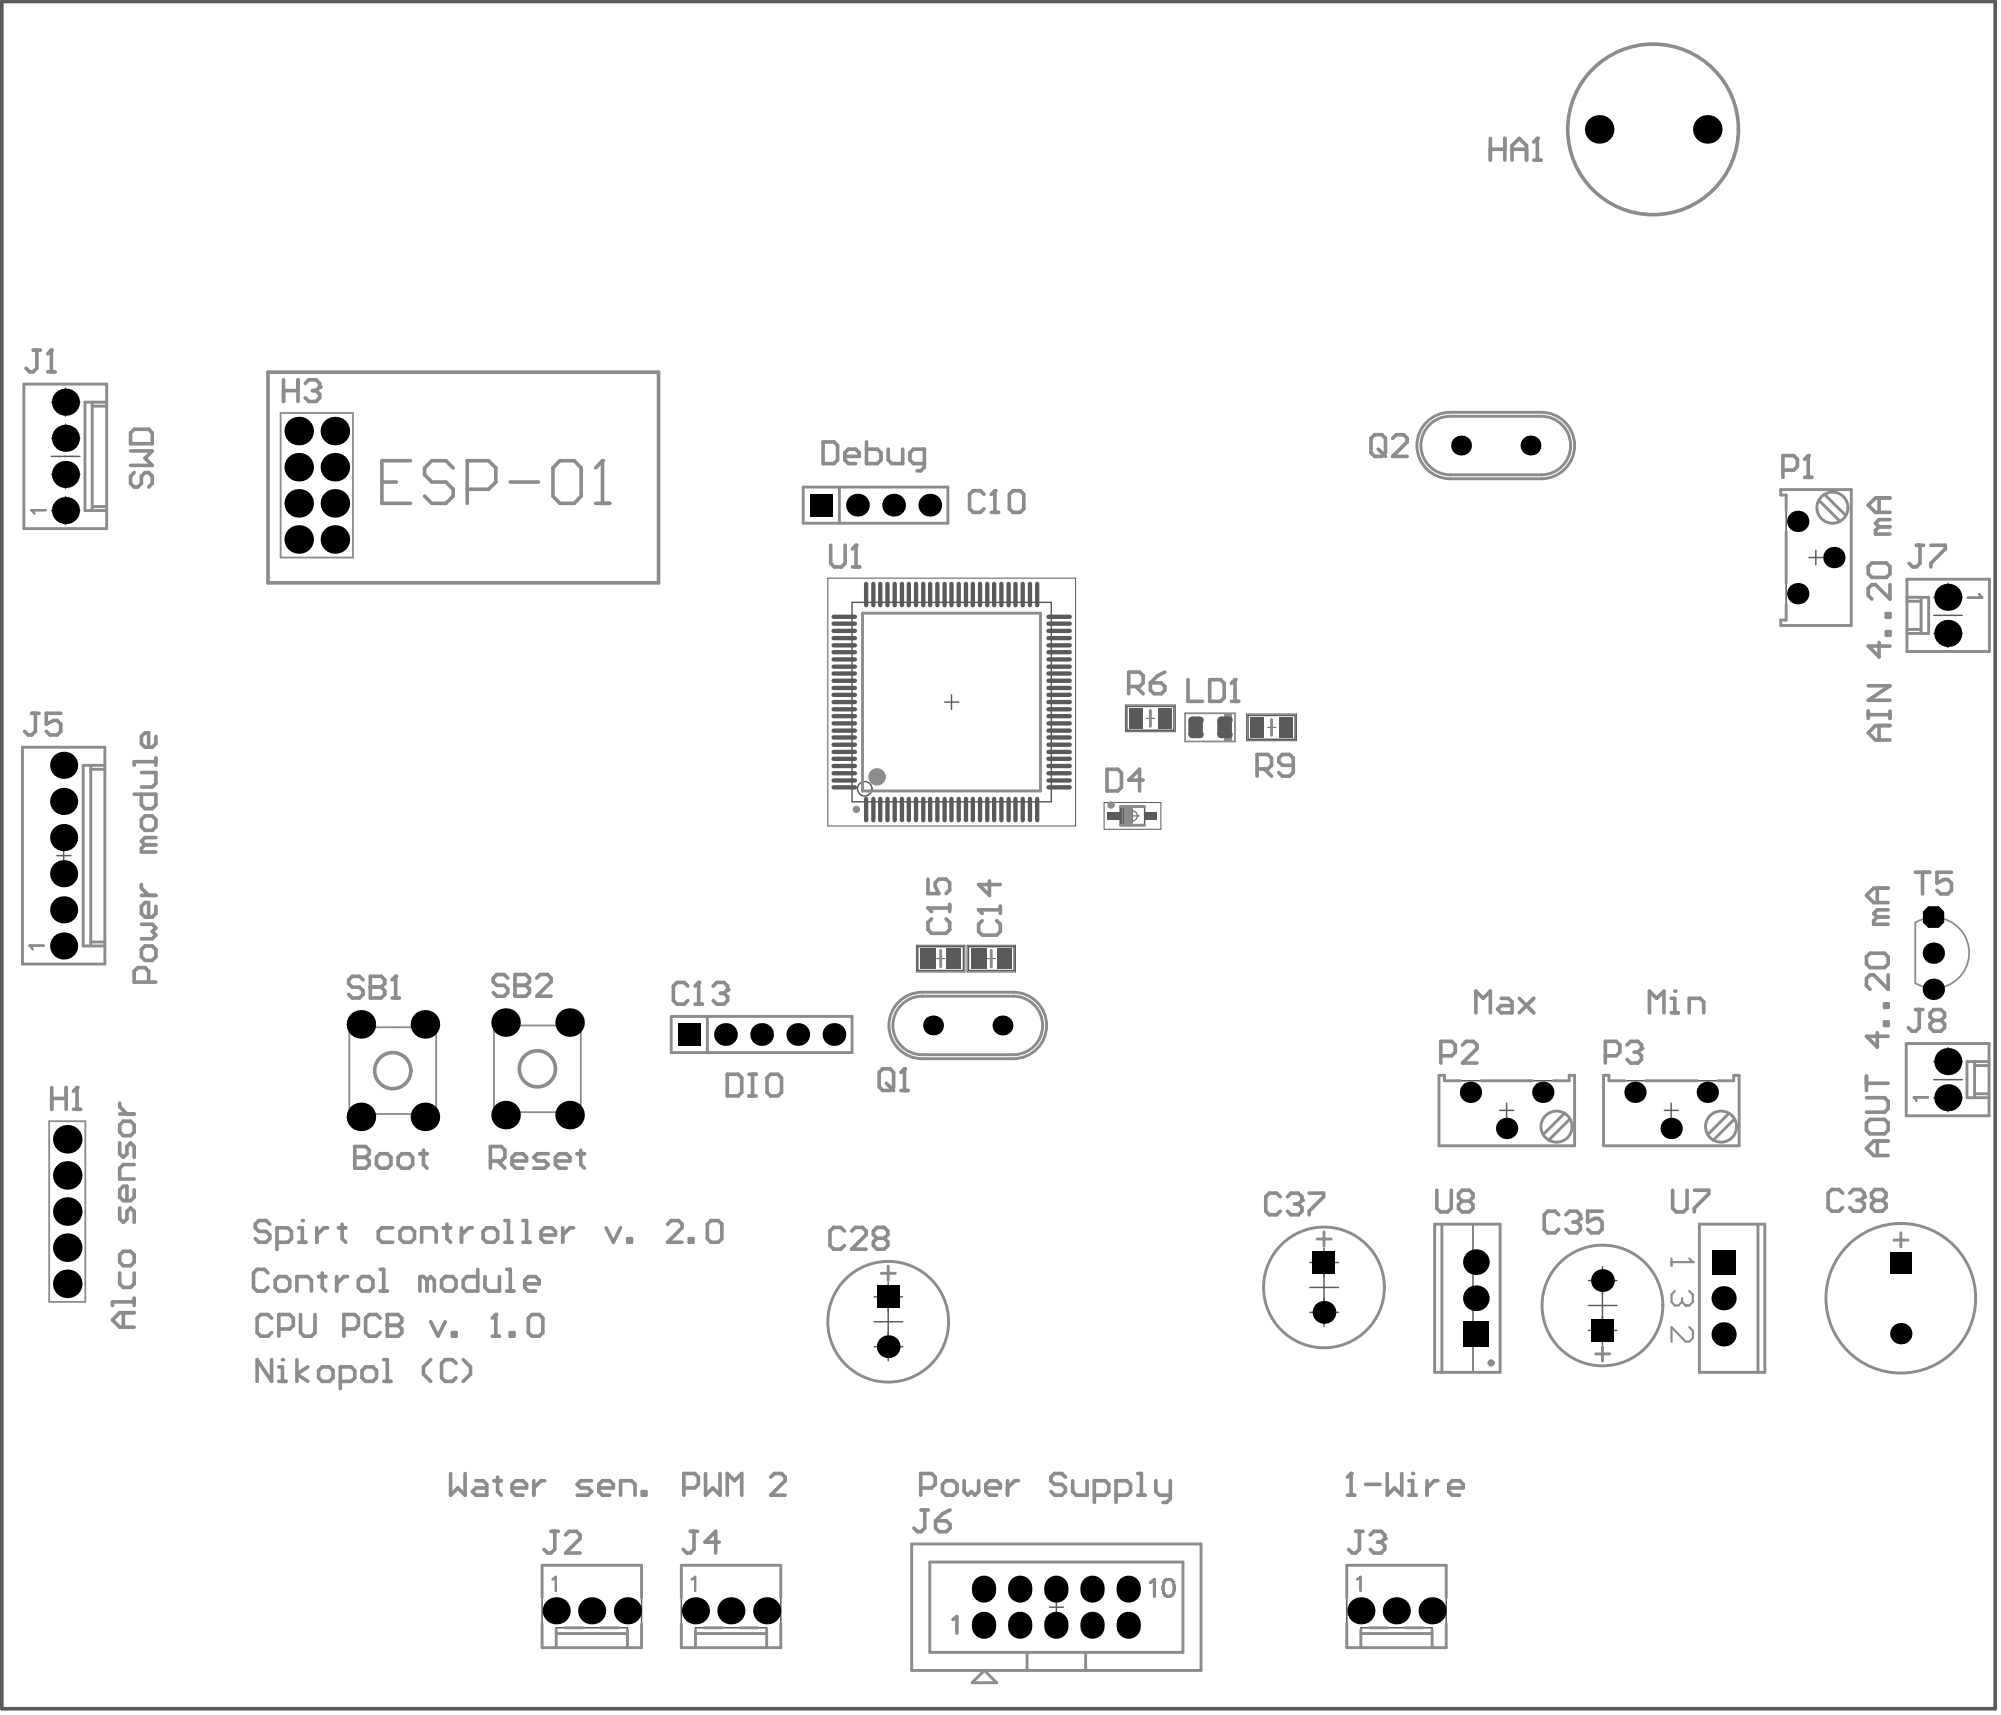
[picture p179: page 5]

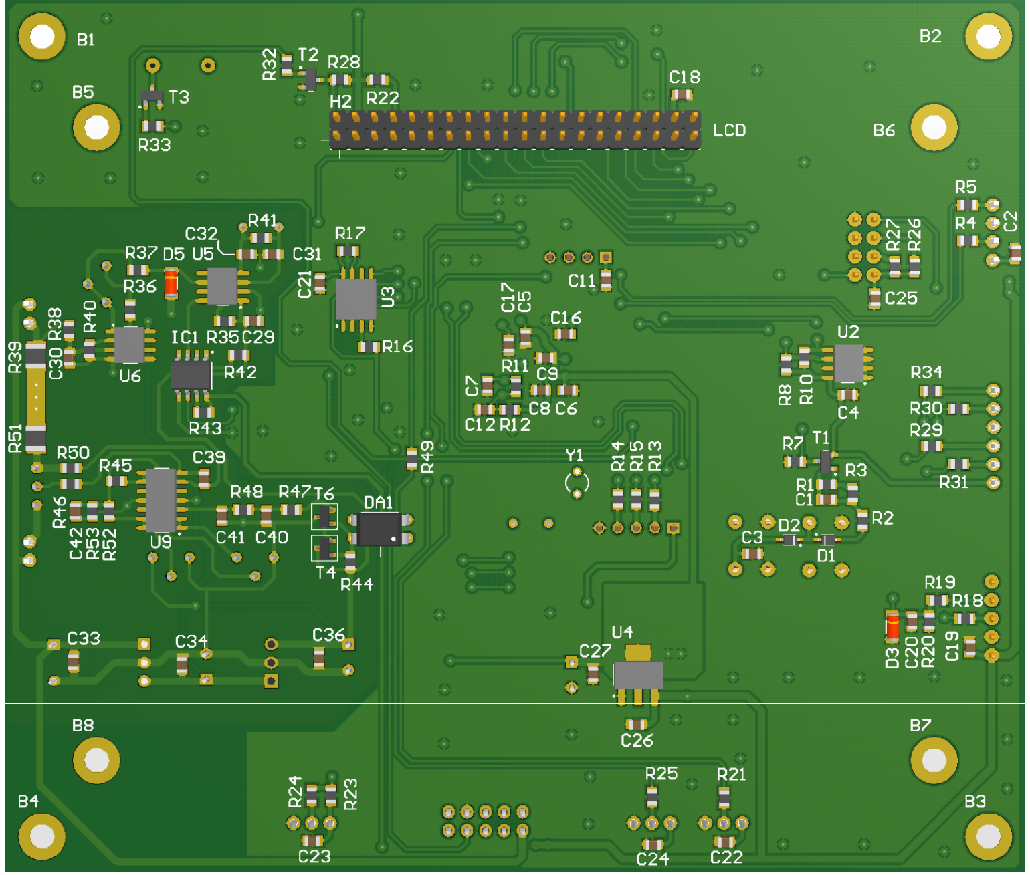
[picture p180: page 6]
