levichevdmitry/spirt_v2/control_module/hw/ControlModule/Project Outputs for DistribValveBoard/DistribValve.PDF

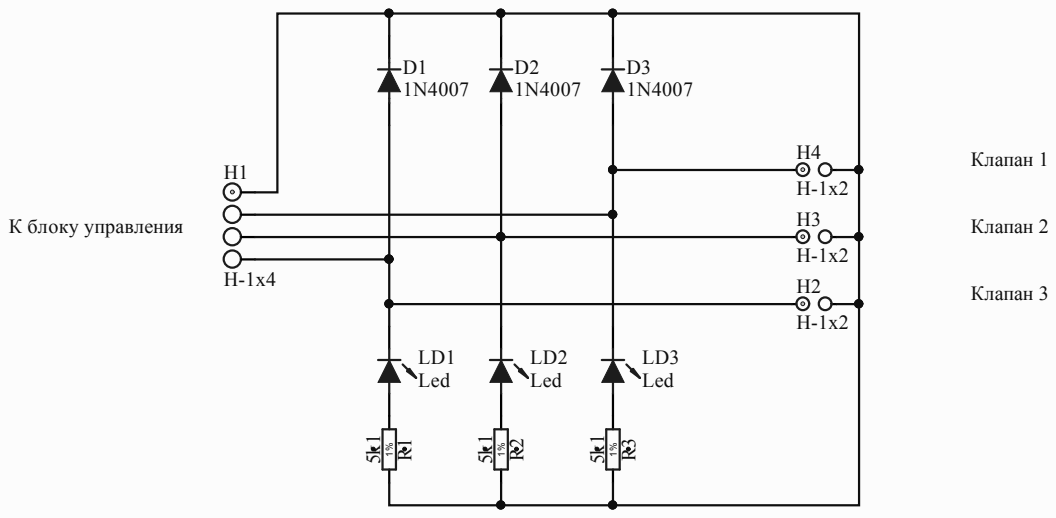
[picture p181: page 1]

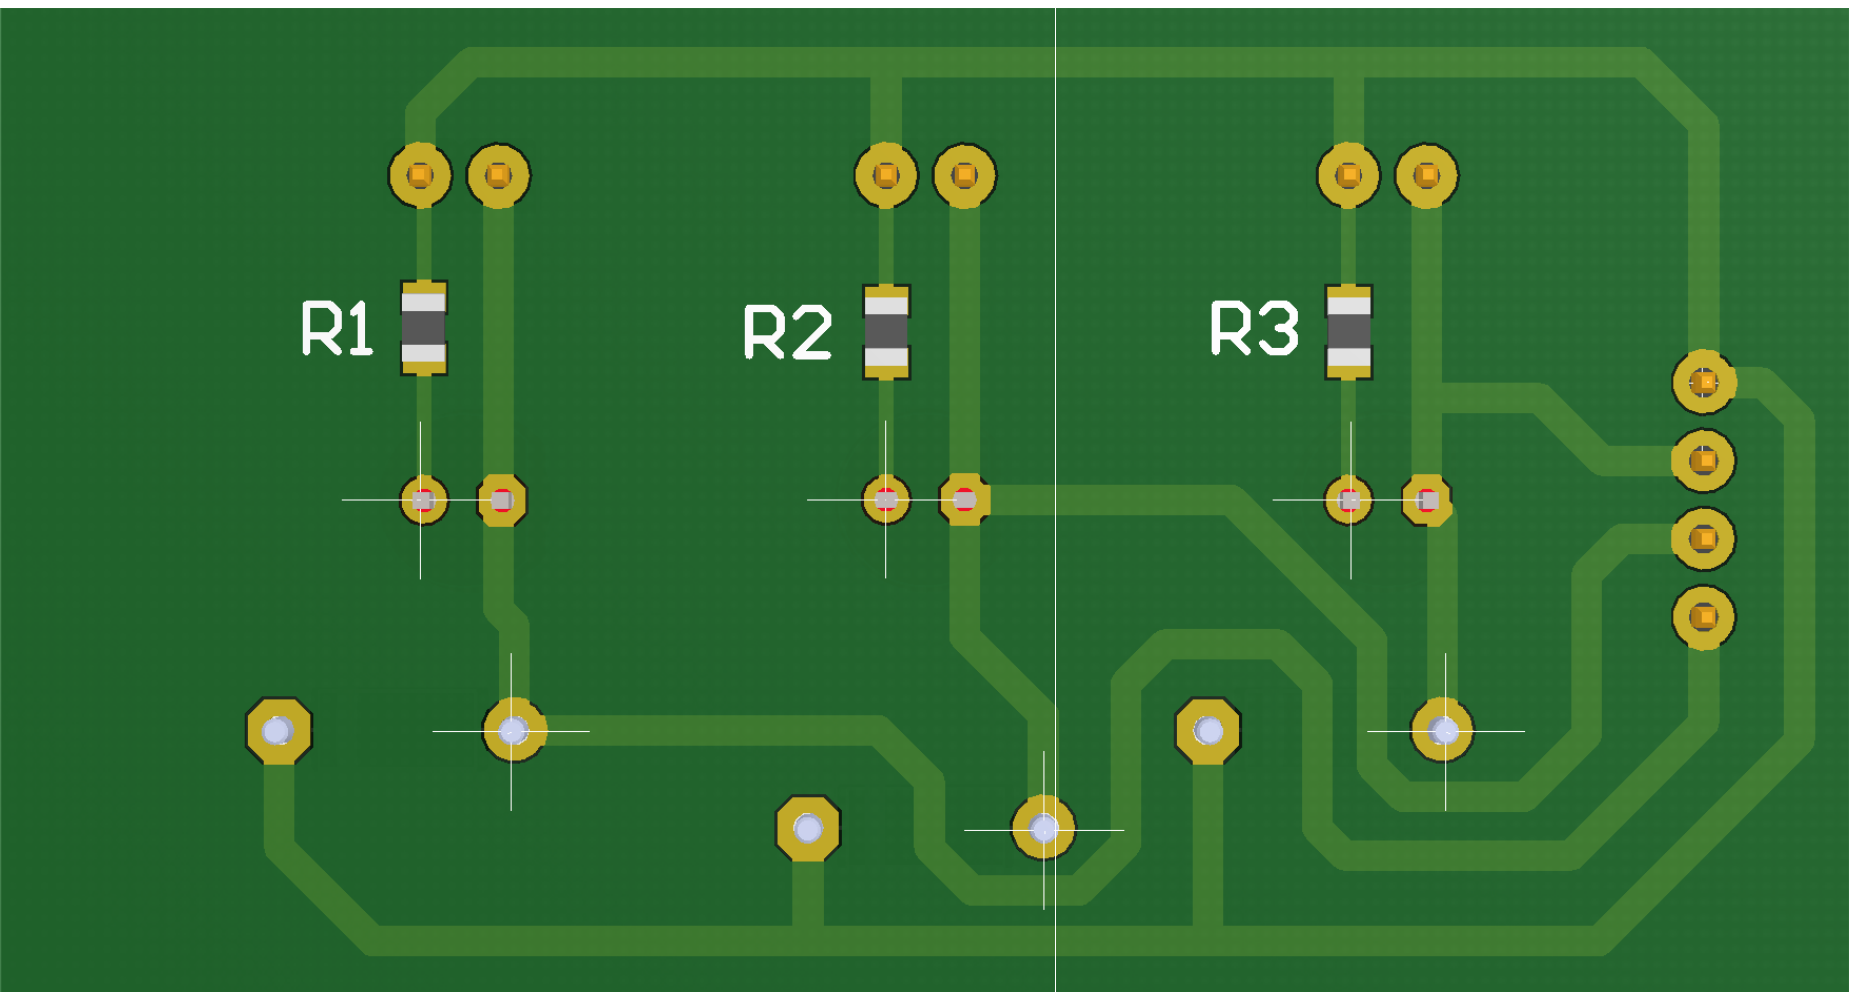
[picture p182: page 2]

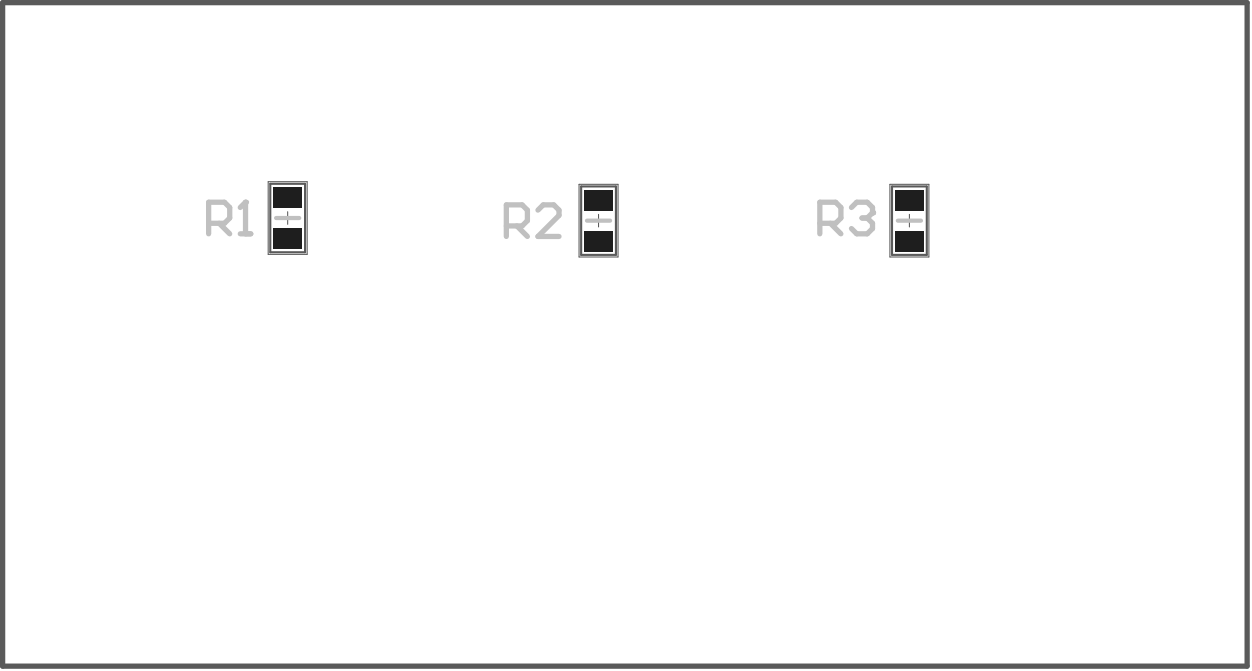
[picture p183: page 3]

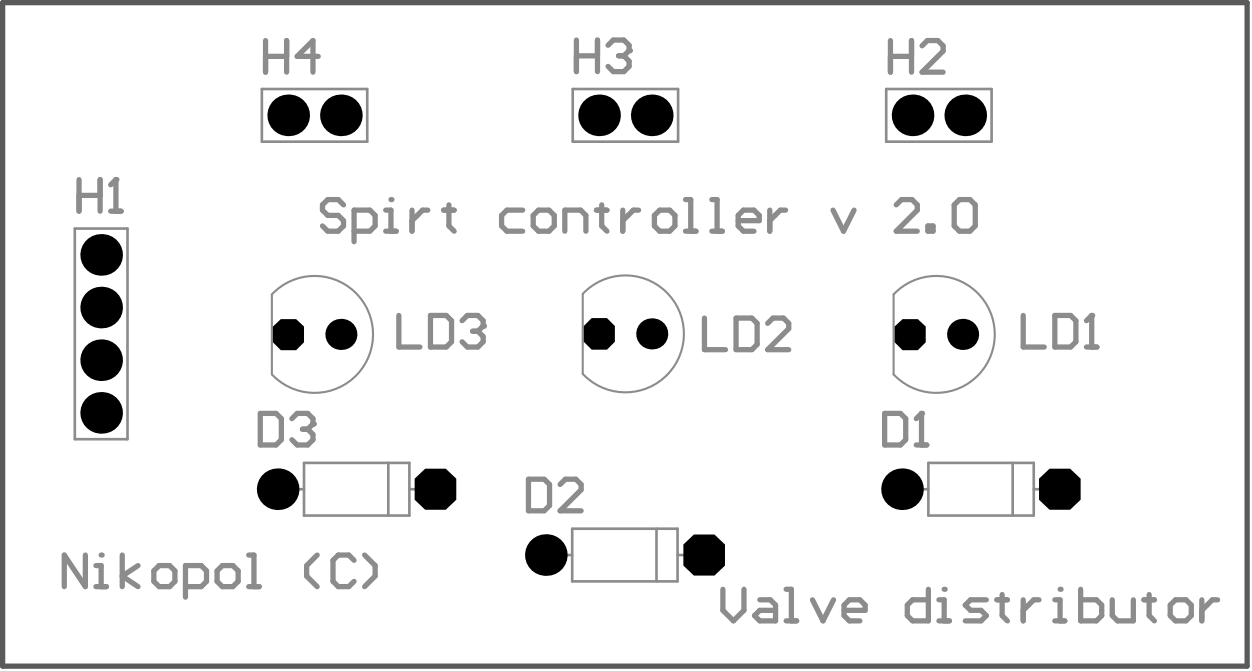
[picture p184: page 4]
