levichevdmitry/spirt_v2/control_module/hw/ControlModule/Project Outputs for SensCon/SensCon.PDF

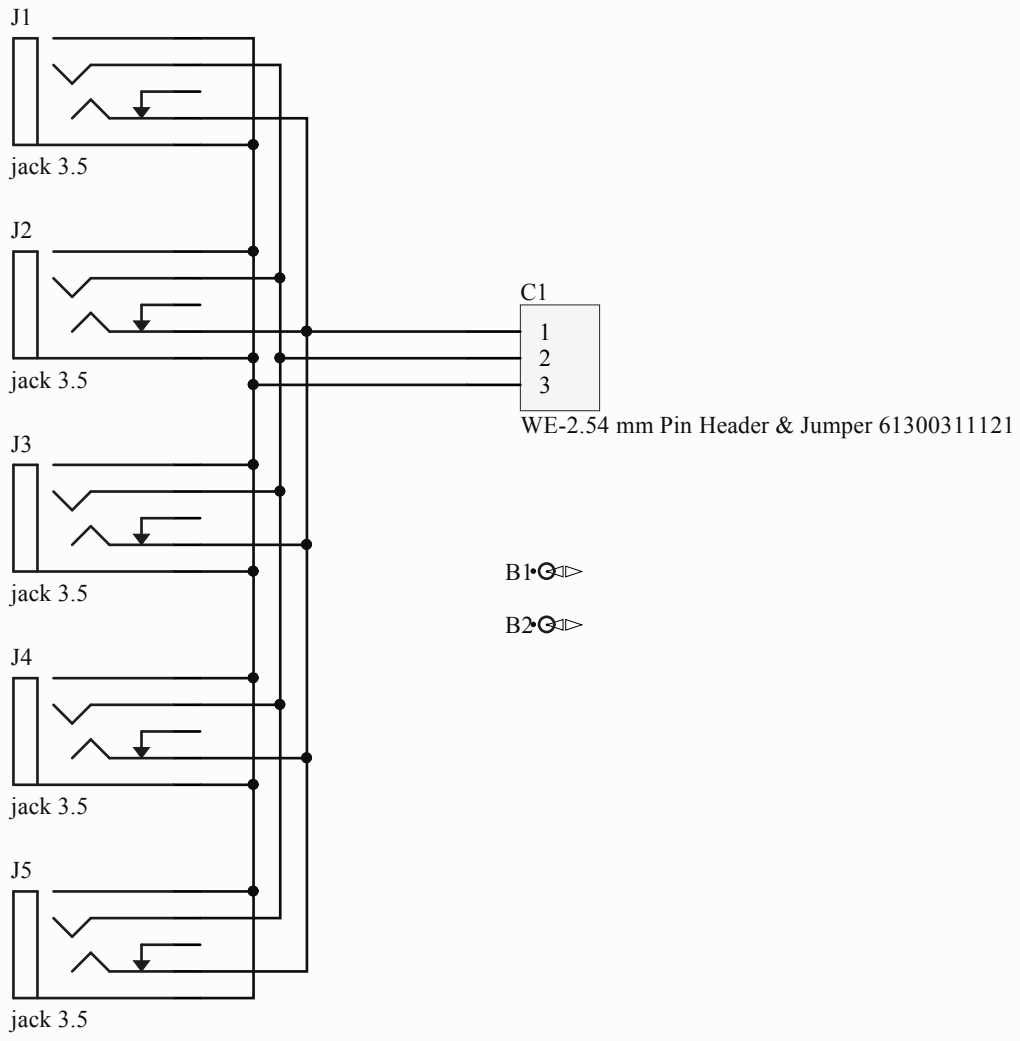
[picture p185: page 1]

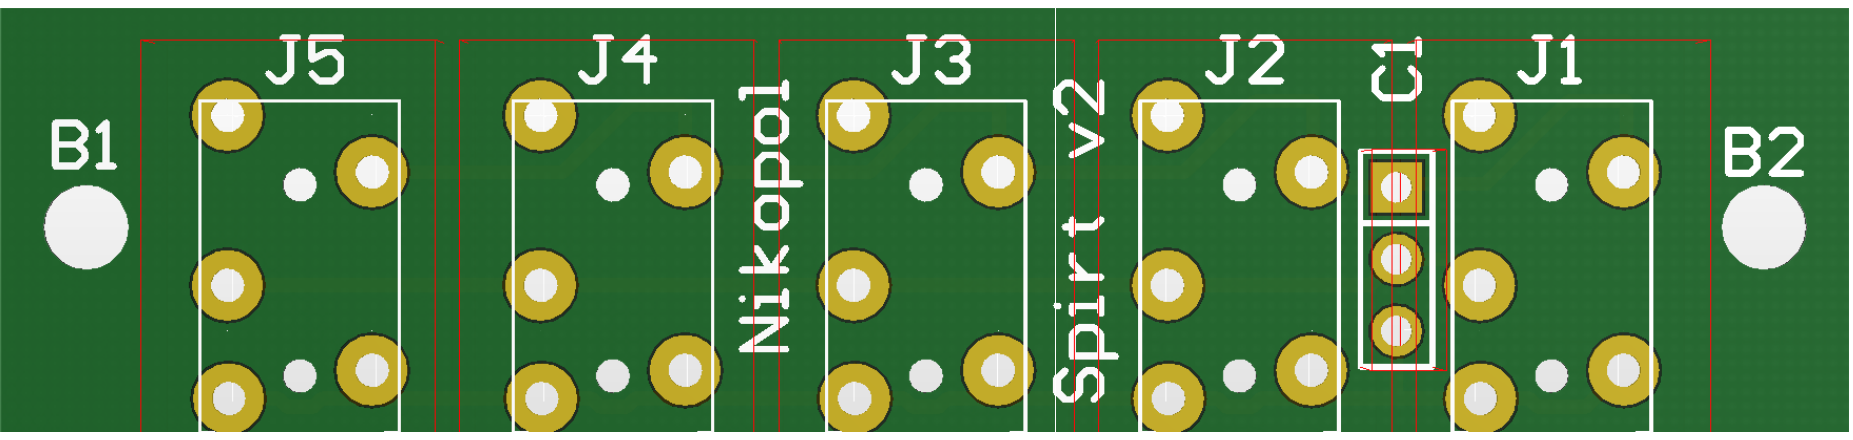
[picture p186: page 2]

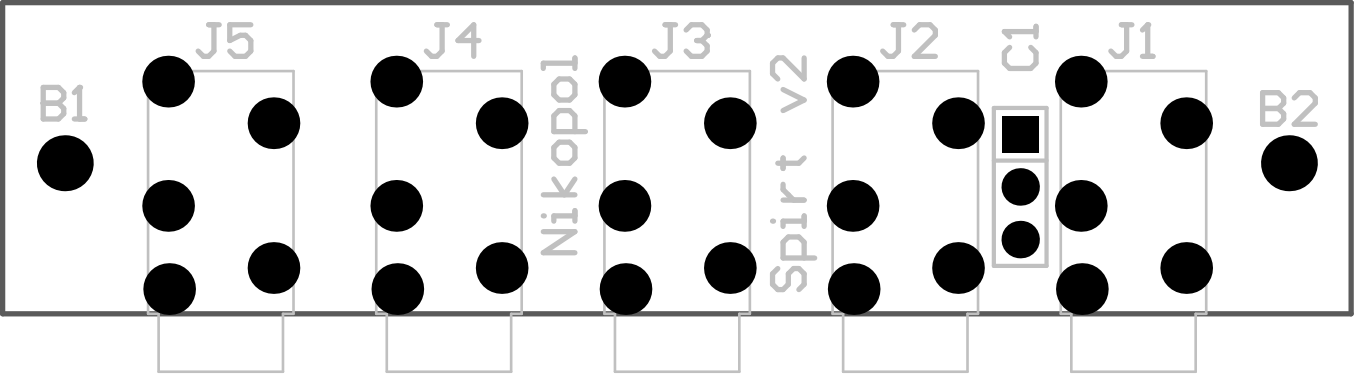
[picture p187: page 3]
