levichevdmitry/spirt_v2/power_module/hw/PowerModule/Project Outputs for PowerBoard/PM_Power_board.PDF

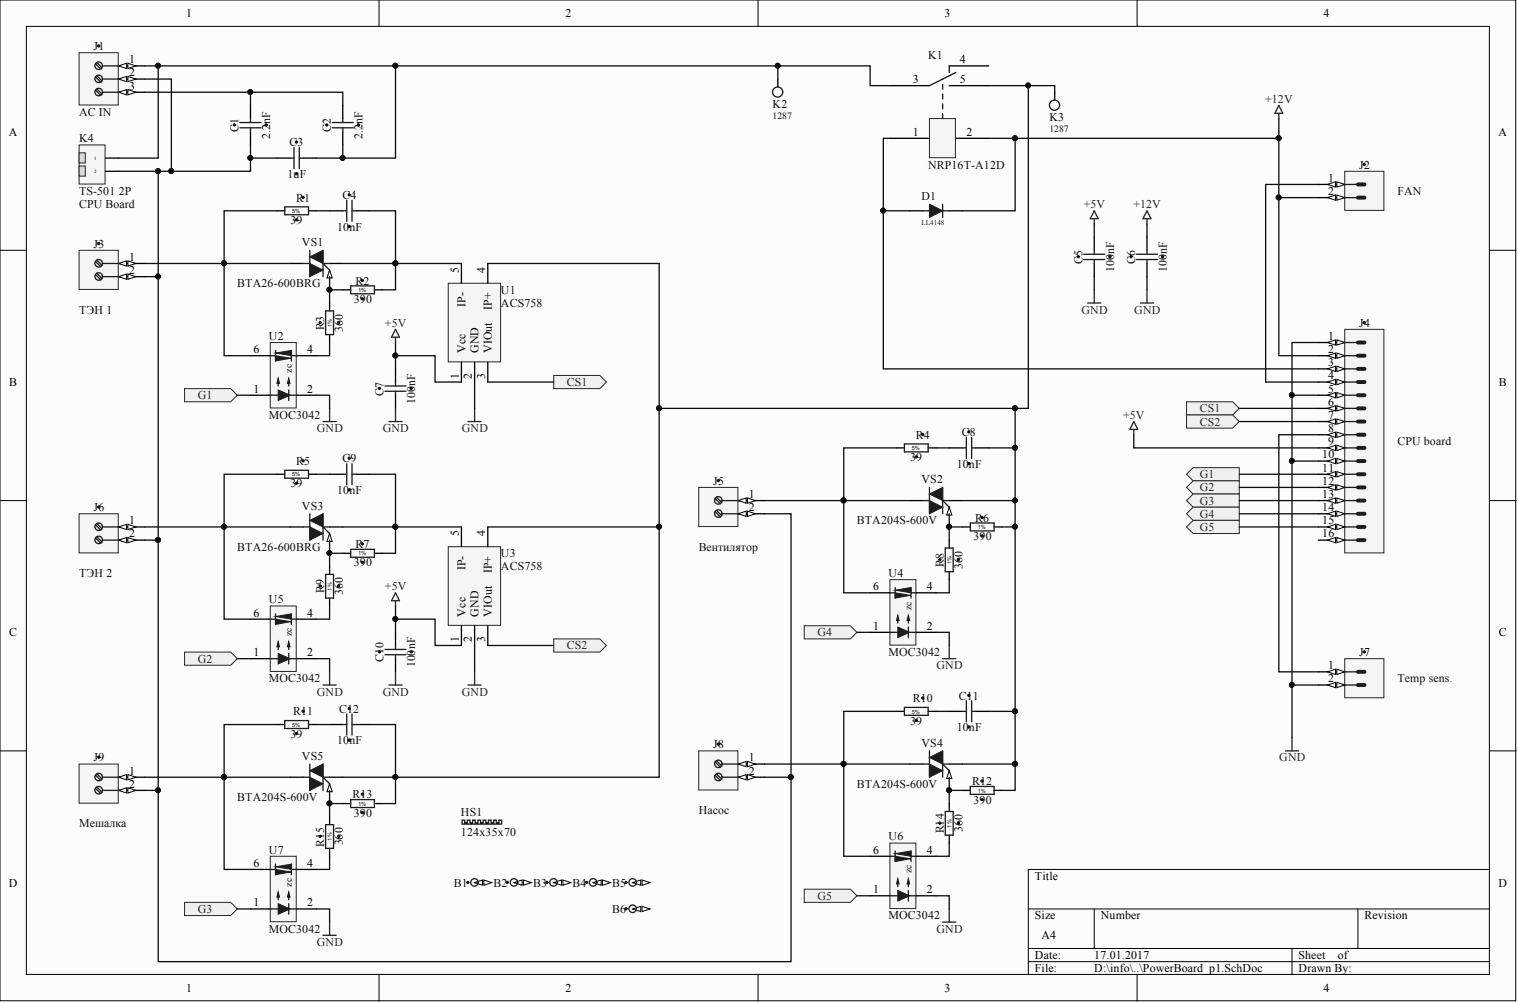
[picture p188: page 1]

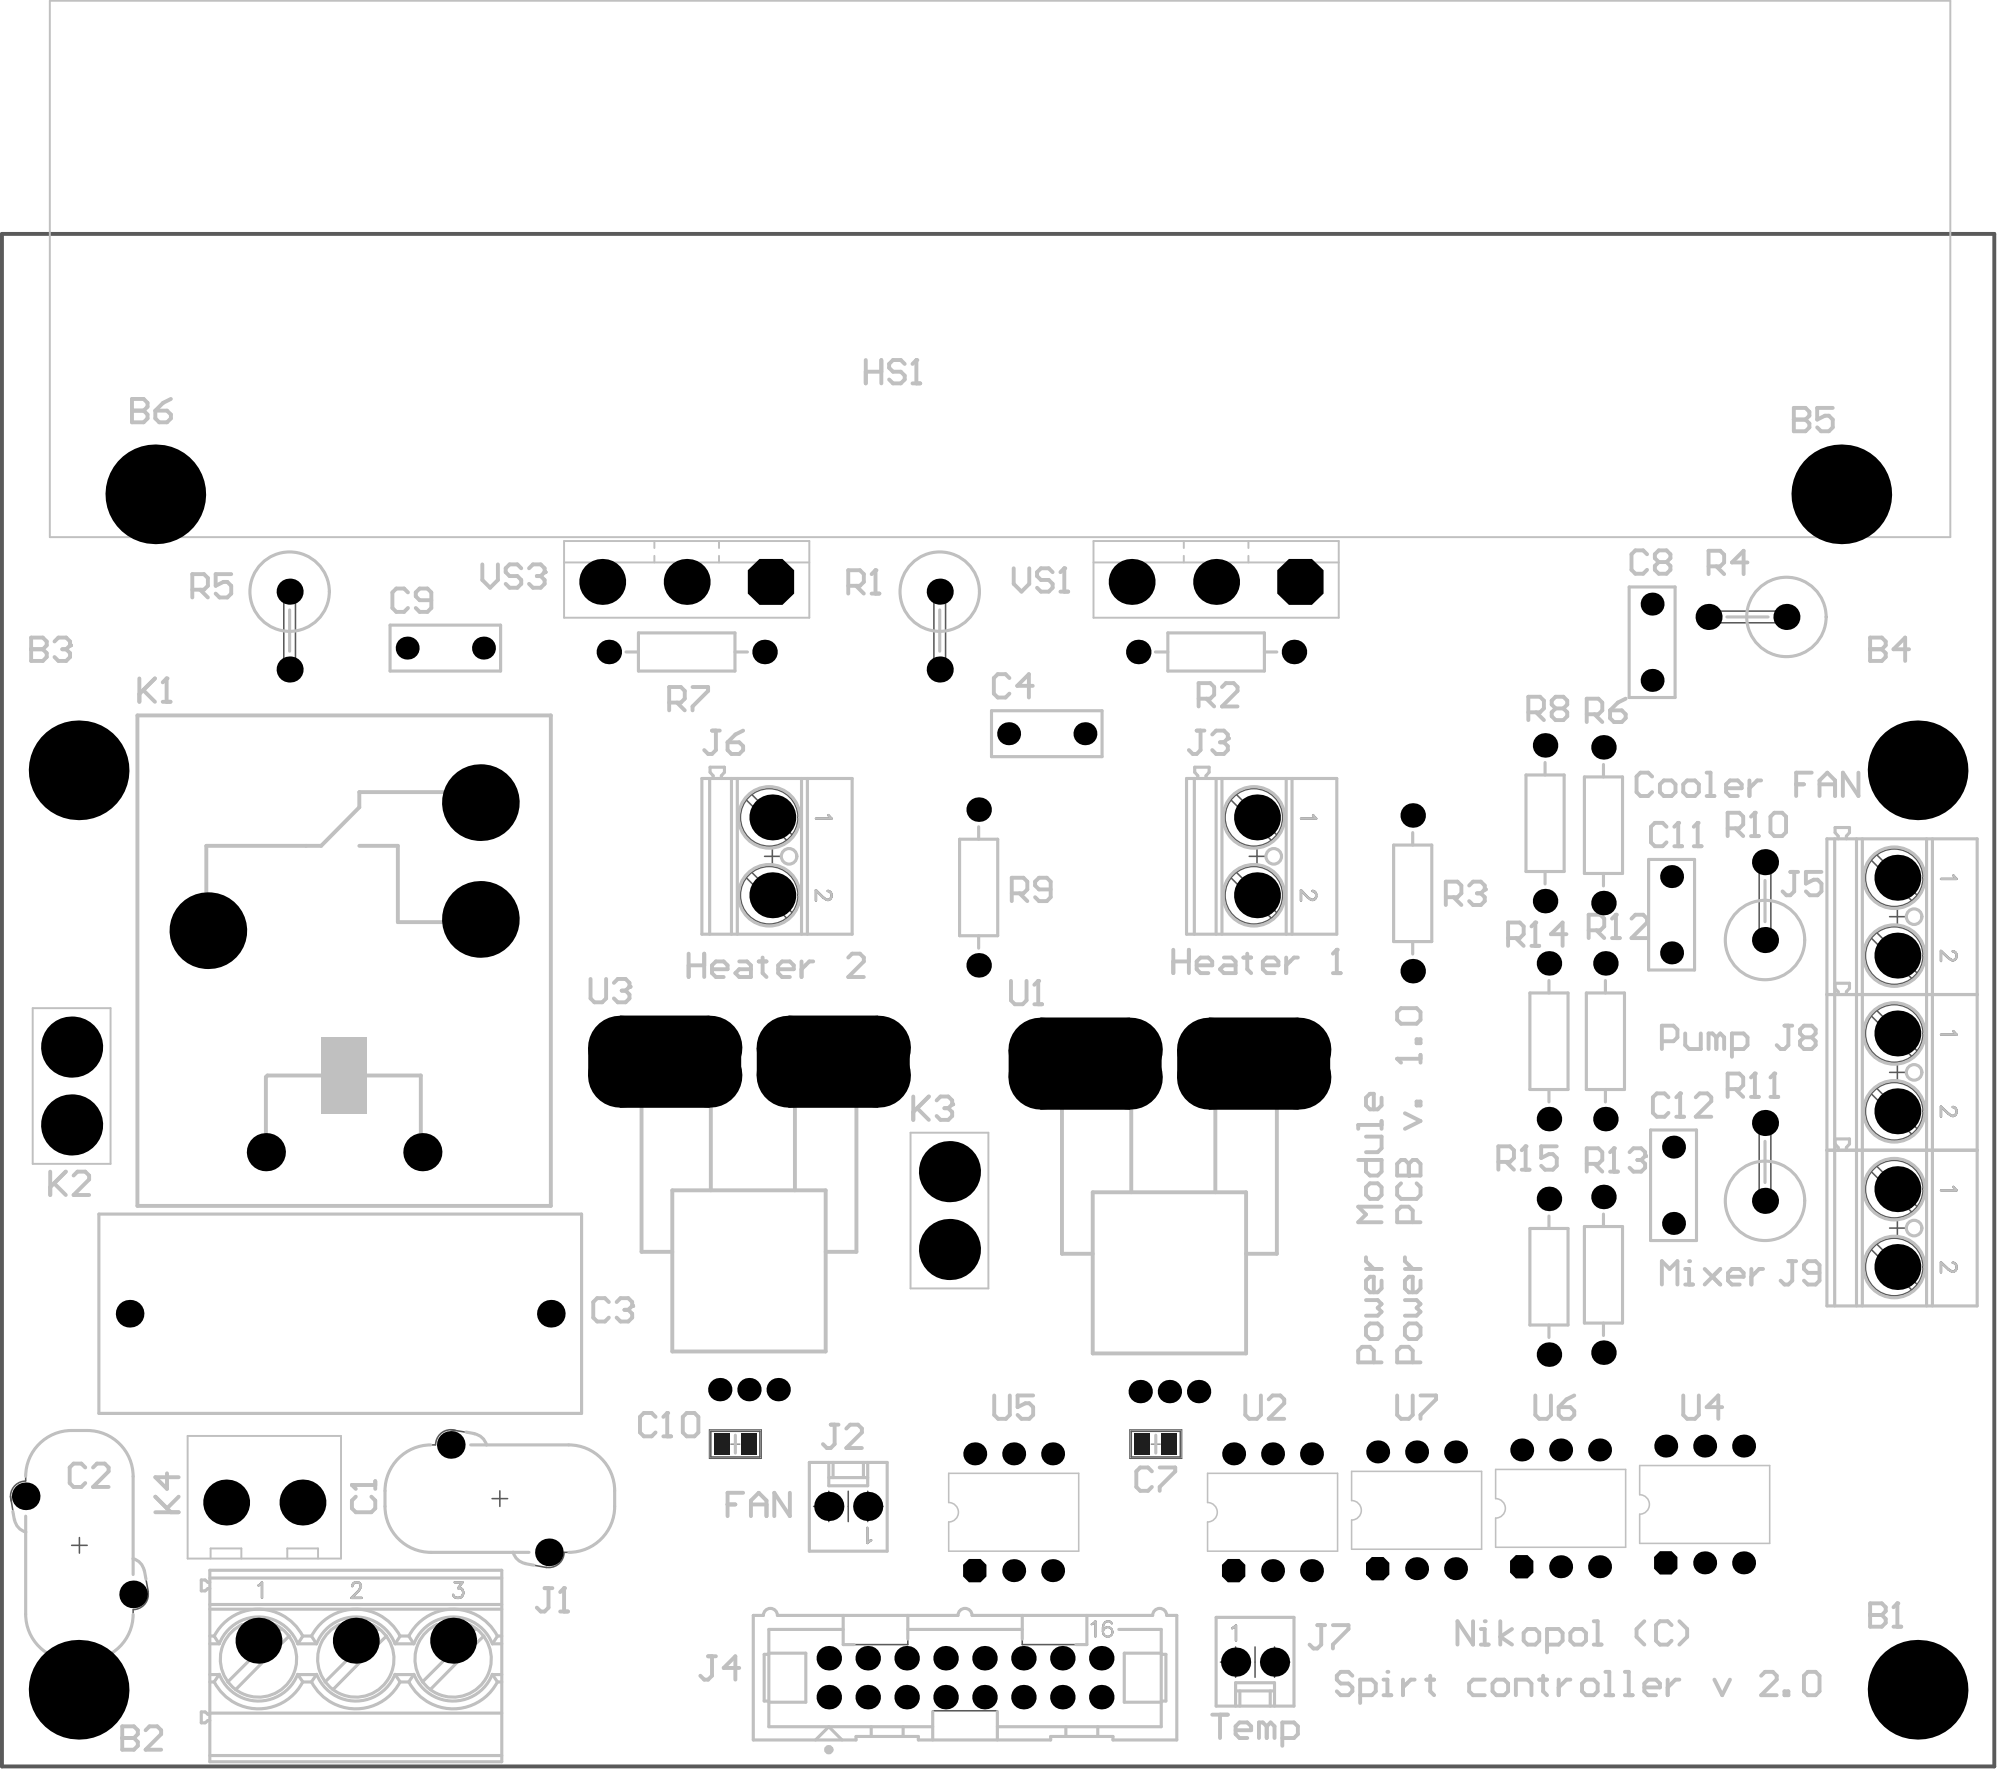
[picture p189: page 2]

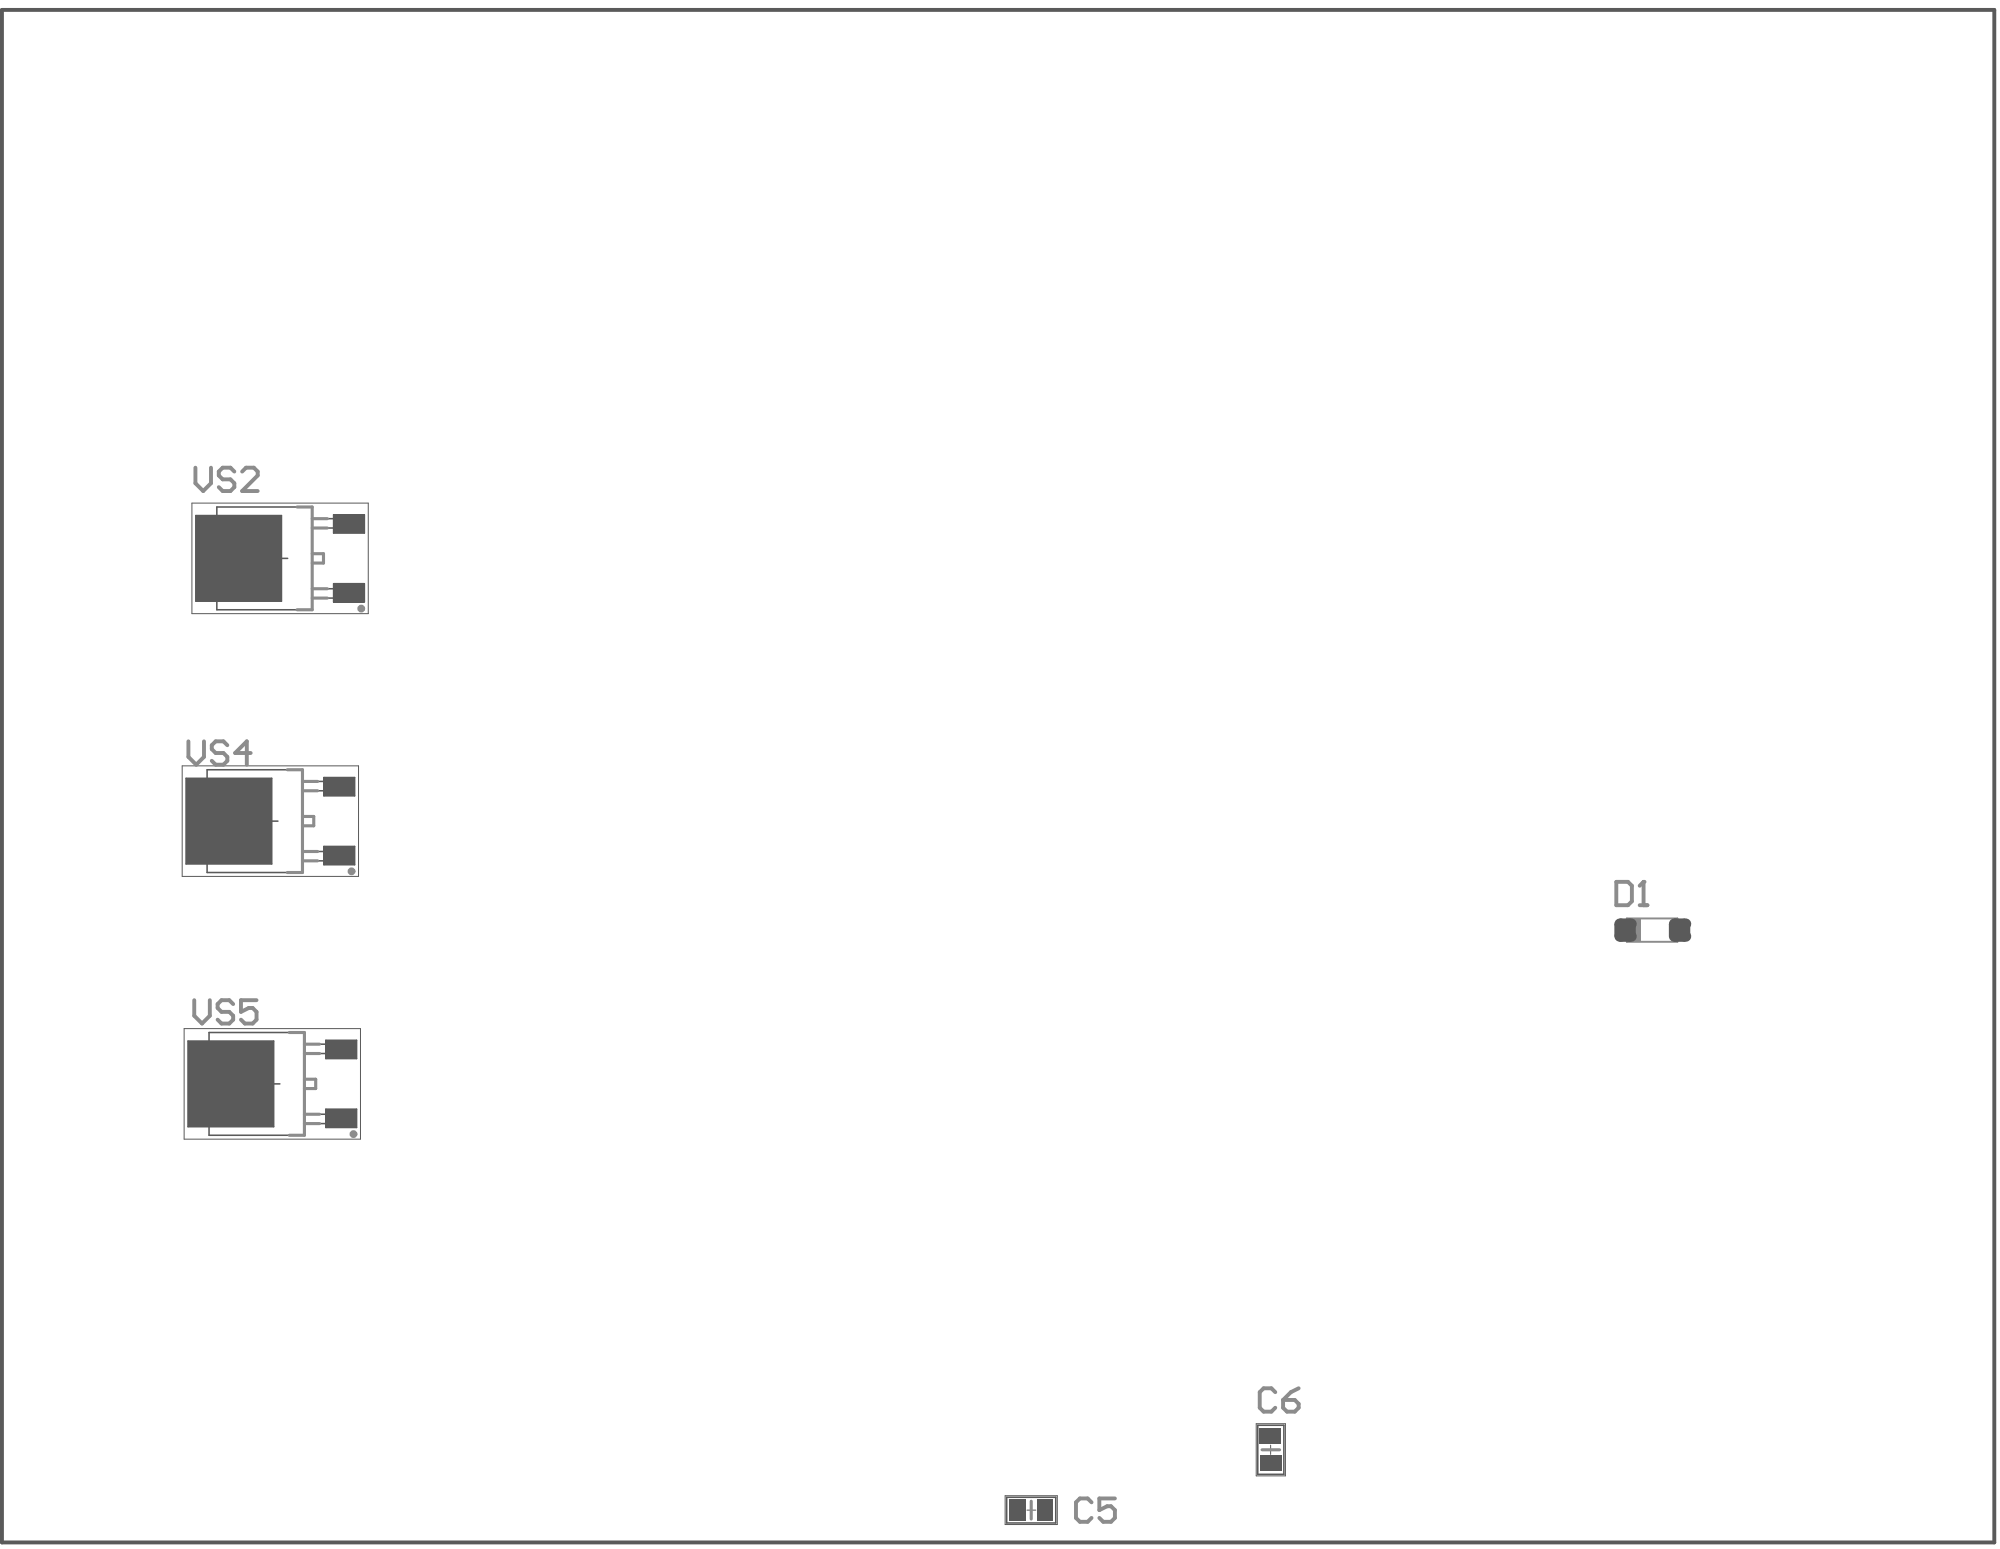
[picture p190: page 3]

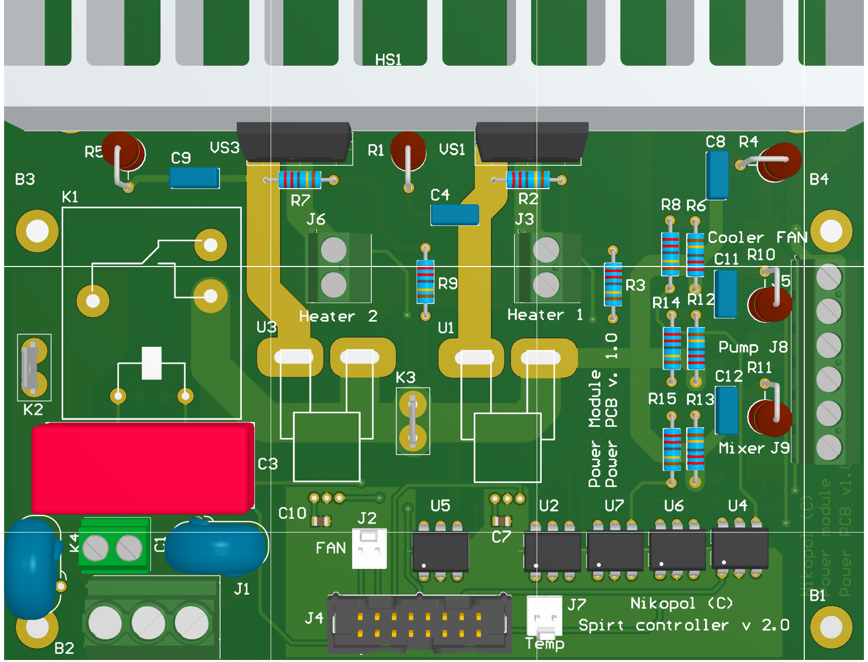
[picture p191: page 4]
