levichevdmitry/spirt_v2/general_hw/Connection_diagram_rev_A.pdf

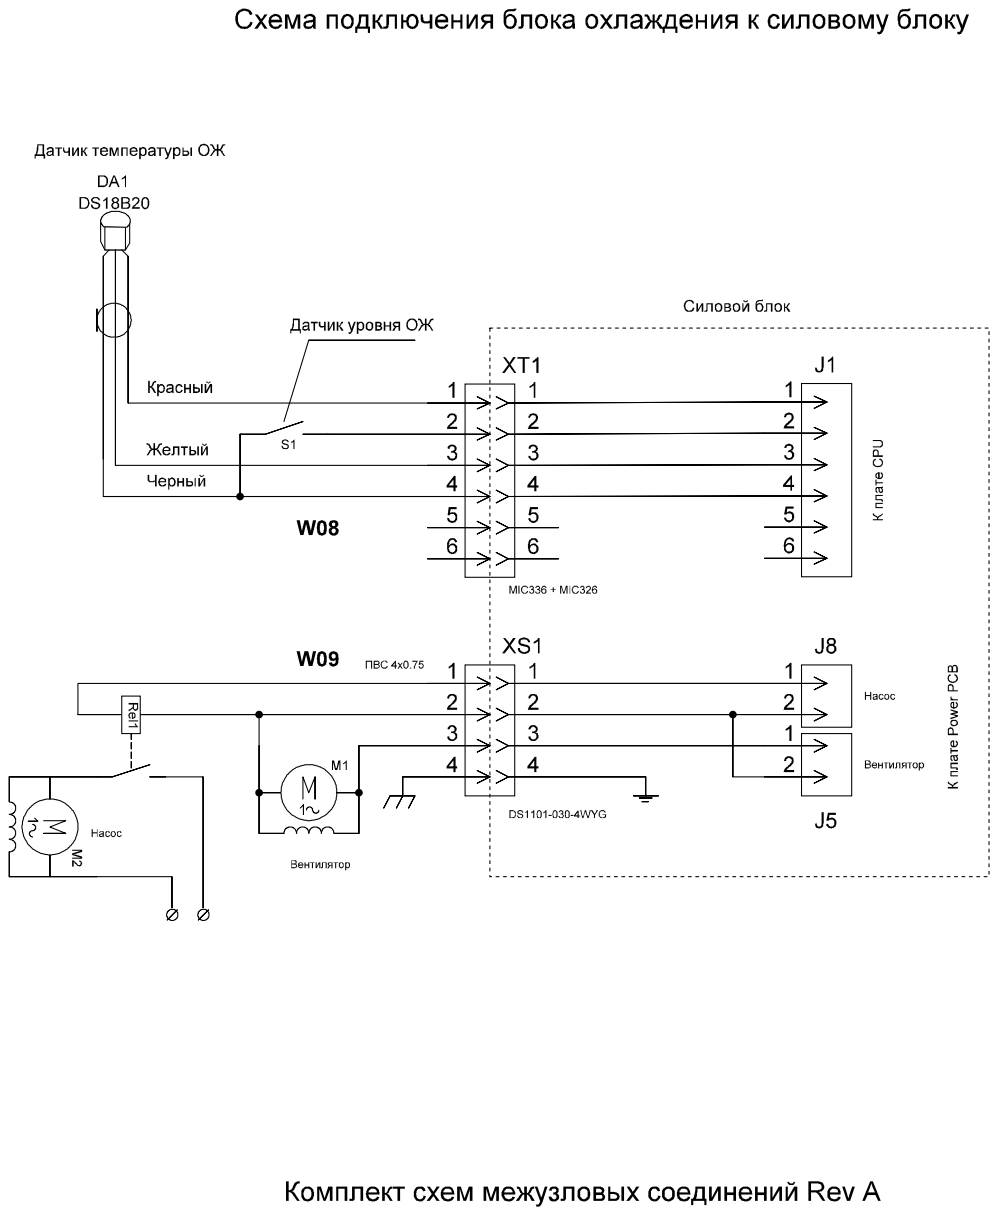
[picture p192: page 1]

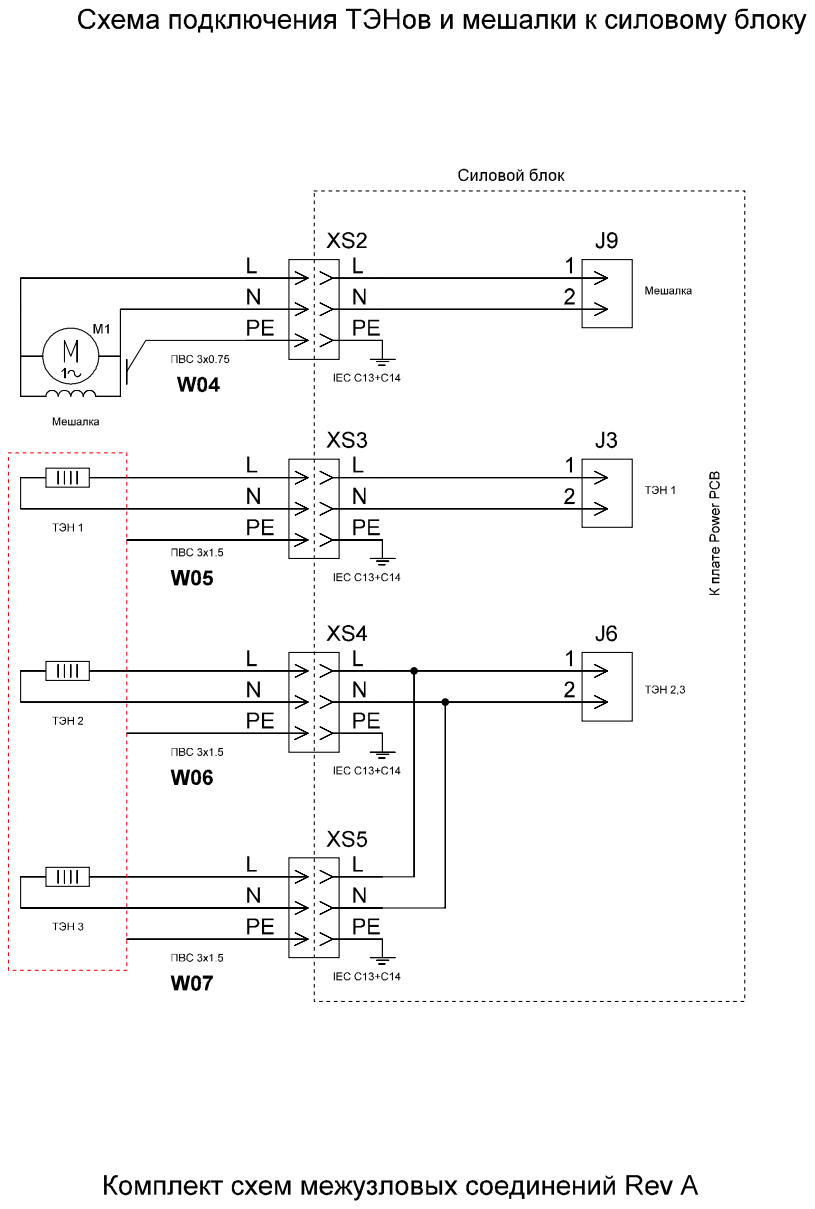
[picture p193: page 2]

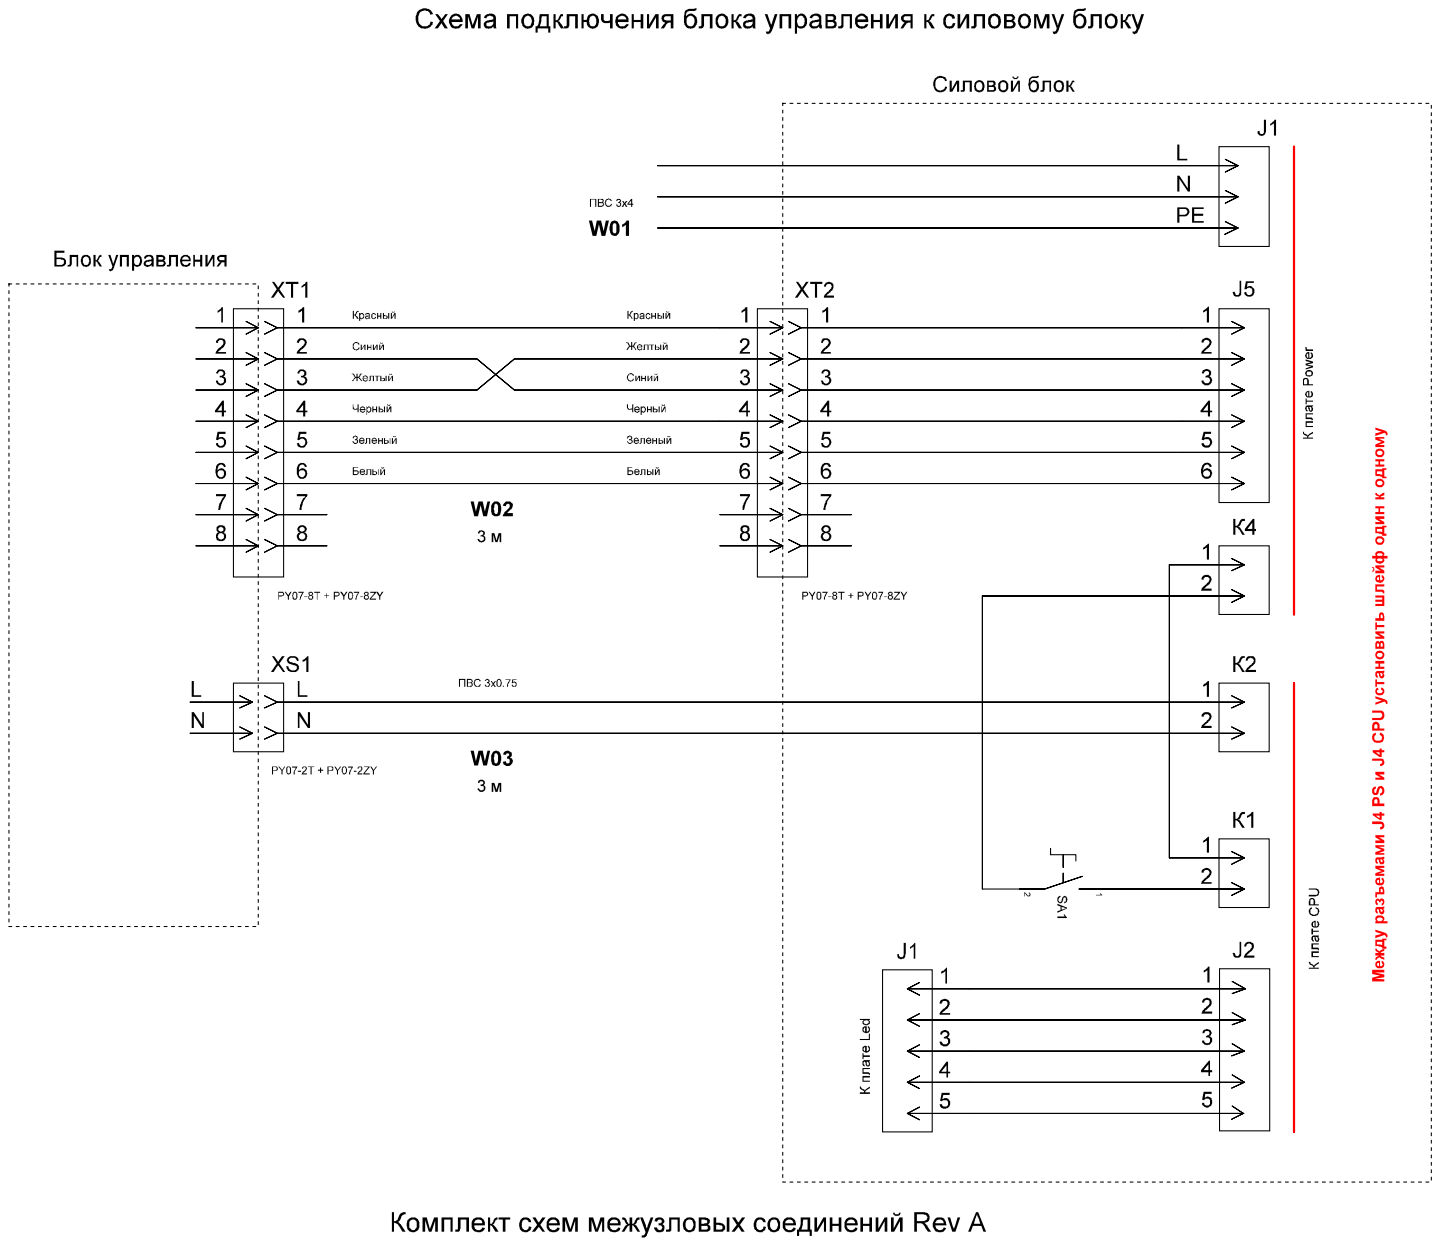
[picture p194: page 3]

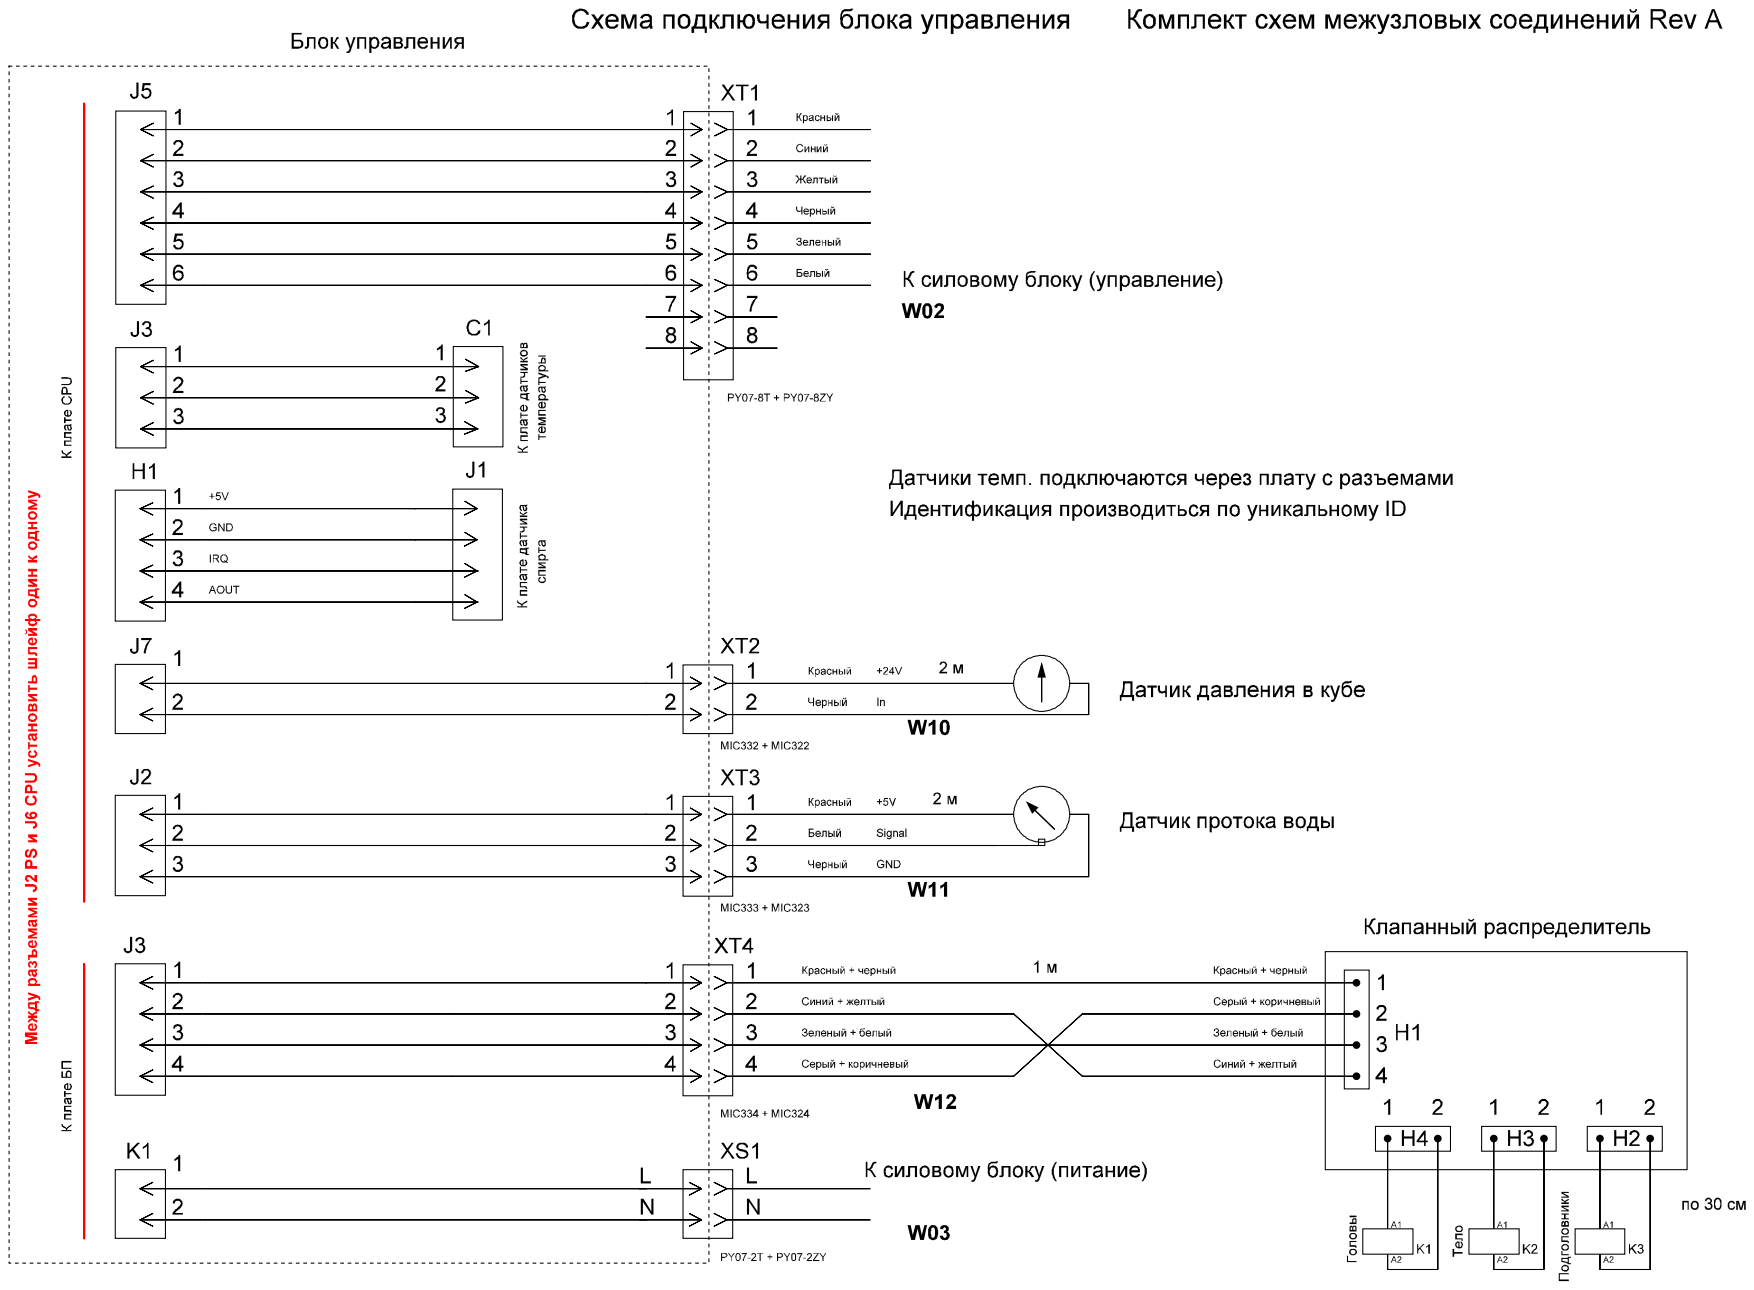
[picture p195: page 4]

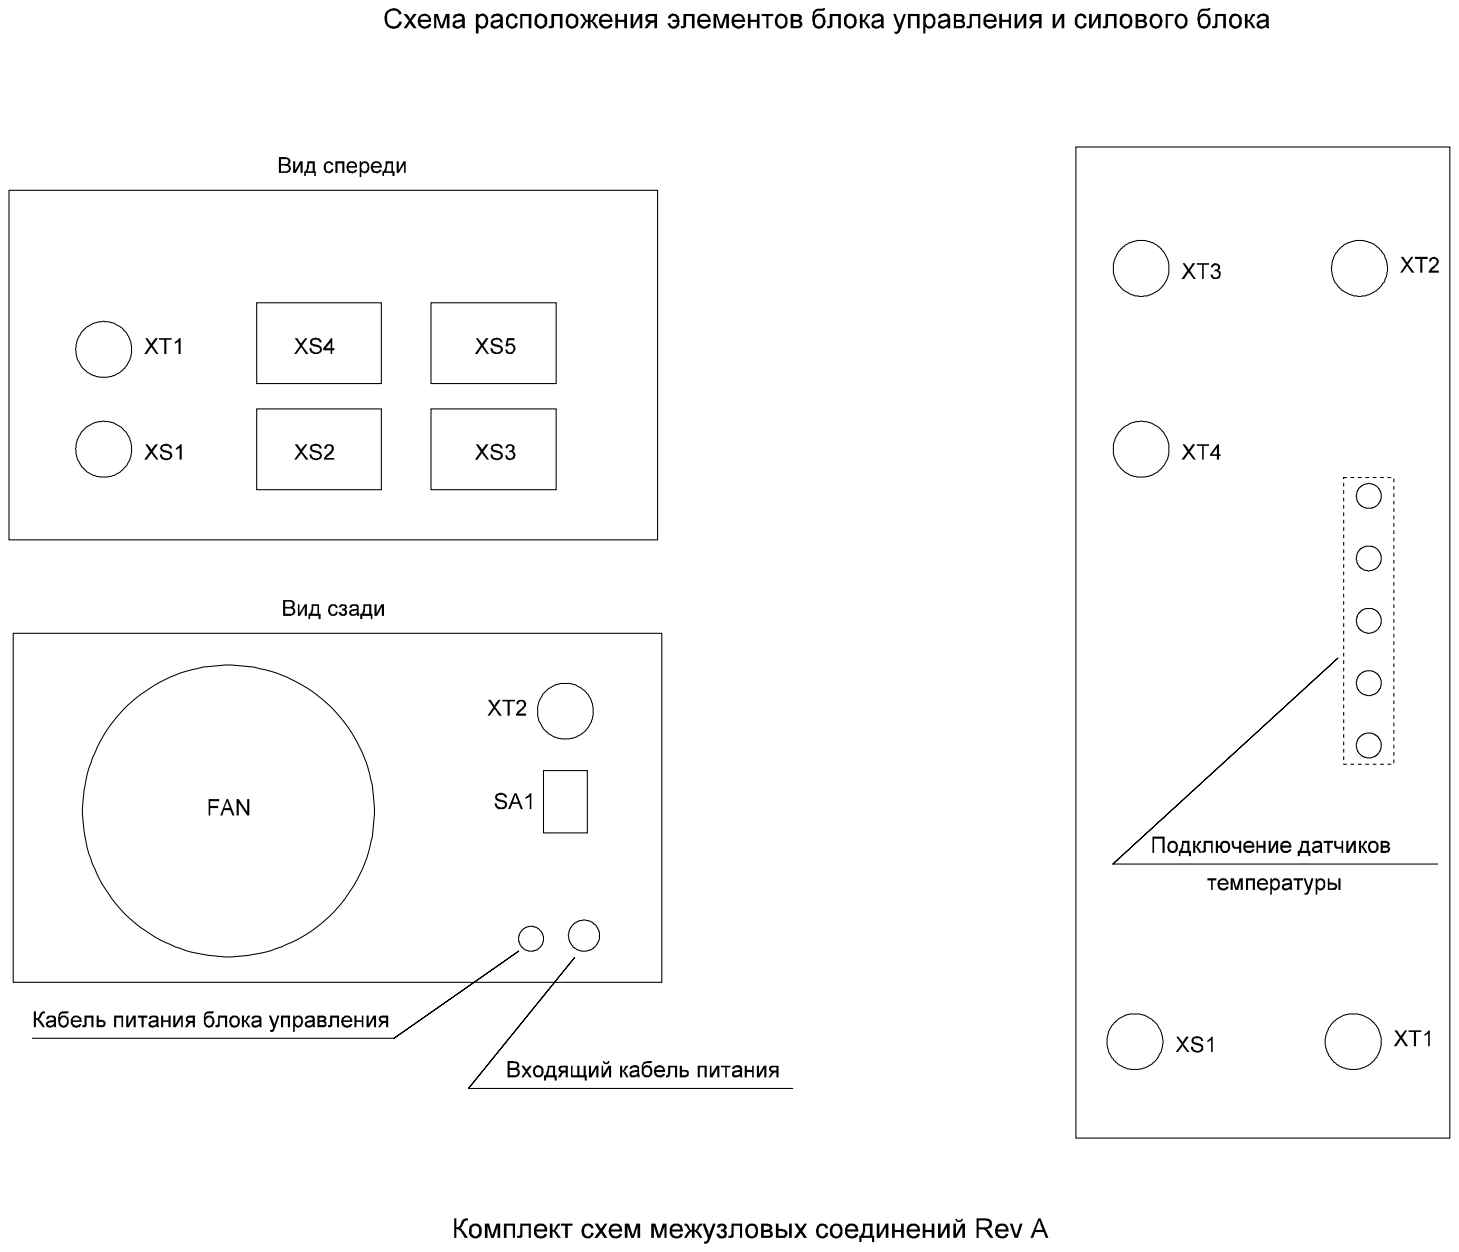
[picture p196: page 5]
