levichevdmitry/spirt_v2/(list of files, drawings)

Other design files:
control_module/hw/ControlModule/Control_CPUBoard_PCB.PcbDoc
control_module/hw/ControlModule/Control_PS_PCB.PcbDoc
control_module/hw/ControlModule/CPU_Board.PrjPCB
control_module/hw/ControlModule/CPUBoard_p1.SchDoc
control_module/hw/ControlModule/CPUBoard_p2.SchDoc
control_module/hw/ControlModule/CPUBoard_p3.SchDoc
control_module/hw/ControlModule/DistribValveBoard.PrjPCB
control_module/hw/ControlModule/DistribValveBrd.PcbDoc
control_module/hw/ControlModule/DistrValveBrd.SchDoc
control_module/hw/ControlModule/PowerSupply_Board.PrjPCB
control_module/hw/ControlModule/PS_Board_p1.SchDoc
control_module/hw/ControlModule/SensCon.PrjPCB
control_module/hw/ControlModule/SensorsConnectorBrd.PcbDoc
control_module/hw/ControlModule/SensorsConnectorBrd.SchDoc
general_hw/Connection_diagram.spl7
general_hw/Connection_diagram_rev_A.spl7
general_hw/Connection_diagram_rev_B.spl7
power_module/hw/PowerModule/ControlBoard.PrjPCB
power_module/hw/PowerModule/ControlBoard_p1.SchDoc
power_module/hw/PowerModule/ControlBoard_p2.SchDoc
power_module/hw/PowerModule/LedBoard.PrjPCB
power_module/hw/PowerModule/LedBoard.SchDoc
power_module/hw/PowerModule/LedBoard_PCB.PcbDoc
power_module/hw/PowerModule/PM_CPUBoard_pcb.PcbDoc
power_module/hw/PowerModule/PM_PowerBoard_PCB.PcbDoc
power_module/hw/PowerModule/PowerBoard.PrjPCB
power_module/hw/PowerModule/PowerBoard_p1.SchDoc
power_module/hw/PowerModule/PowerLib.PcbLib
power_module/hw/PowerModule/PowerLib.SchLib
structure/main_structure.spl7
structure/main_structure_v.2.spl7
structure/pid_structure.spl7
