levichevdmitry/spirt_v2/control_module/src/stm32/dialog_wnd/mainWnd.c

/*********************************************************************
*                                                                    *
*                SEGGER Microcontroller GmbH & Co. KG                *
*        Solutions for real time microcontroller applications        *
*                                                                    *
**********************************************************************
*                                                                    *
* C-file generated by:                                               *
*                                                                    *
*        GUI_Builder for emWin version 5.32                          *
*        Compiled Oct  8 2015, 11:59:02                              *
*        (c) 2015 Segger Microcontroller GmbH & Co. KG               *
*                                                                    *
**********************************************************************
*                                                                    *
*        Internet: www.segger.com  Support: support@segger.com       *
*                                                                    *
**********************************************************************
*/

// USER START (Optionally insert additional includes)
// USER END

//#include "DIALOG.h"
#include "windows.h"

/*********************************************************************
*
*       Defines
*
**********************************************************************
*/
#define ID_WINDOW_0  (GUI_ID_USER + 0x00)
#define ID_BUTTON_0  (GUI_ID_USER + 0x01)
#define ID_BUTTON_1  (GUI_ID_USER + 0x02)
#define ID_BUTTON_2  (GUI_ID_USER + 0x03)
#define ID_BUTTON_3  (GUI_ID_USER + 0x04)
#define ID_BUTTON_4  (GUI_ID_USER + 0x05)
#define ID_TEXT_0  (GUI_ID_USER + 0x06)
#define ID_TEXT_1  (GUI_ID_USER + 0x07)
#define ID_TIMER_CONVERT_MONITOR (GUI_ID_USER + 0x08)


// USER START (Optionally insert additional defines)
// USER END

/*********************************************************************
*
*       Static data
*
**********************************************************************
*/

// USER START (Optionally insert additional static data)
char buff_main[80];
// USER END

/*********************************************************************
*
*       _aDialogCreate
*/
static const GUI_WIDGET_CREATE_INFO _aDialogCreate[] = {
  { WINDOW_CreateIndirect, "Window", ID_WINDOW_0, 0, 1, 800, 480, 0, 0x0, 0 },
  { BUTTON_CreateIndirect, "Button", ID_BUTTON_0, 115, 320, 200, 100, 0, 0x0, 0 },
  { BUTTON_CreateIndirect, "Button", ID_BUTTON_1, 115, 56, 200, 100, 0, 0x0, 0 },
  { BUTTON_CreateIndirect, "Button", ID_BUTTON_2, 420, 56, 200, 100, 0, 0x0, 0 },
  { BUTTON_CreateIndirect, "Button", ID_BUTTON_3, 419, 320, 200, 100, 0, 0x0, 0 },
  { BUTTON_CreateIndirect, "Button", ID_BUTTON_4, 420, 187, 200, 100, 0, 0x0, 0 },
  { TEXT_CreateIndirect, "Text", ID_TEXT_0, 100, 440, 600, 30, 0, 0x64, 0 },
  { TEXT_CreateIndirect, "Text", ID_TEXT_1, 150, 10, 500, 30, 0, 0x64, 0 },
  // USER START (Optionally insert additional widgets)
  // USER END
};

/*********************************************************************
*
*       Static code
*
**********************************************************************
*/

// USER START (Optionally insert additional static code)
WM_HTIMER hTimerMain;
// USER END

/*********************************************************************
*
*       _cbDialog
*/
static void _cbDialog(WM_MESSAGE * pMsg) {
  WM_HWIN hItem;
  int     NCode;
  int     Id;
  // USER START (Optionally insert additional variables)
  // USER END

  switch (pMsg->MsgId) {
  case WM_INIT_DIALOG:
    //
    // Initialization of 'Window'
    //
    hItem = pMsg->hWin;
	  //WINDOW_SetBkColor(hItem, 0x00808080);
    WINDOW_SetBkColor(hItem,0x00C08000);
	
		hTimerMain = WM_CreateTimer(hItem, ID_TIMER_CONVERT_MONITOR, 100, 0);
		
    //
    // Initialization of 'Button'
    //
    hItem = WM_GetDialogItem(pMsg->hWin, ID_BUTTON_0);
    BUTTON_SetFont(hItem, &GUI_FontArial32);
    BUTTON_SetText(hItem, "Настройки");
    //
    // Initialization of 'Button'
    //
    hItem = WM_GetDialogItem(pMsg->hWin, ID_BUTTON_1);
    BUTTON_SetFont(hItem, &GUI_FontArial32);
    BUTTON_SetText(hItem, "Тестирование");
    //
    // Initialization of 'Button'
    //
    hItem = WM_GetDialogItem(pMsg->hWin, ID_BUTTON_2);
    BUTTON_SetFont(hItem, &GUI_FontArial32);
    BUTTON_SetText(hItem, "Пропарка");
    //
    // Initialization of 'Button'
    //
    hItem = WM_GetDialogItem(pMsg->hWin, ID_BUTTON_3);
    BUTTON_SetFont(hItem, &GUI_FontArial32);
    BUTTON_SetText(hItem, "Ректификация");
    //
    // Initialization of 'Button'
    //
    hItem = WM_GetDialogItem(pMsg->hWin, ID_BUTTON_4);
    BUTTON_SetFont(hItem, &GUI_FontArial32);
    BUTTON_SetText(hItem, "Дистилляция");
    //
    // Initialization of 'Text'
    //
    hItem = WM_GetDialogItem(pMsg->hWin, ID_TEXT_0);
    TEXT_SetText(hItem, "Разработано Nikopol (С)");
    TEXT_SetTextAlign(hItem, GUI_TA_HCENTER | GUI_TA_VCENTER);
    TEXT_SetTextColor(hItem, 0x00000000);
    TEXT_SetFont(hItem, &GUI_FontArial32);
    //
    // Initialization of 'Text'
    //
    hItem = WM_GetDialogItem(pMsg->hWin, ID_TEXT_1);
    TEXT_SetText(hItem, "Спиртовой контроллер v. 2.0 sv "SW_VERSION ); //SW_VERSION
    TEXT_SetTextAlign(hItem, GUI_TA_HCENTER | GUI_TA_VCENTER);
    TEXT_SetFont(hItem, &GUI_FontArial32);
    TEXT_SetTextColor(hItem, 0x00000000);
    // USER START (Optionally insert additional code for further widget initialization)
    // USER END
    break;
	
	case WM_TIMER:
		
			hItem = WM_GetDialogItem(pMsg->hWin, ID_TEXT_0);
			sprintf(buff_main, "Разработано Nikopol (С) %s", WifiGetIP());
			TEXT_SetText(hItem, buff_main);
	
			WM_RestartTimer(pMsg->Data.v, 250);
		break;
	
  case WM_NOTIFY_PARENT:
    Id    = WM_GetId(pMsg->hWinSrc);
    NCode = pMsg->Data.v;
    switch(Id) {
    case ID_BUTTON_0: // Notifications sent by 'Настройки'
      switch(NCode) {
      case WM_NOTIFICATION_CLICKED:
        // USER START (Optionally insert code for reacting on notification message)
					GUI_EndDialog ( pMsg->hWin, SCR_SETTINGS_SEL); // run settings dialog
        // USER END
        break;
      case WM_NOTIFICATION_RELEASED:
        // USER START (Optionally insert code for reacting on notification message)
        // USER END
        break;
      // USER START (Optionally insert additional code for further notification handling)
      // USER END
      }
      break;
    case ID_BUTTON_1: // Notifications sent by 'Тестирование'
      switch(NCode) {
      case WM_NOTIFICATION_CLICKED:
        // USER START (Optionally insert code for reacting on notification message)
				GUI_EndDialog ( pMsg->hWin, SCR_TEST_SEL); // run test dialog
        // USER END
        break;
      case WM_NOTIFICATION_RELEASED:
        // USER START (Optionally insert code for reacting on notification message)
        // USER END
        break;
      // USER START (Optionally insert additional code for further notification handling)
      // USER END
      }
      break;
    case ID_BUTTON_2: // Notifications sent by 'Чистка колоны'
      switch(NCode) {
      case WM_NOTIFICATION_CLICKED:
        // USER START (Optionally insert code for reacting on notification message)
				xSemaphoreGive(InitTempSen);
				SetSubMode(SMODE_CLR_HEATING);
				SetStateMode(MODE_RUN_CLS);
				
				GUI_EndDialog(pMsg->hWin, SCR_RUN_CLEAR);
				//BeeperOnDelay(2000);
        // USER END
        break;
      case WM_NOTIFICATION_RELEASED:
        // USER START (Optionally insert code for reacting on notification message)
        // USER END
        break;
      // USER START (Optionally insert additional code for further notification handling)
      // USER END
      }
      break;
    case ID_BUTTON_3: // Notifications sent by 'Ректификация'
      switch(NCode) {
      case WM_NOTIFICATION_CLICKED:
        // USER START (Optionally insert code for reacting on notification message)
				/*
				BeeperPulseDelay(100, 250, 2000);
				LoadDefSettings(); // for debug
				SaveSettings();
			*/
				SetStateMode(MODE_RUN_RECT);
				SetSubMode(SMODE_RECT_PREPARE);
				GUI_EndDialog(pMsg->hWin, SCR_RUN_RECT);
        // USER END
        break;
      case WM_NOTIFICATION_RELEASED:
        // USER START (Optionally insert code for reacting on notification message)
        // USER END
        break;
      // USER START (Optionally insert additional code for further notification handling)
      // USER END
      }
      break;
    case ID_BUTTON_4: // Notifications sent by 'Дистилляция'
      switch(NCode) {
      case WM_NOTIFICATION_CLICKED:
        // USER START (Optionally insert code for reacting on notification message)
				xSemaphoreGive(InitTempSen);
				SetStateMode(MODE_RUN_DIST);
				SetSubMode(SMODE_DIST_PREPARE);
				GUI_EndDialog(pMsg->hWin, SCR_RUN_DIS);
        // USER END
        break;
      case WM_NOTIFICATION_RELEASED:
        // USER START (Optionally insert code for reacting on notification message)
        // USER END
        break;
      // USER START (Optionally insert additional code for further notification handling)
      // USER END
      }
      break;
    // USER START (Optionally insert additional code for further Ids)
    // USER END
    }
    break;
  // USER START (Optionally insert additional message handling)
  // USER END
  default:
    WM_DefaultProc(pMsg);
    break;
  }
}

/*********************************************************************
*
*       Public code
*
**********************************************************************
*/
/*********************************************************************
*
*       CreateWindow
*/

WM_HWIN CreateMainWindow(void) {
  WM_HWIN hWin;

  hWin = GUI_CreateDialogBox(_aDialogCreate, GUI_COUNTOF(_aDialogCreate), _cbDialog, WM_HBKWIN, 0, 0);
  return hWin;
}

// USER START (Optionally insert additional public code)
// USER END

/*************************** End of file ****************************/
