levichevdmitry/spirt_v2/control_module/src/stm32/dialog_wnd/rectifSetWnd.c

/*********************************************************************
*                                                                    *
*                SEGGER Microcontroller GmbH & Co. KG                *
*        Solutions for real time microcontroller applications        *
*                                                                    *
**********************************************************************
*                                                                    *
* C-file generated by:                                               *
*                                                                    *
*        GUI_Builder for emWin version 5.32                          *
*        Compiled Oct  8 2015, 11:59:02                              *
*        (c) 2015 Segger Microcontroller GmbH & Co. KG               *
*                                                                    *
**********************************************************************
*                                                                    *
*        Internet: www.segger.com  Support: support@segger.com       *
*                                                                    *
**********************************************************************
*/

// USER START (Optionally insert additional includes)
// USER END

#include "windows.h"

/*********************************************************************
*
*       Defines
*
**********************************************************************
*/
#define ID_WINDOW_0    (GUI_ID_USER + 0x00)
#define ID_TEXT_0    (GUI_ID_USER + 0x01)
#define ID_TEXT_1    (GUI_ID_USER + 0x02)
#define ID_TEXT_2    (GUI_ID_USER + 0x03)
#define ID_TEXT_3    (GUI_ID_USER + 0x04)
#define ID_TEXT_4    (GUI_ID_USER + 0x05)
#define ID_TEXT_5    (GUI_ID_USER + 0x06)
#define ID_TEXT_6    (GUI_ID_USER + 0x07)
#define ID_TEXT_7    (GUI_ID_USER + 0x08)
#define ID_TEXT_8    (GUI_ID_USER + 0x09)
#define ID_TEXT_9    (GUI_ID_USER + 0x0A)
#define ID_TEXT_10    (GUI_ID_USER + 0x0B)
#define ID_TEXT_11    (GUI_ID_USER + 0x0C)
#define ID_TEXT_12    (GUI_ID_USER + 0x0D)
#define ID_SPINBOX_0    (GUI_ID_USER + 0x0F)
#define ID_SPINBOX_1    (GUI_ID_USER + 0x10)
#define ID_SPINBOX_2    (GUI_ID_USER + 0x11)
#define ID_SPINBOX_3    (GUI_ID_USER + 0x12)
#define ID_SPINBOX_4    (GUI_ID_USER + 0x13)
#define ID_SPINBOX_5    (GUI_ID_USER + 0x15)
#define ID_SPINBOX_6    (GUI_ID_USER + 0x16)
#define ID_SPINBOX_7    (GUI_ID_USER + 0x17)
#define ID_SPINBOX_8    (GUI_ID_USER + 0x18)
#define ID_SPINBOX_9    (GUI_ID_USER + 0x19)
#define ID_SPINBOX_10    (GUI_ID_USER + 0x1A)
#define ID_SPINBOX_11    (GUI_ID_USER + 0x1B)
#define ID_BUTTON_0    (GUI_ID_USER + 0x1D)
#define ID_CHECKBOX_0    (GUI_ID_USER + 0x1F)


// USER START (Optionally insert additional defines)
// USER END

/*********************************************************************
*
*       Static data
*
**********************************************************************
*/

// USER START (Optionally insert additional static data)
// USER END

/*********************************************************************
*
*       _aDialogCreate
*/
static const GUI_WIDGET_CREATE_INFO _aDialogCreate[] = {
  { WINDOW_CreateIndirect, "Window", ID_WINDOW_0, 0, 0, 800, 480, 0, 0x0, 0 },
  { TEXT_CreateIndirect, "Text", ID_TEXT_0, 180, 5, 450, 30, 0, 0x64, 0 },
  { TEXT_CreateIndirect, "Text", ID_TEXT_1, 5, 60, 275, 30, 0, 0x64, 0 },
  { TEXT_CreateIndirect, "Text", ID_TEXT_2, 5, 120, 275, 30, 0, 0x64, 0 },
  { TEXT_CreateIndirect, "Text", ID_TEXT_3, 5, 180, 275, 30, 0, 0x64, 0 },
  { TEXT_CreateIndirect, "Text", ID_TEXT_4, 5, 240, 275, 30, 0, 0x64, 0 },
  { TEXT_CreateIndirect, "Text", ID_TEXT_5, 5, 300, 275, 30, 0, 0x64, 0 },
  { TEXT_CreateIndirect, "Text", ID_TEXT_6, 5, 360, 275, 30, 0, 0x64, 0 },
  { TEXT_CreateIndirect, "Text", ID_TEXT_7, 405, 60, 275, 30, 0, 0x64, 0 },
  { TEXT_CreateIndirect, "Text", ID_TEXT_8, 405, 120, 275, 30, 0, 0x64, 0 },
  { TEXT_CreateIndirect, "Text", ID_TEXT_9, 405, 180, 275, 30, 0, 0x64, 0 },
  { TEXT_CreateIndirect, "Text", ID_TEXT_10, 405, 240, 275, 30, 0, 0x64, 0 },
  //{ TEXT_CreateIndirect, "Text", ID_TEXT_11, 405, 300, 275, 30, 0, 0x64, 0 },
  //{ TEXT_CreateIndirect, "Text", ID_TEXT_12, 405, 360, 275, 30, 0, 0x64, 0 },
  { SPINBOX_CreateIndirect, "Spinbox", ID_SPINBOX_0, 280, 50, 120, 50, 0, 0x0, 0 },
  { SPINBOX_CreateIndirect, "Spinbox", ID_SPINBOX_1, 280, 110, 120, 50, 0, 0x0, 0 },
  { SPINBOX_CreateIndirect, "Spinbox", ID_SPINBOX_2, 280, 170, 120, 50, 0, 0x0, 0 },
  { SPINBOX_CreateIndirect, "Spinbox", ID_SPINBOX_3, 280, 230, 120, 50, 0, 0x0, 0 },
  { SPINBOX_CreateIndirect, "Spinbox", ID_SPINBOX_4, 280, 290, 120, 50, 0, 0x0, 0 },
  { SPINBOX_CreateIndirect, "Spinbox", ID_SPINBOX_5, 280, 350, 120, 50, 0, 0x0, 0 },
  { SPINBOX_CreateIndirect, "Spinbox", ID_SPINBOX_6, 660, 50, 120, 50, 0, 0x0, 0 },
  { SPINBOX_CreateIndirect, "Spinbox", ID_SPINBOX_7, 660, 110, 120, 50, 0, 0x0, 0 },
  { SPINBOX_CreateIndirect, "Spinbox", ID_SPINBOX_8, 660, 170, 120, 50, 0, 0x0, 0 },
  { SPINBOX_CreateIndirect, "Spinbox", ID_SPINBOX_9, 660, 230, 120, 50, 0, 0x0, 0 },
 //{ SPINBOX_CreateIndirect, "Spinbox", ID_SPINBOX_10, 660, 290, 120, 50, 0, 0x0, 0 },
 //{ SPINBOX_CreateIndirect, "Spinbox", ID_SPINBOX_11, 660, 350, 120, 50, 0, 0x0, 0 },
  { BUTTON_CreateIndirect, "BackBtn", ID_BUTTON_0, 585, 365, 200, 100, 0, 0x0, 0 },
  { CHECKBOX_CreateIndirect, "Checkbox", ID_CHECKBOX_0, 17, 420, 509, 38, 0, 0x0, 0 },
  // USER START (Optionally insert additional widgets)
  // USER END
};

/*********************************************************************
*
*       Static code
*
**********************************************************************
*/

// USER START (Optionally insert additional static code)
// USER END

/*********************************************************************
*
*       _cbDialog
*/
static void _cbDialog(WM_MESSAGE * pMsg) {
  EDIT_Handle hEdit;
	WM_HWIN hItem;
  int     NCode;
  int     Id;
  // USER START (Optionally insert additional variables)
  // USER END

  switch (pMsg->MsgId) {
  case WM_INIT_DIALOG:
    //
    // Initialization of 'Window'
    //
    hItem = pMsg->hWin;
    WINDOW_SetBkColor(hItem, GUI_MAKE_COLOR(0x00C08000));
    //
    // Initialization of 'Text'
    //
    hItem = WM_GetDialogItem(pMsg->hWin, ID_TEXT_0);
    TEXT_SetTextAlign(hItem, GUI_TA_HCENTER | GUI_TA_VCENTER);
    TEXT_SetFont(hItem, &GUI_FontArial32);
    TEXT_SetText(hItem, "Параметры ректификации");
    //
    // Initialization of 'Text'
    //
    hItem = WM_GetDialogItem(pMsg->hWin, ID_TEXT_1);
    TEXT_SetFont(hItem, &GUI_FontArial32);
    TEXT_SetText(hItem, "Р ТЭН мин t>70, %");
    TEXT_SetTextAlign(hItem, GUI_TA_LEFT | GUI_TA_VCENTER);
    //
    // Initialization of 'Text'
    //
    hItem = WM_GetDialogItem(pMsg->hWin, ID_TEXT_2);
    TEXT_SetFont(hItem, &GUI_FontArial32);
    TEXT_SetTextAlign(hItem, GUI_TA_LEFT | GUI_TA_VCENTER);
    TEXT_SetText(hItem, "P куба, мм рт. ст");
    //
    // Initialization of 'Text'
    //
    hItem = WM_GetDialogItem(pMsg->hWin, ID_TEXT_3);
    TEXT_SetFont(hItem, &GUI_FontArial32);
    TEXT_SetTextAlign(hItem, GUI_TA_LEFT | GUI_TA_VCENTER);
    TEXT_SetText(hItem, "P прироста на гр., %");
    //
    // Initialization of 'Text'
    //
    hItem = WM_GetDialogItem(pMsg->hWin, ID_TEXT_4);
    TEXT_SetFont(hItem, &GUI_FontArial32);
    TEXT_SetTextAlign(hItem, GUI_TA_LEFT | GUI_TA_VCENTER);
    TEXT_SetText(hItem, "Дельта, С");
    //
    // Initialization of 'Text'
    //
    hItem = WM_GetDialogItem(pMsg->hWin, ID_TEXT_5);
    TEXT_SetFont(hItem, &GUI_FontArial32);
    TEXT_SetTextAlign(hItem, GUI_TA_LEFT | GUI_TA_VCENTER);
    TEXT_SetText(hItem, "T1 зад. кл., мин");
    //
    // Initialization of 'Text'
    //
    hItem = WM_GetDialogItem(pMsg->hWin, ID_TEXT_6);
    TEXT_SetTextAlign(hItem, GUI_TA_LEFT | GUI_TA_VCENTER);
    TEXT_SetFont(hItem, &GUI_FontArial32);
    TEXT_SetText(hItem, "T2 зад. кл., мин");
    //
    // Initialization of 'Text'
    //
    hItem = WM_GetDialogItem(pMsg->hWin, ID_TEXT_7);
    TEXT_SetFont(hItem, &GUI_FontArial32);
    TEXT_SetText(hItem, "t С/С, С");
    TEXT_SetTextAlign(hItem, GUI_TA_LEFT | GUI_TA_VCENTER);
    //
    // Initialization of 'Text'
    //
    hItem = WM_GetDialogItem(pMsg->hWin, ID_TEXT_8);
    TEXT_SetFont(hItem, &GUI_FontArial32);
    TEXT_SetText(hItem, "Объем гол., мл");
    TEXT_SetTextAlign(hItem, GUI_TA_LEFT | GUI_TA_VCENTER);
    //
    // Initialization of 'Text'
    //
    hItem = WM_GetDialogItem(pMsg->hWin, ID_TEXT_9);
    TEXT_SetFont(hItem, &GUI_FontArial32);
    TEXT_SetText(hItem, "Объем подгол., мл");
    TEXT_SetTextAlign(hItem, GUI_TA_LEFT | GUI_TA_VCENTER);
    //
    // Initialization of 'Text'
    //
    hItem = WM_GetDialogItem(pMsg->hWin, ID_TEXT_10);
    TEXT_SetFont(hItem, &GUI_FontArial32);
    TEXT_SetText(hItem, "Скорость отб., мл/ч");
    TEXT_SetTextAlign(hItem, GUI_TA_LEFT | GUI_TA_VCENTER);
    //
    // Initialization of 'Text'
    //
    hItem = WM_GetDialogItem(pMsg->hWin, ID_TEXT_11);
    TEXT_SetFont(hItem, &GUI_FontArial32);
    TEXT_SetText(hItem, "Text");
    TEXT_SetTextAlign(hItem, GUI_TA_LEFT | GUI_TA_VCENTER);
    //
    // Initialization of 'Text'
    //
    hItem = WM_GetDialogItem(pMsg->hWin, ID_TEXT_12);
    TEXT_SetFont(hItem, &GUI_FontArial32);
    TEXT_SetText(hItem, "Text");
    TEXT_SetTextAlign(hItem, GUI_TA_LEFT | GUI_TA_VCENTER);
    //
    // Initialization of 'P TEN min'
    //
    hItem = WM_GetDialogItem(pMsg->hWin, ID_SPINBOX_0);
    SPINBOX_SetFont(hItem, &GUI_FontArial32);
		SPINBOX_SetStep(hItem, 5);
		hEdit = SPINBOX_GetEditHandle(hItem);
		EDIT_SetTextAlign(hEdit, GUI_TA_VCENTER);
		EDIT_SetDecMode(hEdit, Settings.rect_set.pow_heater.value, Settings.rect_set.pow_heater.min_val, Settings.rect_set.pow_heater.max_val, 1, GUI_EDIT_SUPPRESS_LEADING_ZEROES);
    //
    // Initialization of 'p kolona'
    //
    hItem = WM_GetDialogItem(pMsg->hWin, ID_SPINBOX_1);
    SPINBOX_SetFont(hItem, &GUI_FontArial32);
		hEdit = SPINBOX_GetEditHandle(hItem);
		EDIT_SetTextAlign(hEdit, GUI_TA_VCENTER);
		EDIT_SetDecMode(hEdit, Settings.rect_set.p_kub.value, Settings.rect_set.p_kub.min_val, Settings.rect_set.p_kub.max_val, 0, GUI_EDIT_SUPPRESS_LEADING_ZEROES);
    //
    // Initialization of 'P add'
    //
    hItem = WM_GetDialogItem(pMsg->hWin, ID_SPINBOX_2);
    SPINBOX_SetFont(hItem, &GUI_FontArial32);
		hEdit = SPINBOX_GetEditHandle(hItem);
		EDIT_SetTextAlign(hEdit, GUI_TA_VCENTER);
		EDIT_SetDecMode(hEdit, Settings.rect_set.pow_svitek.value, Settings.rect_set.pow_svitek.min_val, Settings.rect_set.pow_svitek.max_val, 0, GUI_EDIT_SUPPRESS_LEADING_ZEROES);
    //
    // Initialization of 'dt'
    //
    hItem = WM_GetDialogItem(pMsg->hWin, ID_SPINBOX_3);
    SPINBOX_SetFont(hItem, &GUI_FontArial32);
		hEdit = SPINBOX_GetEditHandle(hItem);
		EDIT_SetTextAlign(hEdit, GUI_TA_VCENTER);
		EDIT_SetFloatMode(hEdit, Settings.rect_set.dt.value, Settings.rect_set.dt.min_val, Settings.rect_set.dt.max_val, 2, GUI_EDIT_SUPPRESS_LEADING_ZEROES);
    
    //
    // Initialization of 'T1'
    //
    hItem = WM_GetDialogItem(pMsg->hWin, ID_SPINBOX_4);
    SPINBOX_SetFont(hItem, &GUI_FontArial32);
		hEdit = SPINBOX_GetEditHandle(hItem);
		EDIT_SetTextAlign(hEdit, GUI_TA_VCENTER);
		EDIT_SetDecMode(hEdit, Settings.rect_set.T1.value, Settings.rect_set.T1.min_val, Settings.rect_set.T1.max_val, 0, GUI_EDIT_SUPPRESS_LEADING_ZEROES);
    //
    // Initialization of 'T2'
    //
    hItem = WM_GetDialogItem(pMsg->hWin, ID_SPINBOX_5);
    SPINBOX_SetFont(hItem, &GUI_FontArial32);
		hEdit = SPINBOX_GetEditHandle(hItem);
		EDIT_SetTextAlign(hEdit, GUI_TA_VCENTER);
		EDIT_SetDecMode(hEdit, Settings.rect_set.T2.value, Settings.rect_set.T2.min_val, Settings.rect_set.T2.max_val, 0, GUI_EDIT_SUPPRESS_LEADING_ZEROES);
    //
    // Initialization of 't_ss'
    //
    hItem = WM_GetDialogItem(pMsg->hWin, ID_SPINBOX_6);
    SPINBOX_SetFont(hItem, &GUI_FontArial32);
		hEdit = SPINBOX_GetEditHandle(hItem);
		EDIT_SetTextAlign(hEdit, GUI_TA_VCENTER);
		EDIT_SetDecMode(hEdit, Settings.rect_set.t_kub_ss.value, Settings.rect_set.t_kub_ss.min_val, Settings.rect_set.t_kub_ss.max_val, 0, GUI_EDIT_SUPPRESS_LEADING_ZEROES);
    //
    // Initialization of 'Q_head'
    //
    hItem = WM_GetDialogItem(pMsg->hWin, ID_SPINBOX_7);
    SPINBOX_SetFont(hItem, &GUI_FontArial32);
		hEdit = SPINBOX_GetEditHandle(hItem);
		EDIT_SetTextAlign(hEdit, GUI_TA_VCENTER);
		EDIT_SetDecMode(hEdit, Settings.rect_set.Q_head.value, Settings.rect_set.Q_head.min_val, Settings.rect_set.Q_head.max_val, 0, GUI_EDIT_SUPPRESS_LEADING_ZEROES);
    //
    // Initialization of 'Q_subHead'
    //
    hItem = WM_GetDialogItem(pMsg->hWin, ID_SPINBOX_8);
    SPINBOX_SetFont(hItem, &GUI_FontArial32);
		hEdit = SPINBOX_GetEditHandle(hItem);
		EDIT_SetTextAlign(hEdit, GUI_TA_VCENTER);
		EDIT_SetDecMode(hEdit, Settings.rect_set.Q_sub_head.value, Settings.rect_set.Q_sub_head.min_val, Settings.rect_set.Q_sub_head.max_val, 0, GUI_EDIT_SUPPRESS_LEADING_ZEROES);
    //
    // Initialization of 'V_get'
    //
    hItem = WM_GetDialogItem(pMsg->hWin, ID_SPINBOX_9);
    SPINBOX_SetFont(hItem, &GUI_FontArial32);
		hEdit = SPINBOX_GetEditHandle(hItem);
		EDIT_SetTextAlign(hEdit, GUI_TA_VCENTER);
		EDIT_SetDecMode(hEdit, Settings.rect_set.V_get.value, Settings.rect_set.V_get.min_val, Settings.rect_set.V_get.max_val, 0, GUI_EDIT_SUPPRESS_LEADING_ZEROES);
		/*
    //
    // Initialization of 'Spinbox'
    //
    hItem = WM_GetDialogItem(pMsg->hWin, ID_SPINBOX_10);
    SPINBOX_SetFont(hItem, &GUI_FontArial32);
    
		//
    // Initialization of 'Spinbox'
    //
    hItem = WM_GetDialogItem(pMsg->hWin, ID_SPINBOX_11);
    SPINBOX_SetFont(hItem, &GUI_FontArial32);
		*/
    //
    // Initialization of 'BackBtn'
    //
    hItem = WM_GetDialogItem(pMsg->hWin, ID_BUTTON_0);
    BUTTON_SetFont(hItem, &GUI_FontArial32);
    BUTTON_SetText(hItem, "Применить");
    //
    // Initialization of 'Checkbox'
    //
    hItem = WM_GetDialogItem(pMsg->hWin, ID_CHECKBOX_0);
    CHECKBOX_SetText(hItem, "Стабилизация по давлению");
    CHECKBOX_SetFont(hItem, &GUI_FontArial32);
		CHECKBOX_SetState(hItem, Settings.rect_set.mode.value);
		
    // USER START (Optionally insert additional code for further widget initialization)
    // USER END
    break;
  case WM_NOTIFY_PARENT:
    Id    = WM_GetId(pMsg->hWinSrc);
    NCode = pMsg->Data.v;
    switch(Id) {
    case ID_SPINBOX_0: // Notifications sent by 'P TEN'
      switch(NCode) {
      case WM_NOTIFICATION_CLICKED:
        // USER START (Optionally insert code for reacting on notification message)
        // USER END
        break;
      case WM_NOTIFICATION_RELEASED:
        // USER START (Optionally insert code for reacting on notification message)
        // USER END
        break;
      case WM_NOTIFICATION_MOVED_OUT:
        // USER START (Optionally insert code for reacting on notification message)
        // USER END
        break;
      case WM_NOTIFICATION_VALUE_CHANGED:
        // USER START (Optionally insert code for reacting on notification message)
				hItem = WM_GetDialogItem(pMsg->hWin, ID_SPINBOX_0);
				Settings.rect_set.pow_heater.value = SPINBOX_GetValue(hItem);
        // USER END
        break;
      // USER START (Optionally insert additional code for further notification handling)
      // USER END
      }
      break;
    case ID_SPINBOX_1: // Notifications sent by 'p kuba'
      switch(NCode) {
      case WM_NOTIFICATION_CLICKED:
        // USER START (Optionally insert code for reacting on notification message)
        // USER END
        break;
      case WM_NOTIFICATION_RELEASED:
        // USER START (Optionally insert code for reacting on notification message)
        // USER END
        break;
      case WM_NOTIFICATION_MOVED_OUT:
        // USER START (Optionally insert code for reacting on notification message)
        // USER END
        break;
      case WM_NOTIFICATION_VALUE_CHANGED:
        // USER START (Optionally insert code for reacting on notification message)
				hItem = WM_GetDialogItem(pMsg->hWin, ID_SPINBOX_1);
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
      // USER END
      }
      break;
    case ID_CHECKBOX_0: // Notifications sent by 'Checkbox'
      switch(NCode) {
      case WM_NOTIFICATION_CLICKED:
        // USER START (Optionally insert code for reacting on notification message)
        // USER END
        break;
      case WM_NOTIFICATION_RELEASED:
        // USER START (Optionally insert code for reacting on notification message)
        // USER END
        break;
      case WM_NOTIFICATION_VALUE_CHANGED:
        // USER START (Optionally insert code for reacting on notification message)
				hItem = WM_GetDialogItem(pMsg->hWin, ID_CHECKBOX_0);
				Settings.rect_set.mode.value = CHECKBOX_GetState(hItem);
        // USER END
        break;
      // USER START (Optionally insert additional code for further notification handling)
      // USER END
      }
      break;
    // USER START (Optionally insert additional code for further Ids)
    // USER END
    }
    break;
  // USER START (Optionally insert additional message handling)
  // USER END
  default:
    WM_DefaultProc(pMsg);
    break;
  }
}

/*********************************************************************
*
*       Public code
*
**********************************************************************
*/
/*********************************************************************
*
*       CreateWindow
*/

WM_HWIN CreateRectSetWnd(void) {
  WM_HWIN hWin;

  hWin = GUI_CreateDialogBox(_aDialogCreate, GUI_COUNTOF(_aDialogCreate), _cbDialog, WM_HBKWIN, 0, 0);
  return hWin;
}

// USER START (Optionally insert additional public code)
// USER END

/*************************** End of file ****************************/
