levichevdmitry/spirt_v2/control_module/src/stm32/dialog_wnd/settingsTempWnd.c

/*********************************************************************
*                                                                    *
*                SEGGER Microcontroller GmbH & Co. KG                *
*        Solutions for real time microcontroller applications        *
*                                                                    *
**********************************************************************
*                                                                    *
* C-file generated by:                                               *
*                                                                    *
*        GUI_Builder for emWin version 5.32                          *
*        Compiled Oct  8 2015, 11:59:02                              *
*        (c) 2015 Segger Microcontroller GmbH & Co. KG               *
*                                                                    *
**********************************************************************
*                                                                    *
*        Internet: www.segger.com  Support: support@segger.com       *
*                                                                    *
**********************************************************************
*/

// USER START (Optionally insert additional includes)
// USER END

#include "windows.h"

/*********************************************************************
*
*       Defines
*
**********************************************************************
*/
#define ID_WINDOW_0  (GUI_ID_USER + 0x00)
#define ID_TEXT_0  (GUI_ID_USER + 0x01)
#define ID_TEXT_1  (GUI_ID_USER + 0x02)
#define ID_TEXT_2  (GUI_ID_USER + 0x03)
#define ID_TEXT_3  (GUI_ID_USER + 0x04)
#define ID_TEXT_4  (GUI_ID_USER + 0x05)
#define ID_TEXT_5  (GUI_ID_USER + 0x06)
#define ID_TEXT_6  (GUI_ID_USER + 0x07)
#define ID_EDIT_0  (GUI_ID_USER + 0x08)
#define ID_EDIT_1  (GUI_ID_USER + 0x09)
#define ID_EDIT_2  (GUI_ID_USER + 0x0A)
#define ID_EDIT_3  (GUI_ID_USER + 0x0B)
#define ID_EDIT_4  (GUI_ID_USER + 0x0C)
#define ID_EDIT_5  (GUI_ID_USER + 0x0D)
#define ID_BUTTON_0  (GUI_ID_USER + 0x0E)
#define ID_BUTTON_1  (GUI_ID_USER + 0x0F)
#define ID_BUTTON_2  (GUI_ID_USER + 0x10)
#define ID_BUTTON_3  (GUI_ID_USER + 0x11)
#define ID_BUTTON_4  (GUI_ID_USER + 0x12)
#define ID_BUTTON_5  (GUI_ID_USER + 0x13)
#define ID_TEXT_7  (GUI_ID_USER + 0x14)
#define ID_TIMER_CONVERT_MONITOR (GUI_ID_USER + 0x15)


// USER START (Optionally insert additional defines)
// USER END

/*********************************************************************
*
*       Static data
*
**********************************************************************
*/

// USER START (Optionally insert additional static data)
// USER END

/*********************************************************************
*
*       _aDialogCreate
*/
static const GUI_WIDGET_CREATE_INFO _aDialogCreate[] = {
  { WINDOW_CreateIndirect, "Window", ID_WINDOW_0, 0, 0, 800, 480, 0, 0x0, 0 },
  { TEXT_CreateIndirect, "Text", ID_TEXT_0, 180, 10, 440, 30, 0, 0x64, 0 },
  { TEXT_CreateIndirect, "Text", ID_TEXT_1, 5, 50, 80, 30, 0, 0x64, 0 },
  { TEXT_CreateIndirect, "Text", ID_TEXT_2, 5, 90, 140, 30, 0, 0x64, 0 },
  { TEXT_CreateIndirect, "Text", ID_TEXT_3, 5, 210, 175, 30, 0, 0x64, 0 },
  { TEXT_CreateIndirect, "Text", ID_TEXT_4, 5, 280, 175, 30, 0, 0x64, 0 },
  { TEXT_CreateIndirect, "Text", ID_TEXT_5, 5, 350, 175, 30, 0, 0x64, 0 },
  //{ TEXT_CreateIndirect, "Text", ID_TEXT_6, 5, 420, 180, 30, 0, 0x64, 0 },
  { EDIT_CreateIndirect, "Edit", ID_EDIT_0, 185, 50, 244, 30, 0, 0x64, 0 },
  { EDIT_CreateIndirect, "Edit", ID_EDIT_1, 185, 90, 80, 30, 0, 0x64, 0 },
  { EDIT_CreateIndirect, "Edit", ID_EDIT_2, 185, 210, 244, 30, 0, 0x64, 0 },
  { EDIT_CreateIndirect, "Edit", ID_EDIT_3, 185, 280, 244, 30, 0, 0x64, 0 },
  { EDIT_CreateIndirect, "Edit", ID_EDIT_4, 185, 350, 244, 30, 0, 0x64, 0 },
  //{ EDIT_CreateIndirect, "Edit", ID_EDIT_5, 185, 420, 244, 30, 0, 0x64, 0 },
  { BUTTON_CreateIndirect, "Button", ID_BUTTON_0, 440, 50, 190, 80, 0, 0x0, 0 },
  { BUTTON_CreateIndirect, "Button", ID_BUTTON_1, 440, 200, 190, 50, 0, 0x0, 0 },
  { BUTTON_CreateIndirect, "Button", ID_BUTTON_2, 440, 270, 190, 50, 0, 0x0, 0 },
  { BUTTON_CreateIndirect, "Button", ID_BUTTON_3, 440, 340, 190, 50, 0, 0x0, 0 },
  //{ BUTTON_CreateIndirect, "Button", ID_BUTTON_4, 440, 410, 190, 50, 0, 0x0, 0 },
  { BUTTON_CreateIndirect, "Button", ID_BUTTON_5, 640, 410, 150, 50, 0, 0x0, 0 },
  { TEXT_CreateIndirect, "Text", ID_TEXT_7, 270, 90, 20, 25, 0, 0x64, 0 },
  // USER START (Optionally insert additional widgets)
  // USER END
};

/*********************************************************************
*
*       Static code
*
**********************************************************************
*/

// USER START (Optionally insert additional static code)
WM_HTIMER hTimerSenTemp;
// USER END

/*********************************************************************
*
*       _cbDialog
*/
static void _cbDialog(WM_MESSAGE * pMsg) {
  WM_HWIN hItem;
  int     NCode;
  int     Id;
	char buff[17];
  // USER START (Optionally insert additional variables)
  // USER END

  switch (pMsg->MsgId) {
  case WM_INIT_DIALOG:
    //
    // Initialization of 'Window'
    //
    hItem = pMsg->hWin;
    WINDOW_SetBkColor(hItem, GUI_MAKE_COLOR(0x00C08000));
	
		hTimerSenTemp = WM_CreateTimer(hItem, ID_TIMER_CONVERT_MONITOR, 250, 0);
    //
    // Initialization of 'Text'
    //
    hItem = WM_GetDialogItem(pMsg->hWin, ID_TEXT_0);
    TEXT_SetTextAlign(hItem, GUI_TA_HCENTER | GUI_TA_VCENTER);
    TEXT_SetFont(hItem, &GUI_FontArial32);
    TEXT_SetText(hItem, "Настройка датчиков температуры");
    //
    // Initialization of 'Text'
    //
    hItem = WM_GetDialogItem(pMsg->hWin, ID_TEXT_1);
    TEXT_SetTextAlign(hItem, GUI_TA_LEFT | GUI_TA_VCENTER);
    TEXT_SetFont(hItem, &GUI_FontArial32);
		TEXT_SetText(hItem, "ID:");
    //
    // Initialization of 'Text'
    //
    hItem = WM_GetDialogItem(pMsg->hWin, ID_TEXT_2);
    TEXT_SetTextAlign(hItem, GUI_TA_LEFT | GUI_TA_VCENTER);
    TEXT_SetText(hItem, "Значение:");
    TEXT_SetFont(hItem, &GUI_FontArial32);
    //
    // Initialization of 'Text'
    //
    hItem = WM_GetDialogItem(pMsg->hWin, ID_TEXT_3);
    TEXT_SetTextAlign(hItem, GUI_TA_LEFT | GUI_TA_VCENTER);
    TEXT_SetText(hItem, "Куб:");
    TEXT_SetFont(hItem, &GUI_FontArial32);
    //
    // Initialization of 'Text'
    //
    hItem = WM_GetDialogItem(pMsg->hWin, ID_TEXT_4);
    TEXT_SetTextAlign(hItem, GUI_TA_LEFT | GUI_TA_VCENTER);
    TEXT_SetText(hItem, "Колона низ:");
    TEXT_SetFont(hItem, &GUI_FontArial32);
    //
    // Initialization of 'Text'
    //
    hItem = WM_GetDialogItem(pMsg->hWin, ID_TEXT_5);
    TEXT_SetTextAlign(hItem, GUI_TA_LEFT | GUI_TA_VCENTER);
    TEXT_SetText(hItem, "Колона верх:");
    TEXT_SetFont(hItem, &GUI_FontArial32);
    //
    // Initialization of 'Text'
    //
		/*
    hItem = WM_GetDialogItem(pMsg->hWin, ID_TEXT_6);
    TEXT_SetTextAlign(hItem, GUI_TA_LEFT | GUI_TA_VCENTER);
    TEXT_SetText(hItem, "Дефлегматор:");
    TEXT_SetFont(hItem, &GUI_FontArial32);
		*/
    //
    // Initialization of 'Edit'
    //
    hItem = WM_GetDialogItem(pMsg->hWin, ID_EDIT_0);
    EDIT_SetText(hItem, "1234567890123456");
    EDIT_SetTextAlign(hItem, GUI_TA_HCENTER | GUI_TA_VCENTER);
    EDIT_SetFont(hItem, &GUI_FontArial32);
    //
    // Initialization of 'Edit'
    //
    hItem = WM_GetDialogItem(pMsg->hWin, ID_EDIT_1);
    //EDIT_SetText(hItem, "12.3");
		EDIT_SetFloatMode(hItem, Sensors.t_kub, 0.0, 100.0, 1, GUI_EDIT_SUPPRESS_LEADING_ZEROES);
    EDIT_SetTextAlign(hItem, GUI_TA_HCENTER | GUI_TA_VCENTER);
    EDIT_SetFont(hItem, &GUI_FontArial32);
    //
    // Initialization of 'Edit'
    //
    hItem = WM_GetDialogItem(pMsg->hWin, ID_EDIT_2);
    EDIT_SetText(hItem, "1234567890123456");
    EDIT_SetTextAlign(hItem, GUI_TA_HCENTER | GUI_TA_VCENTER);
    EDIT_SetFont(hItem, &GUI_FontArial32);
    //
    // Initialization of 'Edit'
    //
    hItem = WM_GetDialogItem(pMsg->hWin, ID_EDIT_3);
    EDIT_SetText(hItem, "1234567890123456");
    EDIT_SetTextAlign(hItem, GUI_TA_HCENTER | GUI_TA_VCENTER);
    EDIT_SetFont(hItem, &GUI_FontArial32);
    //
    // Initialization of 'Edit'
    //
    hItem = WM_GetDialogItem(pMsg->hWin, ID_EDIT_4);
    EDIT_SetText(hItem, "1234567890123456");
    EDIT_SetTextAlign(hItem, GUI_TA_HCENTER | GUI_TA_VCENTER);
    EDIT_SetFont(hItem, &GUI_FontArial32);
    //
    // Initialization of 'Edit'
    //
		/*
    hItem = WM_GetDialogItem(pMsg->hWin, ID_EDIT_5);
    EDIT_SetText(hItem, "1234567890123456");
    EDIT_SetTextAlign(hItem, GUI_TA_HCENTER | GUI_TA_VCENTER);
    EDIT_SetFont(hItem, &GUI_FontArial32);
		*/
    //
    // Initialization of 'Search sen'
    //
    hItem = WM_GetDialogItem(pMsg->hWin, ID_BUTTON_0);
    BUTTON_SetFont(hItem, &GUI_FontArial32);
    BUTTON_SetText(hItem, "Обновить");
    //
    // Initialization of 'Set kub ID'
    //
    hItem = WM_GetDialogItem(pMsg->hWin, ID_BUTTON_1);
    BUTTON_SetFont(hItem, &GUI_FontArial32);
    BUTTON_SetText(hItem, "Уст. куб");
    //
    // Initialization of 'Set kol.n. ID'
    //
    hItem = WM_GetDialogItem(pMsg->hWin, ID_BUTTON_2);
    BUTTON_SetFont(hItem, &GUI_FontArial32);
    BUTTON_SetText(hItem, "Уст. кол. низ");
    //
    // Initialization of 'Set kol.v. ID'
    //
    hItem = WM_GetDialogItem(pMsg->hWin, ID_BUTTON_3);
    BUTTON_SetFont(hItem, &GUI_FontArial32);
    BUTTON_SetText(hItem, "Уст. кол. верх");
    //
    // Initialization of 'Set defleg.'
    //
		/*
    hItem = WM_GetDialogItem(pMsg->hWin, ID_BUTTON_4);
    BUTTON_SetFont(hItem, &GUI_FontArial32);
    BUTTON_SetText(hItem, "Уст. деф-ор");
		*/
    //
    // Initialization of 'Back'
    //
    hItem = WM_GetDialogItem(pMsg->hWin, ID_BUTTON_5);
    BUTTON_SetFont(hItem, &GUI_FontArial32);
    BUTTON_SetText(hItem, "Применить");
    //
    // Initialization of 'Text'
    //
    hItem = WM_GetDialogItem(pMsg->hWin, ID_TEXT_7);
    TEXT_SetTextAlign(hItem, GUI_TA_HCENTER | GUI_TA_VCENTER);
    TEXT_SetFont(hItem, &GUI_FontArial32);
    TEXT_SetText(hItem, "C");
    // USER START (Optionally insert additional code for further widget initialization)
    // USER END
    break;
	
	case WM_TIMER:
				
				hItem = WM_GetDialogItem(pMsg->hWin, ID_EDIT_0);
				OneWireIdToStr(buff, &devices[0]);
				EDIT_SetText(hItem, buff);
	
				hItem = WM_GetDialogItem(pMsg->hWin, ID_EDIT_1); 
				EDIT_SetFloatValue(hItem, Sensors.t_kub);
	
	
				hItem = WM_GetDialogItem(pMsg->hWin, ID_EDIT_2);
				OneWireIdToStr(buff, &Settings.id_t_kub);
				EDIT_SetText(hItem, buff);
				if (OneWireIdEq(&Settings.id_t_kub, &devices[0])) {
					EDIT_SetBkColor(hItem, EDIT_CI_ENABLED, GUI_GREEN);
				} else {
					EDIT_SetBkColor(hItem, EDIT_CI_ENABLED, EDIT_GetDefaultBkColor(EDIT_CI_ENABLED));
				}
	
				hItem = WM_GetDialogItem(pMsg->hWin, ID_EDIT_3);
				OneWireIdToStr(buff, &Settings.id_t_kolona_n);
				EDIT_SetText(hItem, buff);
				if (OneWireIdEq(&Settings.id_t_kolona_n, &devices[0])) {
					EDIT_SetBkColor(hItem, EDIT_CI_ENABLED, GUI_GREEN);
				} else {
					EDIT_SetBkColor(hItem, EDIT_CI_ENABLED, EDIT_GetDefaultBkColor(EDIT_CI_ENABLED));
				}
	
				hItem = WM_GetDialogItem(pMsg->hWin, ID_EDIT_4);
				OneWireIdToStr(buff, &Settings.id_t_kolona_v);
				EDIT_SetText(hItem, buff);
				if (OneWireIdEq(&Settings.id_t_kolona_v, &devices[0])) {
					EDIT_SetBkColor(hItem, EDIT_CI_ENABLED, GUI_GREEN);
				} else {
					EDIT_SetBkColor(hItem, EDIT_CI_ENABLED, EDIT_GetDefaultBkColor(EDIT_CI_ENABLED));
				}
				/*
				hItem = WM_GetDialogItem(pMsg->hWin, ID_EDIT_5);
				OneWireIdToStr(buff, &Settings.id_t_after_def);
				EDIT_SetText(hItem, buff);
				if (OneWireIdEq(&Settings.id_t_after_def, &devices[0])) {
					EDIT_SetBkColor(hItem, EDIT_CI_ENABLED, GUI_GREEN);
				} else {
					EDIT_SetBkColor(hItem, EDIT_CI_ENABLED, EDIT_GetDefaultBkColor(EDIT_CI_ENABLED));
				}
		*/
				WM_RestartTimer(pMsg->Data.v, 250);
			break;
		
  case WM_NOTIFY_PARENT:
    Id    = WM_GetId(pMsg->hWinSrc);
    NCode = pMsg->Data.v;
    switch(Id) {
    case ID_EDIT_0: // Notifications sent by 'Edit'
      switch(NCode) {
      case WM_NOTIFICATION_CLICKED:
        // USER START (Optionally insert code for reacting on notification message)
        // USER END
        break;
      case WM_NOTIFICATION_RELEASED:
        // USER START (Optionally insert code for reacting on notification message)
        // USER END
        break;
      case WM_NOTIFICATION_VALUE_CHANGED:
        // USER START (Optionally insert code for reacting on notification message)
        // USER END
        break;
      // USER START (Optionally insert additional code for further notification handling)
      // USER END
      }
      break;
    case ID_EDIT_1: // Notifications sent by 'Edit'
      switch(NCode) {
      case WM_NOTIFICATION_CLICKED:
        // USER START (Optionally insert code for reacting on notification message)
        // USER END
        break;
      case WM_NOTIFICATION_RELEASED:
        // USER START (Optionally insert code for reacting on notification message)
        // USER END
        break;
      case WM_NOTIFICATION_VALUE_CHANGED:
        // USER START (Optionally insert code for reacting on notification message)
        // USER END
        break;
      // USER START (Optionally insert additional code for further notification handling)
      // USER END
      }
      break;
    case ID_EDIT_2: // Notifications sent by 'Edit'
      switch(NCode) {
      case WM_NOTIFICATION_CLICKED:
        // USER START (Optionally insert code for reacting on notification message)
        // USER END
        break;
      case WM_NOTIFICATION_RELEASED:
        // USER START (Optionally insert code for reacting on notification message)
        // USER END
        break;
      case WM_NOTIFICATION_VALUE_CHANGED:
        // USER START (Optionally insert code for reacting on notification message)
        // USER END
        break;
      // USER START (Optionally insert additional code for further notification handling)
      // USER END
      }
      break;
    case ID_EDIT_3: // Notifications sent by 'Edit'
      switch(NCode) {
      case WM_NOTIFICATION_CLICKED:
        // USER START (Optionally insert code for reacting on notification message)
        // USER END
        break;
      case WM_NOTIFICATION_RELEASED:
        // USER START (Optionally insert code for reacting on notification message)
        // USER END
        break;
      case WM_NOTIFICATION_VALUE_CHANGED:
        // USER START (Optionally insert code for reacting on notification message)
        // USER END
        break;
      // USER START (Optionally insert additional code for further notification handling)
      // USER END
      }
      break;
    case ID_EDIT_4: // Notifications sent by 'Edit'
      switch(NCode) {
      case WM_NOTIFICATION_CLICKED:
        // USER START (Optionally insert code for reacting on notification message)
        // USER END
        break;
      case WM_NOTIFICATION_RELEASED:
        // USER START (Optionally insert code for reacting on notification message)
        // USER END
        break;
      case WM_NOTIFICATION_VALUE_CHANGED:
        // USER START (Optionally insert code for reacting on notification message)
        // USER END
        break;
      // USER START (Optionally insert additional code for further notification handling)
      // USER END
      }
      break;
    case ID_EDIT_5: // Notifications sent by 'Edit'
      switch(NCode) {
      case WM_NOTIFICATION_CLICKED:
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
      // USER END
      }
      break;
    // USER START (Optionally insert additional code for further Ids)
    // USER END
    }
    break;
  // USER START (Optionally insert additional message handling)
  // USER END
  default:
    WM_DefaultProc(pMsg);
    break;
  }
}

/*********************************************************************
*
*       Public code
*
**********************************************************************
*/
/*********************************************************************
*
*       CreateWindow
*/
WM_HWIN CreateSettingsTempWnd(void) {
  WM_HWIN hWin;

  hWin = GUI_CreateDialogBox(_aDialogCreate, GUI_COUNTOF(_aDialogCreate), _cbDialog, WM_HBKWIN, 0, 0);
  return hWin;
}

// USER START (Optionally insert additional public code)
// USER END

/*************************** End of file ****************************/
