levichevdmitry/spirt_v2/control_module/src/stm32/dialog_wnd/testsEmWnd.c

/*********************************************************************
*                                                                    *
*                SEGGER Microcontroller GmbH & Co. KG                *
*        Solutions for real time microcontroller applications        *
*                                                                    *
**********************************************************************
*                                                                    *
* C-file generated by:                                               *
*                                                                    *
*        GUI_Builder for emWin version 5.32                          *
*        Compiled Oct  8 2015, 11:59:02                              *
*        (c) 2015 Segger Microcontroller GmbH & Co. KG               *
*                                                                    *
**********************************************************************
*                                                                    *
*        Internet: www.segger.com  Support: support@segger.com       *
*                                                                    *
**********************************************************************
*/

// USER START (Optionally insert additional includes)
// USER END

#include "windows.h"

/*********************************************************************
*
*       Defines
*
**********************************************************************
*/
#define ID_WINDOW_0  (GUI_ID_USER + 0x00)
#define ID_BUTTON_0  (GUI_ID_USER + 0x01)
#define ID_TEXT_0  (GUI_ID_USER + 0x02)
#define ID_TEXT_8  (GUI_ID_USER + 0x03)
#define ID_BUTTON_1  (GUI_ID_USER + 0x04)
#define ID_BUTTON_2  (GUI_ID_USER + 0x05)
#define ID_TEXT_1  (GUI_ID_USER + 0x06)
#define ID_TEXT_2  (GUI_ID_USER + 0x07)
#define ID_TEXT_3  (GUI_ID_USER + 0x08)
#define ID_TEXT_4  (GUI_ID_USER + 0x09)
#define ID_TEXT_5  (GUI_ID_USER + 0x0A)
#define ID_TEXT_6  (GUI_ID_USER + 0x0B)
#define ID_TEXT_7  (GUI_ID_USER + 0x0C)
#define ID_BUTTON_3  (GUI_ID_USER + 0x0D)
#define ID_BUTTON_4  (GUI_ID_USER + 0x0E)
#define ID_BUTTON_5  (GUI_ID_USER + 0x0F)
#define ID_BUTTON_6  (GUI_ID_USER + 0x10)
#define ID_BUTTON_7  (GUI_ID_USER + 0x11)
#define ID_BUTTON_8  (GUI_ID_USER + 0x12)
#define ID_BUTTON_9  (GUI_ID_USER + 0x13)
#define ID_BUTTON_10  (GUI_ID_USER + 0x14)
#define ID_BUTTON_11  (GUI_ID_USER + 0x15)
#define ID_BUTTON_12  (GUI_ID_USER + 0x16)
#define ID_BUTTON_13  (GUI_ID_USER + 0x17)
#define ID_BUTTON_14  (GUI_ID_USER + 0x18)
#define ID_BUTTON_15  (GUI_ID_USER + 0x19)
#define ID_BUTTON_16  (GUI_ID_USER + 0x1A)
#define ID_BUTTON_17  (GUI_ID_USER + 0x1B)
#define ID_BUTTON_18  (GUI_ID_USER + 0x1C)
#define ID_BUTTON_19  (GUI_ID_USER + 0x1D)
#define ID_BUTTON_20  (GUI_ID_USER + 0x1E)
#define ID_TIMER_CONVERT_MONITOR (GUI_ID_USER + 0x1F)
#define ID_EDIT_0  (GUI_ID_USER + 0x20)
#define ID_EDIT_1  (GUI_ID_USER + 0x21)
#define ID_EDIT_2  (GUI_ID_USER + 0x22)
#define ID_EDIT_3  (GUI_ID_USER + 0x23)
#define ID_EDIT_4  (GUI_ID_USER + 0x24) 
#define ID_SPINBOX_0  (GUI_ID_USER + 0x25)


// USER START (Optionally insert additional defines)
// USER END

/*********************************************************************
*
*       Static data
*
**********************************************************************
*/

// USER START (Optionally insert additional static data)
// USER END
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
