levichevdmitry/spirt_v2/(commit log)

2018-01-27 Add new version for Wi-Fi module and add stm32 code for power and control units
2018-11-18 Add hardware project files
    [CPUBoard_p1.SchDoc, CPUBoard_p2.SchDoc, CPUBoard_p3.SchDoc, CPU_Board.PrjPCB, Connection_diagram.spl7, Connection_diagram_rev_A.spl7, Connection_diagram_rev_B.spl7, ControlBoard.PrjPCB]
2018-11-18 Add 3d project files
    [lcd tft 50.SLDPRT, Крепление кабеля.ipt, Крепление кабеля.stl, Стойка_1.ipt, Стойка_16мм.0001.ipt, Стойка_16мм.ipt, Стойка_16мм.stl, Стойка_6мм.ipt]
